Ultimaker/Ultimaker3Extended/1011/1011-E/1011-E.STEP

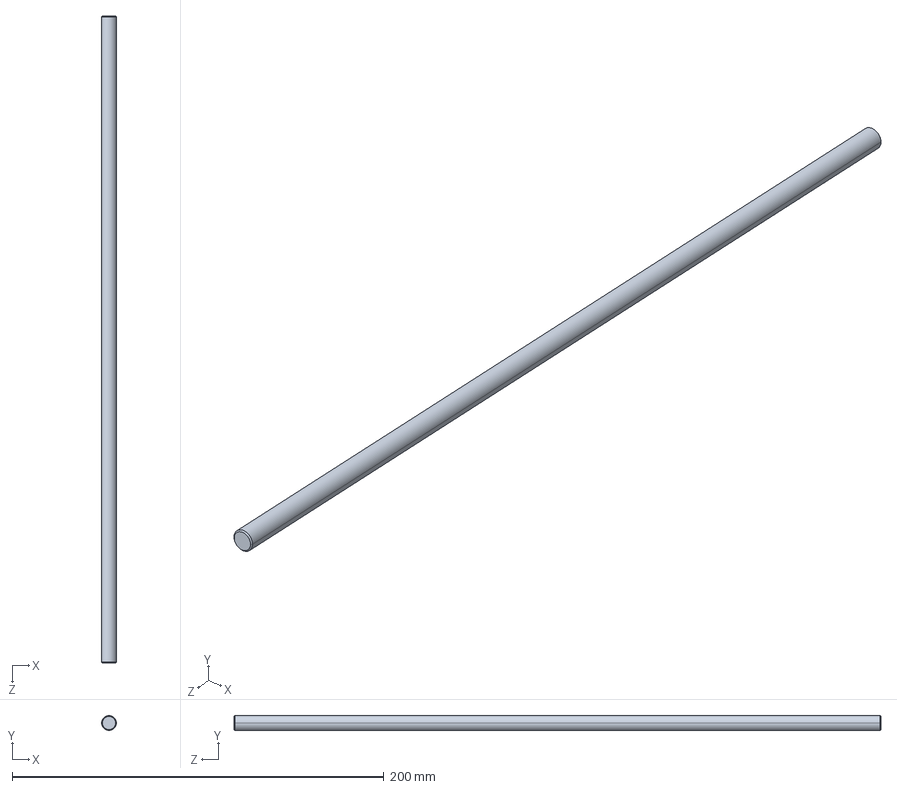
[picture p1: CAD file, 2017-10-18]
1011/1011-E/1011-E.STEP
8.00 x 8.00 x 348.0 mm
