Ultimaker/Ultimaker3Extended/1012/1012-E/1012-E.STEP

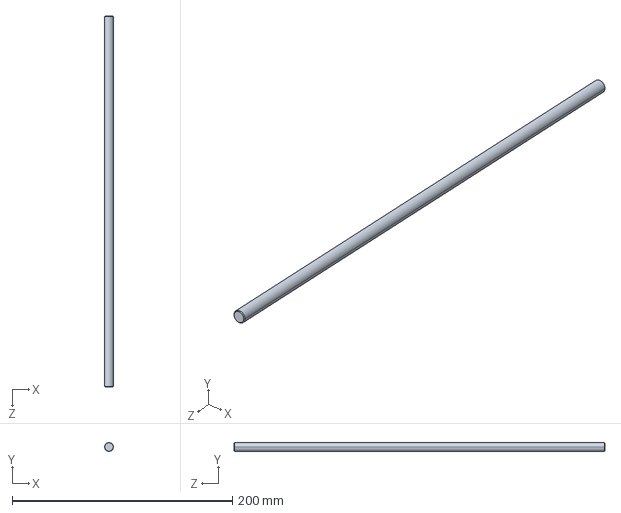
[picture p2: CAD file, 2017-10-18]
1012/1012-E/1012-E.STEP
8.00 x 8.00 x 337.0 mm
