Ultimaker/Ultimaker3Extended/1024/1024-F/1024-F.STEP

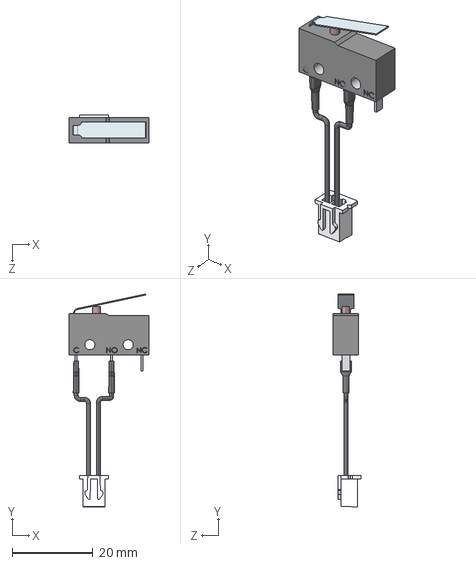
[picture p3: CAD file, 2017-10-18]
1024/1024-F/1024-F.STEP
19.8 x 52.9 x 6.90 mm
