Ultimaker/Ultimaker3Extended/1056/1056-B/1056-B.STEP

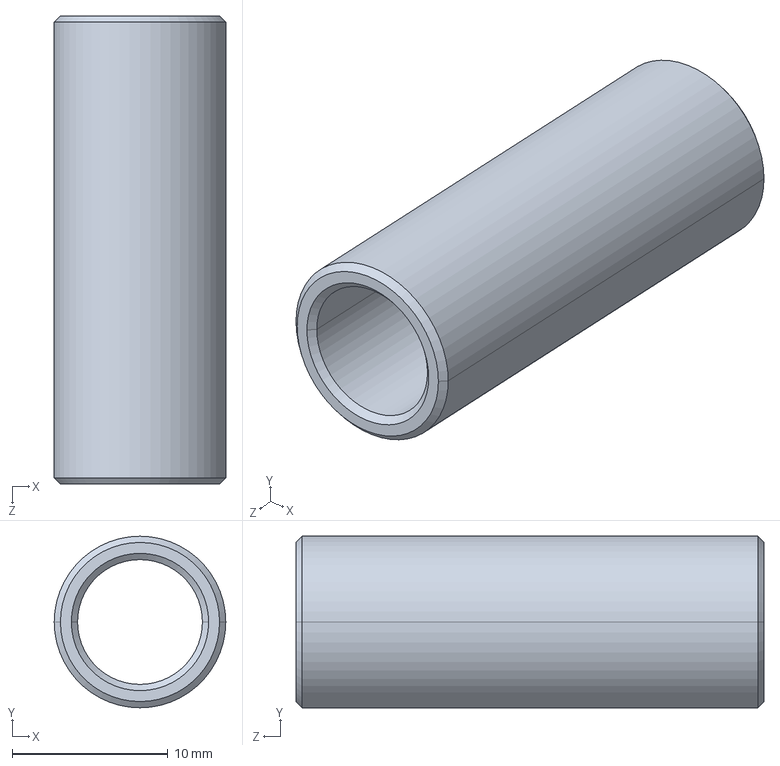
[picture p4: CAD file, 2017-10-18]
1056/1056-B/1056-B.STEP
11.0 x 11.0 x 30.0 mm
