Ultimaker/Ultimaker3Extended/1069/1069-C/1069-C.STEP

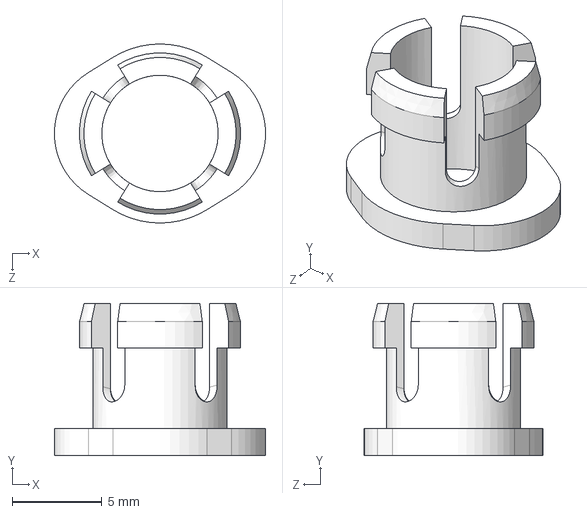
[picture p5: CAD file, 2017-10-18]
1069/1069-C/1069-C.STEP
11.8 x 8.50 x 10.00 mm
