Ultimaker/Ultimaker3Extended/1083/1083-A/1083-Z1P-A.STEP

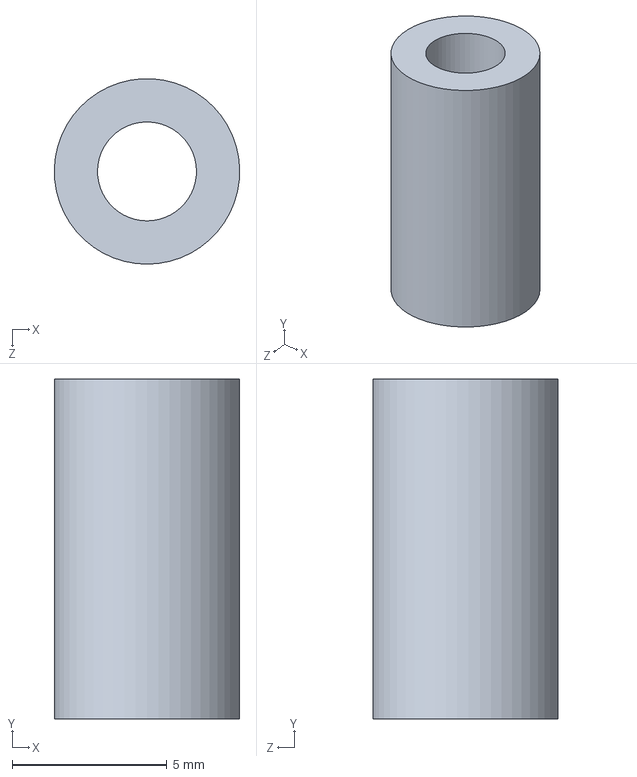
[picture p6: CAD file, 2017-10-18]
1083/1083-A/1083-Z1P-A.STEP
6.00 x 11.0 x 5.99 mm
