Ultimaker/Ultimaker3Extended/1155/1155-G/1155-G.STEP

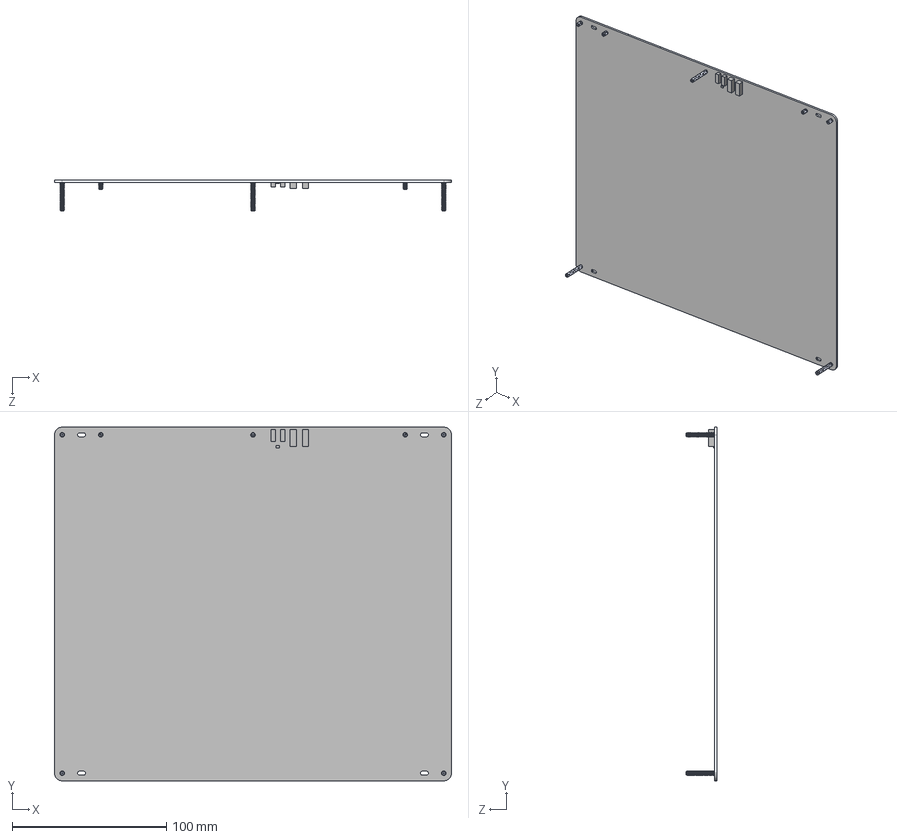
[picture p7: CAD file, 2017-10-18]
1155/1155-G/1155-G.STEP
257.0 x 229.0 x 20.0 mm
1155-D
FH-M3-xZI_FH-M3-6ZI x 4
FH-M3-xZI_FH-M3-20ZI x 3
