Ultimaker/Ultimaker3Extended/1156/1156-B/1156-B.STEP

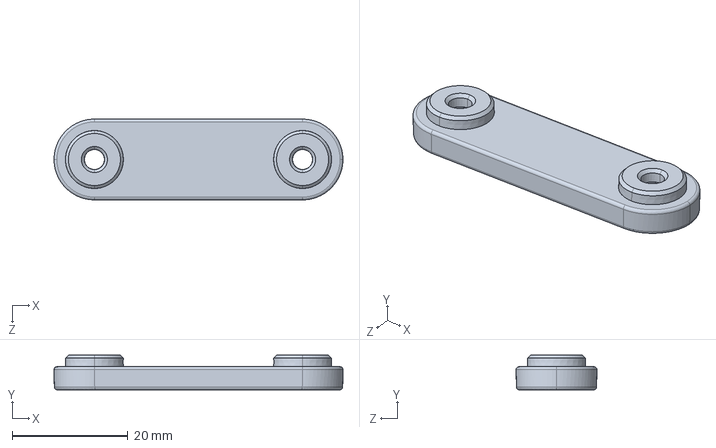
[picture p8: CAD file, 2017-10-18]
1156/1156-B/1156-B.STEP
50.0 x 6.00 x 14.0 mm
