Ultimaker/Ultimaker3Extended/1165/1165-B/1165-B.STEP

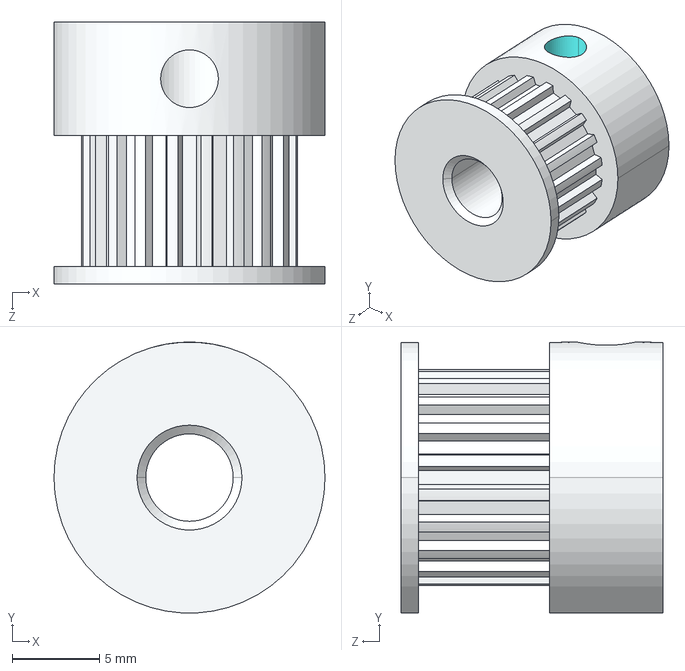
[picture p9: CAD file, 2017-10-18]
1165/1165-B/1165-B.STEP
15.5 x 15.5 x 15.0 mm
