Ultimaker/Ultimaker3Extended/1166/1166-C/1166-C.STEP

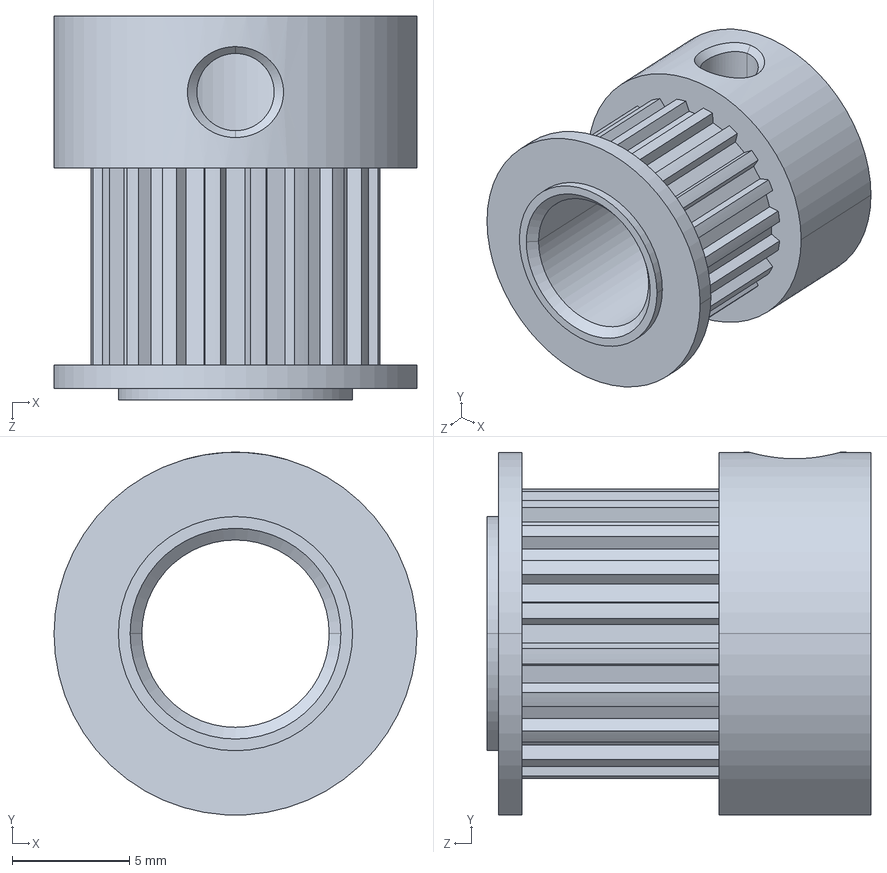
[picture p10: CAD file, 2017-10-18]
1166/1166-C/1166-C.STEP
15.5 x 15.5 x 16.4 mm
