Ultimaker/Ultimaker3Extended/1167/1167-E/1167-E.STEP

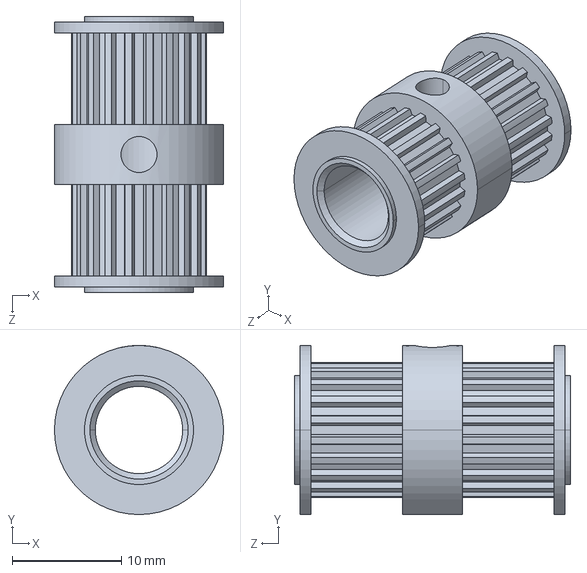
[picture p11: CAD file, 2017-10-18]
1167/1167-E/1167-E.STEP
15.5 x 15.5 x 25.3 mm
