Ultimaker/Ultimaker3Extended/1168/1168-C/1168-C.STEP

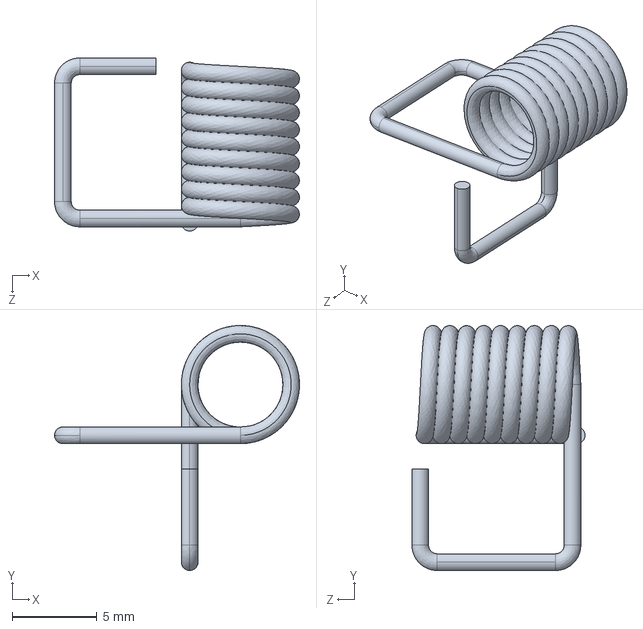
[picture p12: CAD file, 2017-10-18]
1168/1168-C/1168-C.STEP
14.5 x 14.5 x 10.2 mm
