Ultimaker/Ultimaker3Extended/1170/1170-C/1170-C.STEP

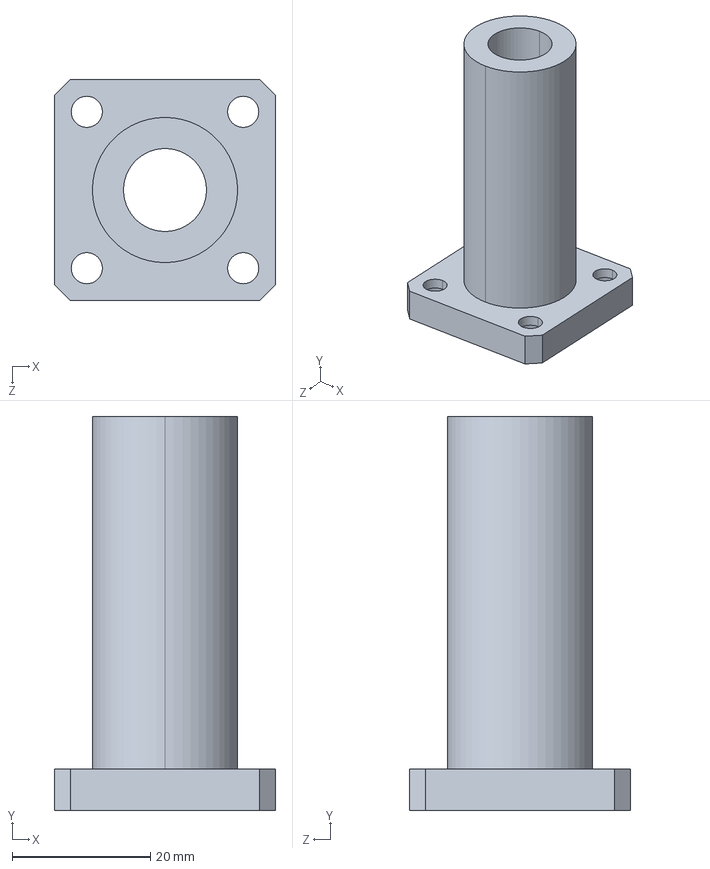
[picture p13: CAD file, 2017-10-18]
1170/1170-C/1170-C.STEP
32.0 x 57.0 x 32.0 mm
