Ultimaker/Ultimaker3Extended/1172/1172-B/1172-B.STEP

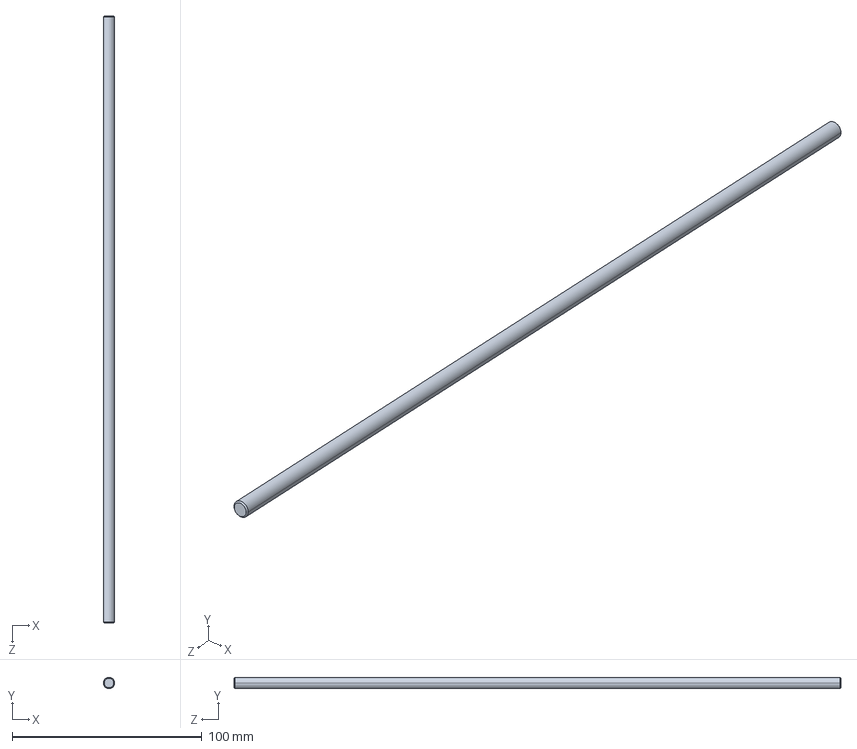
[picture p14: CAD file, 2017-10-18]
1172/1172-B/1172-B.STEP
6.00 x 6.00 x 320.0 mm
