Ultimaker/Ultimaker3Extended/1174/1174-A/1174-A.STEP

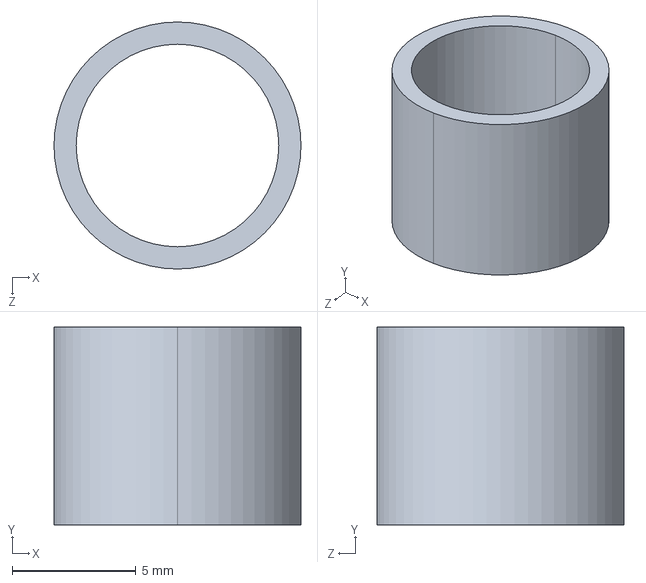
[picture p15: CAD file, 2017-10-18]
1174/1174-A/1174-A.STEP
10.00 x 8.00 x 10.00 mm
