Ultimaker/Ultimaker3Extended/1175/1175-A/1175-A.STEP

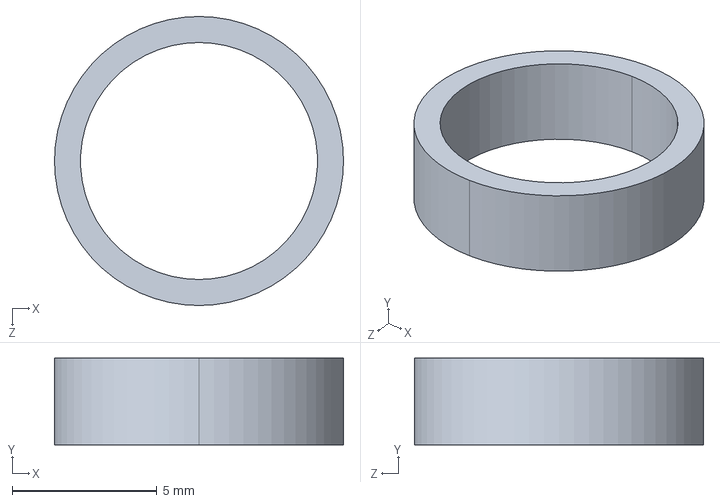
[picture p16: CAD file, 2017-10-18]
1175/1175-A/1175-A.STEP
10.00 x 3.00 x 10.00 mm
