Ultimaker/Ultimaker3Extended/1178/1178-B/1178-B.STEP

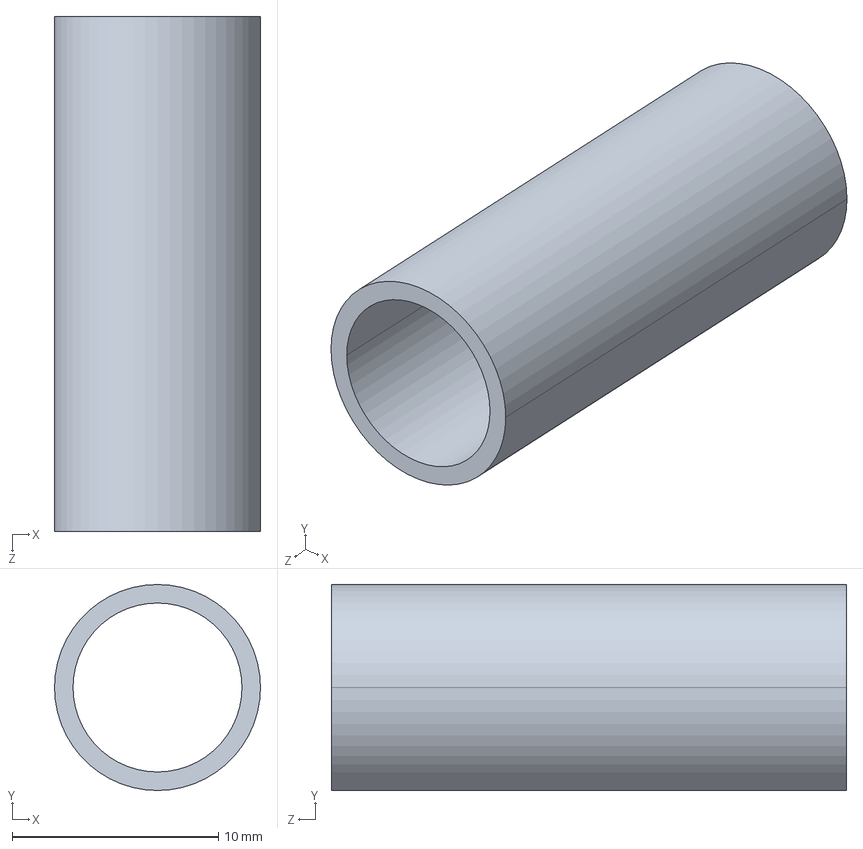
[picture p17: CAD file, 2017-10-18]
1178/1178-B/1178-B.STEP
10.0 x 10.0 x 25.0 mm
