Ultimaker/Ultimaker3Extended/1187/1187-B/1187-B.STEP

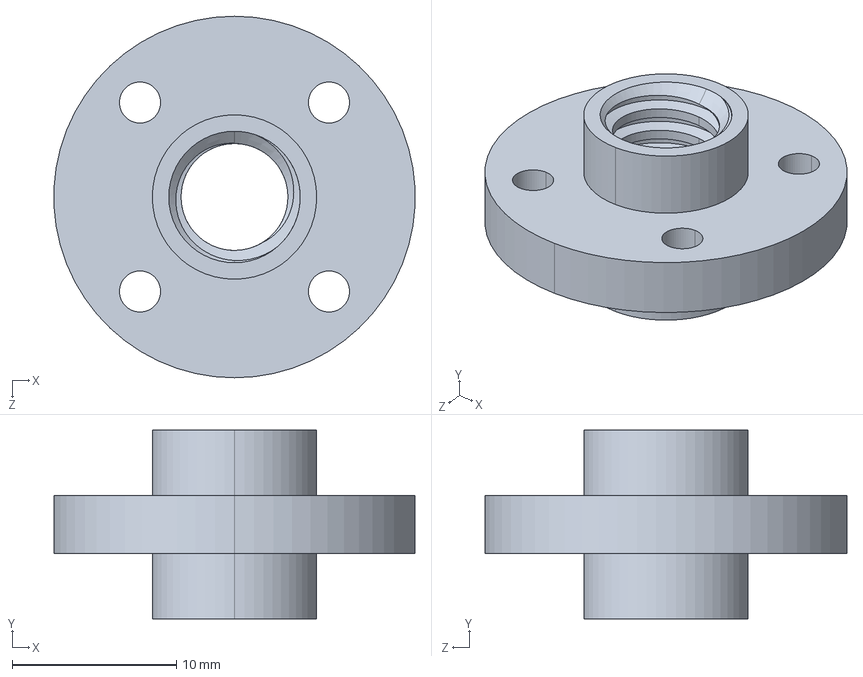
[picture p18: CAD file, 2017-10-18]
1187/1187-B/1187-B.STEP
22.0 x 11.5 x 22.0 mm
