Ultimaker/Ultimaker3Extended/1188/1188-A/1188-B2P-A.STEP

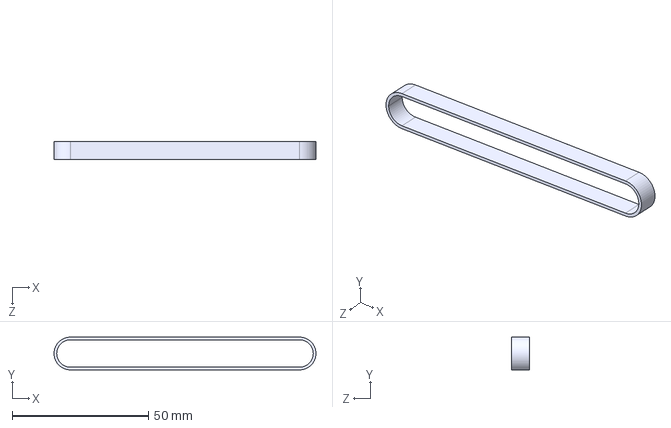
[picture p19: CAD file, 2017-10-18]
1188/1188-A/1188-B2P-A.STEP
96.0 x 12.0 x 6.50 mm
