Ultimaker/Ultimaker3Extended/1200/1200-B/1200-B.STEP

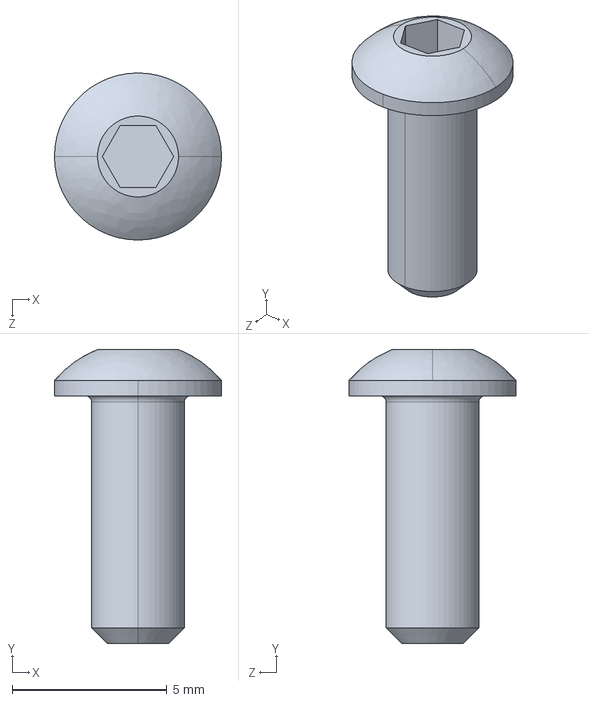
[picture p20: CAD file, 2017-10-18]
1200/1200-B/1200-B.STEP
5.40 x 9.50 x 5.40 mm
