Ultimaker/Ultimaker3Extended/1201/1201-D/1201-D.STEP

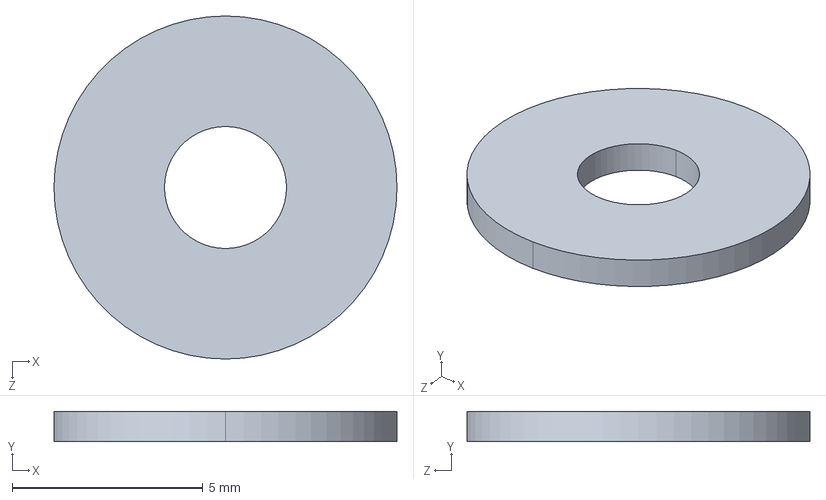
[picture p21: CAD file, 2017-10-18]
1201/1201-D/1201-D.STEP
9.00 x 0.8 x 9.00 mm
