Ultimaker/Ultimaker3Extended/1202/1202-C/1202-C.STEP

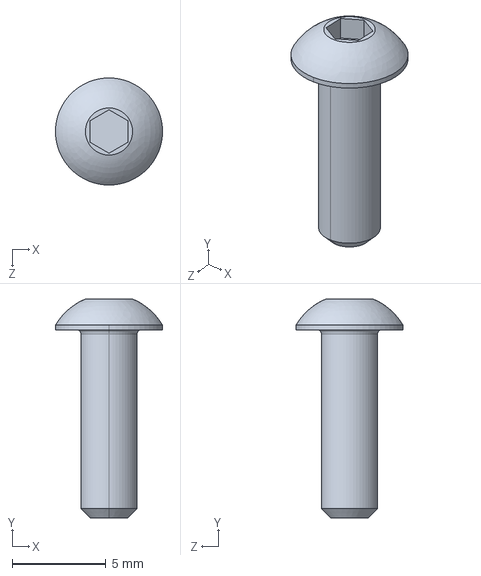
[picture p22: CAD file, 2017-10-18]
1202/1202-C/1202-C.STEP
5.70 x 11.7 x 5.70 mm
