Ultimaker/Ultimaker3Extended/1203/1203-C/1203-C.STEP

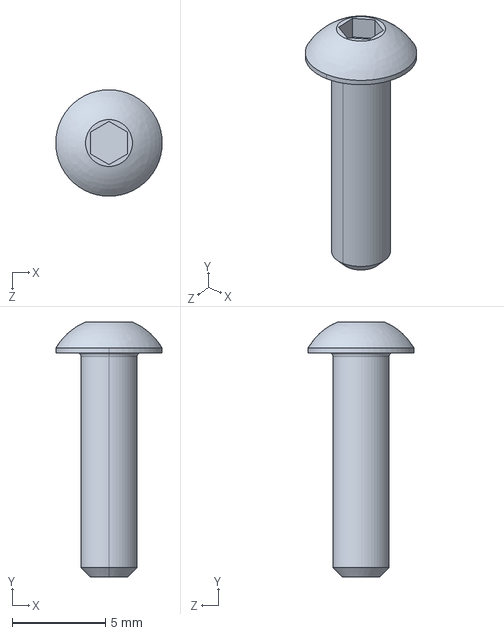
[picture p23: CAD file, 2017-10-18]
1203/1203-C/1203-C.STEP
5.70 x 13.7 x 5.70 mm
