Ultimaker/Ultimaker3Extended/1204/1204-C/1204-C.STEP

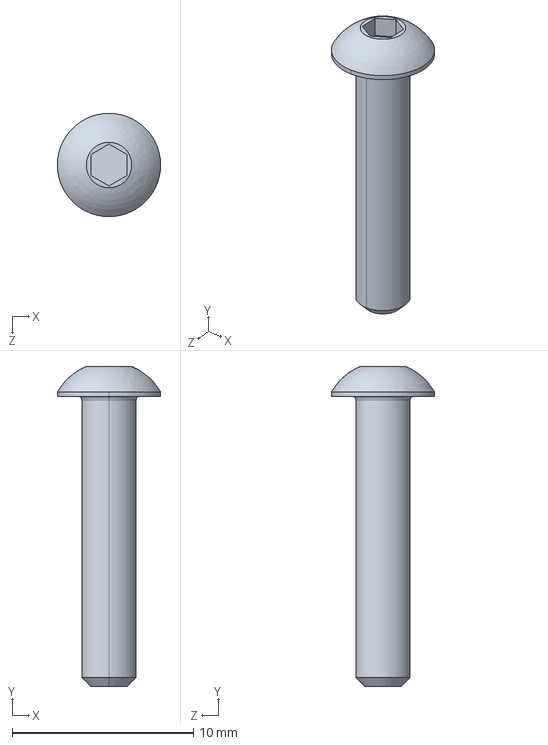
[picture p24: CAD file, 2017-10-18]
1204/1204-C/1204-C.STEP
5.70 x 17.7 x 5.70 mm
