Ultimaker/Ultimaker3Extended/1205/1205-C/1205-C.STEP

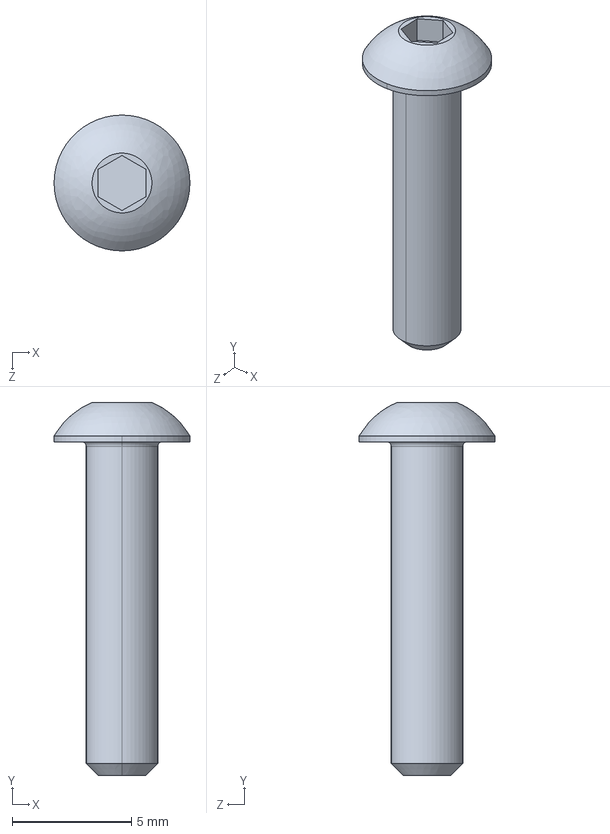
[picture p25: CAD file, 2017-10-18]
1205/1205-C/1205-C.STEP
5.70 x 15.7 x 5.70 mm
