Ultimaker/Ultimaker3Extended/1206/1206-C/1206-C.STEP

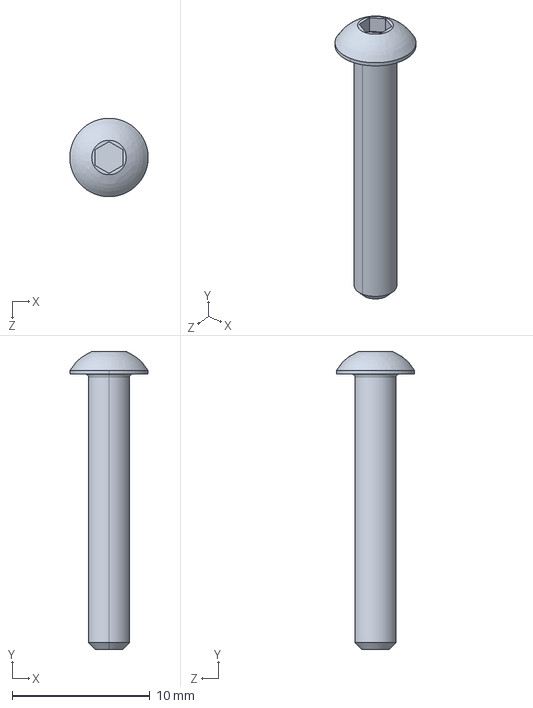
[picture p26: CAD file, 2017-10-18]
1206/1206-C/1206-C.STEP
5.70 x 21.7 x 5.70 mm
