Ultimaker/Ultimaker3Extended/1207/1207-C/1207-C.STEP

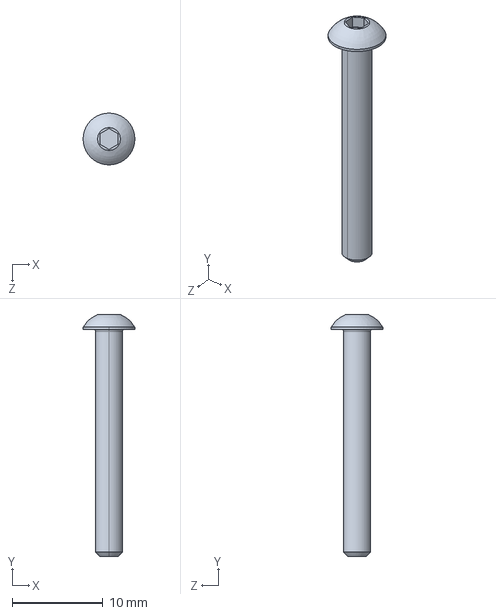
[picture p27: CAD file, 2017-10-18]
1207/1207-C/1207-C.STEP
5.70 x 26.6 x 5.70 mm
