Ultimaker/Ultimaker3Extended/1209/1209-D/1209-D.STEP

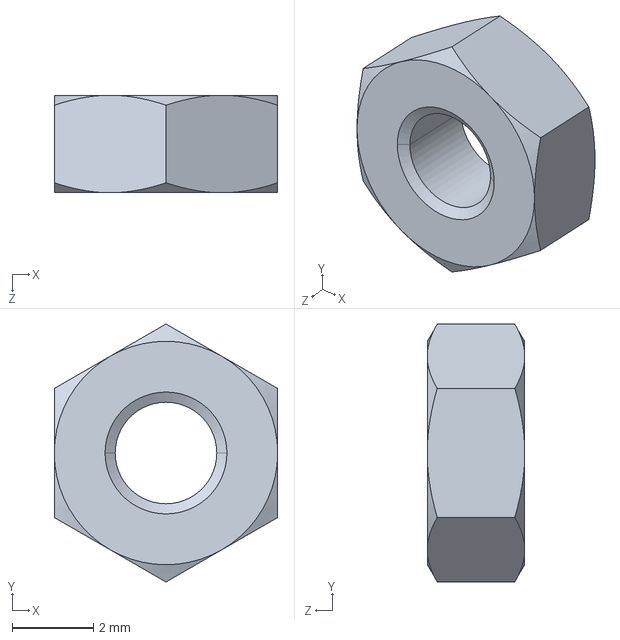
[picture p28: CAD file, 2017-10-18]
1209/1209-D/1209-D.STEP
5.50 x 6.35 x 2.40 mm
