Ultimaker/Ultimaker3Extended/1213/1213-C/1213-C.STEP

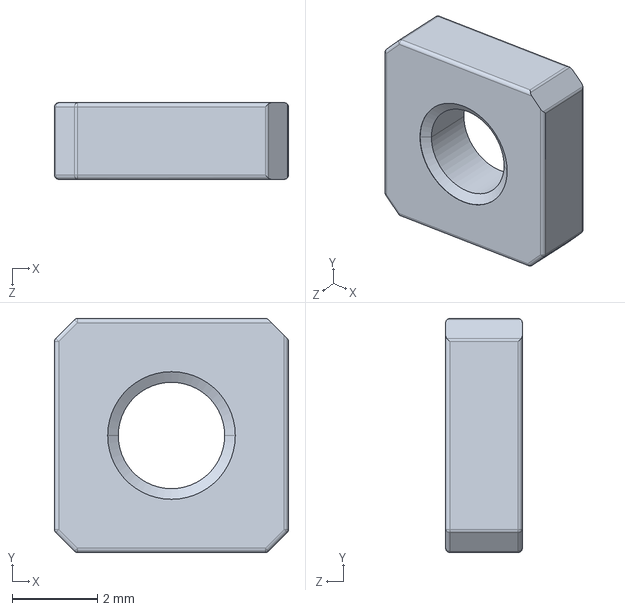
[picture p29: CAD file, 2017-10-18]
1213/1213-C/1213-C.STEP
5.50 x 5.50 x 1.80 mm
