Ultimaker/Ultimaker3Extended/1214/1214-B/1214-B.STEP

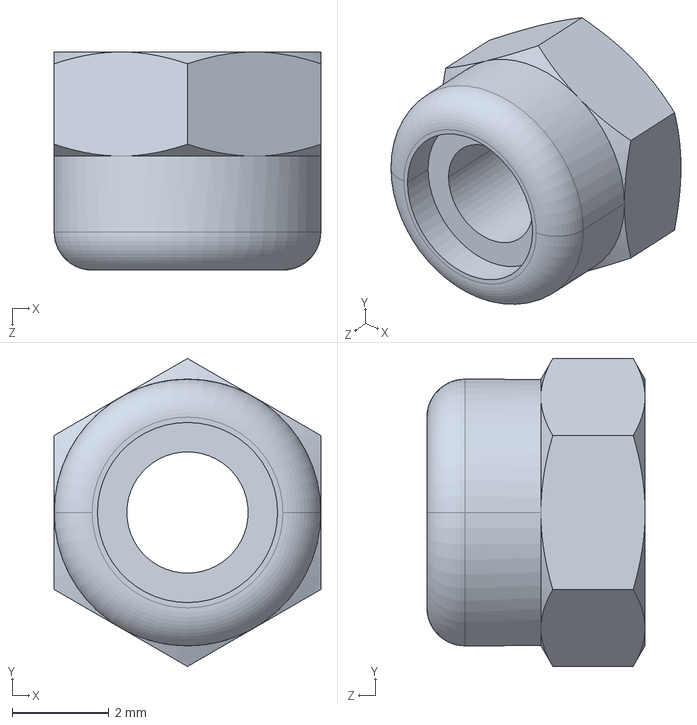
[picture p30: CAD file, 2017-10-18]
1214/1214-B/1214-B.STEP
5.50 x 6.35 x 4.50 mm
