Ultimaker/Ultimaker3Extended/1217/1217-B/1217-B.STEP

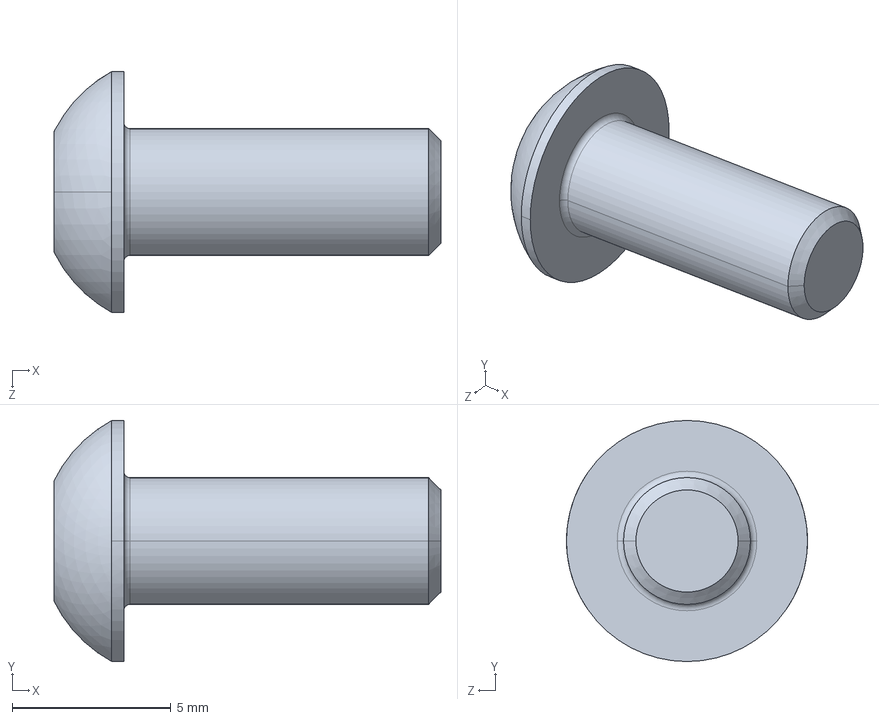
[picture p31: CAD file, 2017-10-18]
1217/1217-B/1217-B.STEP
12.2 x 7.60 x 7.60 mm
