Ultimaker/Ultimaker3Extended/1220/1220-B/1220-B.STEP

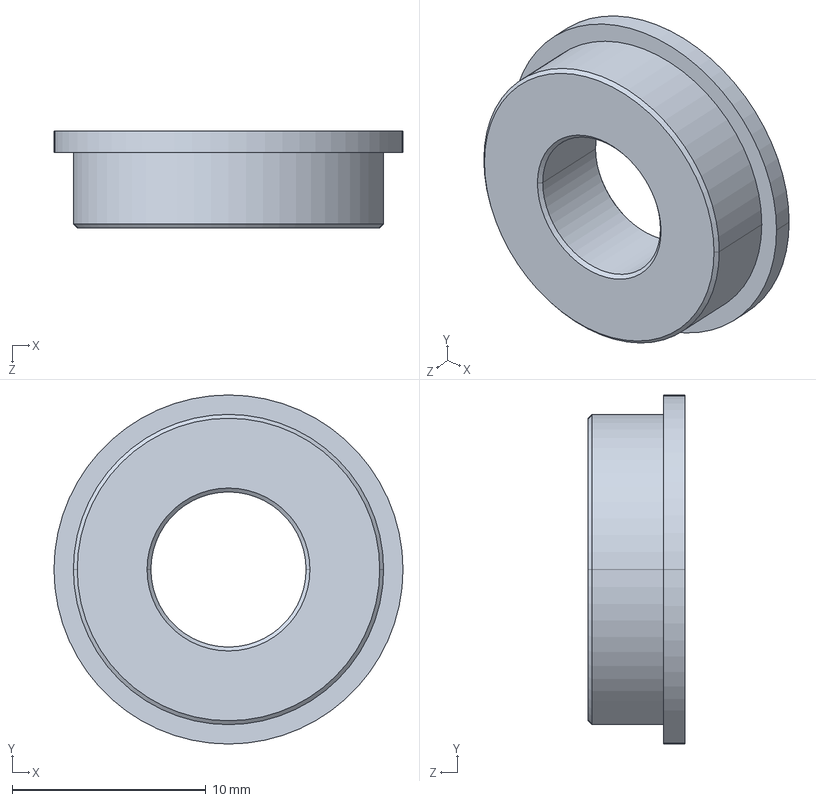
[picture p32: CAD file, 2017-10-18]
1220/1220-B/1220-B.STEP
18.0 x 18.0 x 5.00 mm
