Ultimaker/Ultimaker3Extended/1241/1241-C/1241-C.STEP

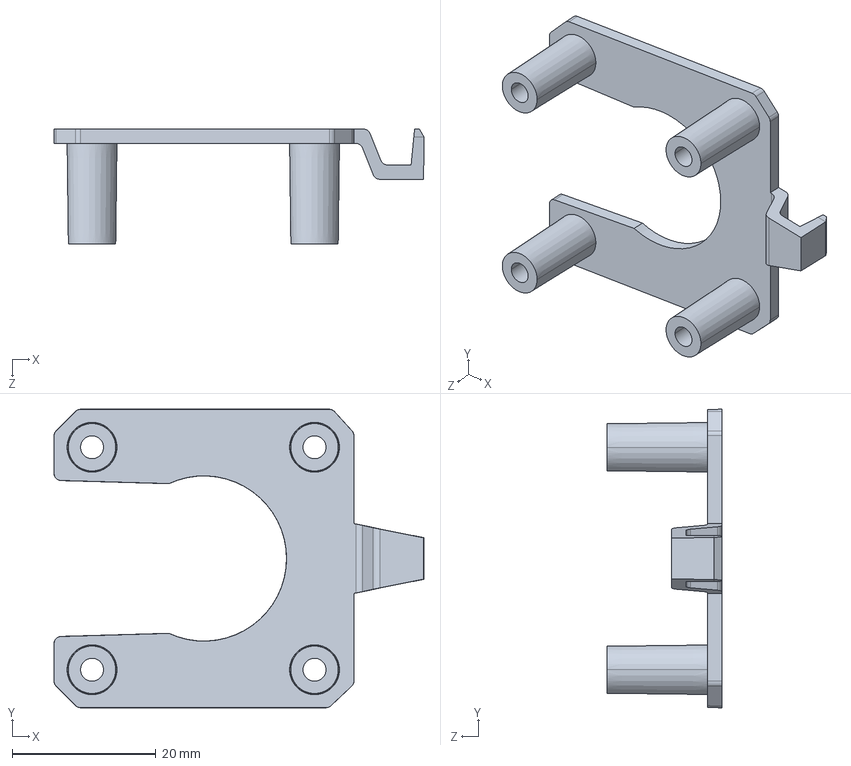
[picture p33: CAD file, 2017-10-18]
1241/1241-C/1241-C.STEP
51.6 x 41.6 x 16.0 mm
