Ultimaker/Ultimaker3Extended/1244/1244-B/1244-B.STEP

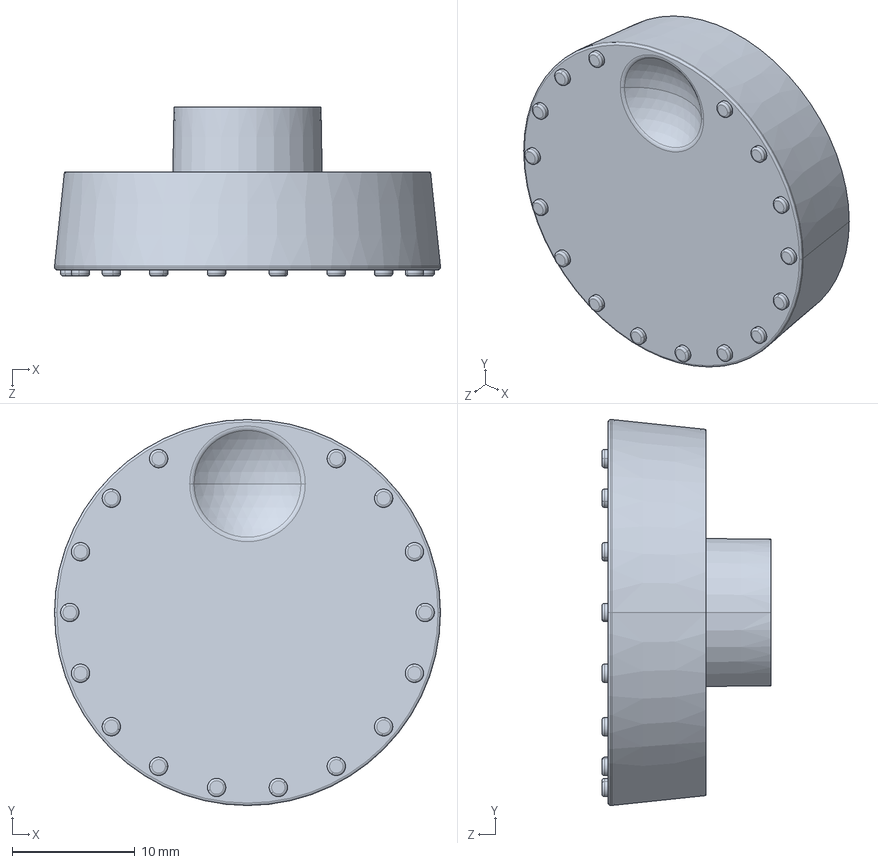
[picture p34: CAD file, 2017-10-18]
1244/1244-B/1244-B.STEP
31.5 x 31.5 x 13.8 mm
