Ultimaker/Ultimaker3Extended/1245/1245-D/1245-D.STEP

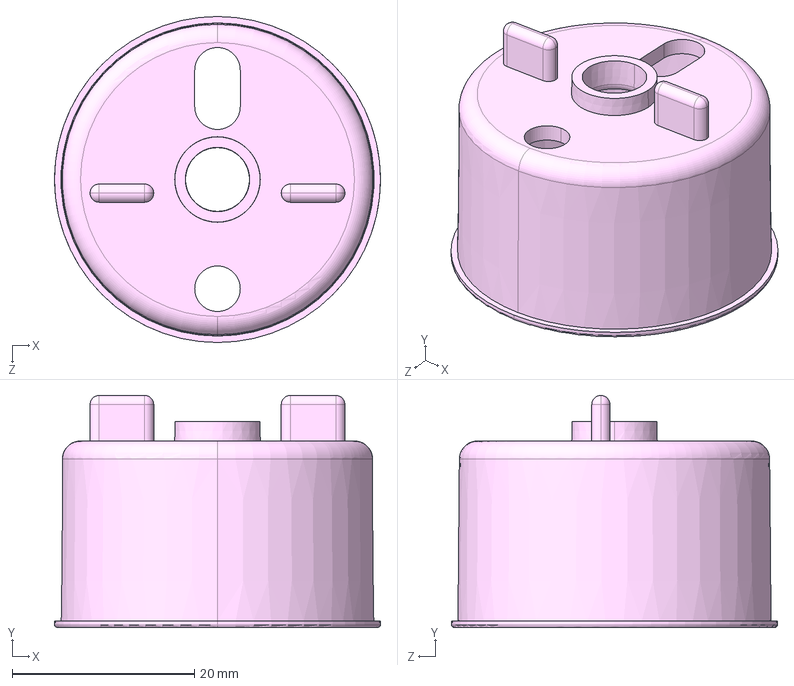
[picture p35: CAD file, 2017-10-18]
1245/1245-D/1245-D.STEP
35.8 x 25.5 x 35.8 mm
