Ultimaker/Ultimaker3Extended/1252/1252-D/1252-D.STEP

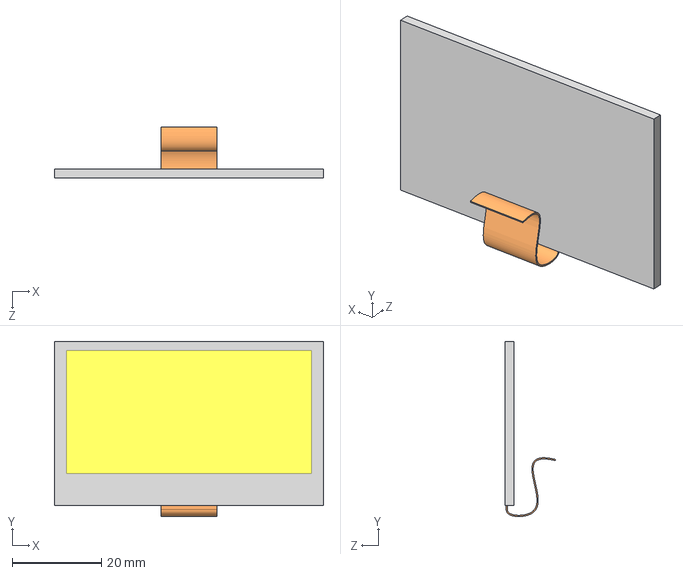
[picture p36: CAD file, 2017-10-18]
1252/1252-D/1252-D.STEP
60.3 x 39.3 x 11.3 mm
