Ultimaker/Ultimaker3Extended/1255/1255-B/1255-B.STEP

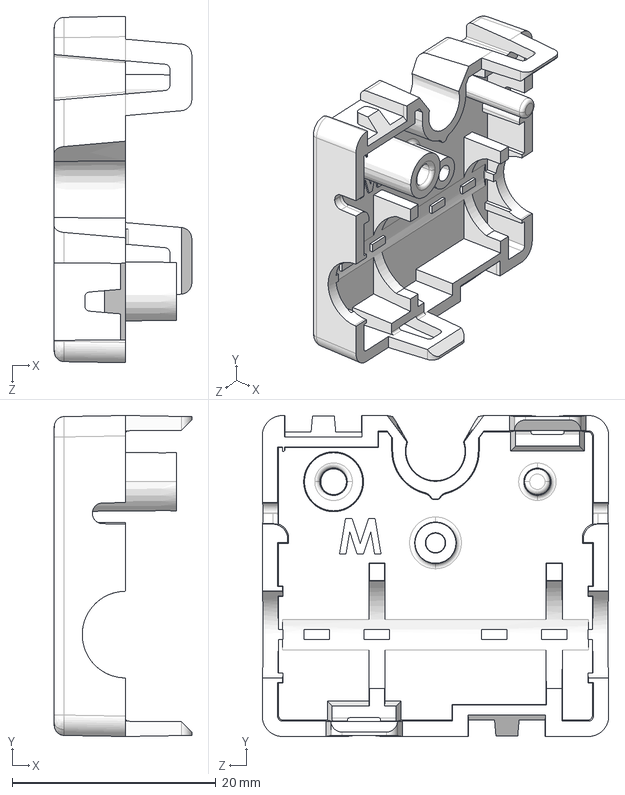
[picture p37: CAD file, 2017-10-18]
1255/1255-B/1255-B.STEP
13.5 x 31.5 x 34.0 mm
