Ultimaker/Ultimaker3Extended/1256/1256-B/1256-B.STEP

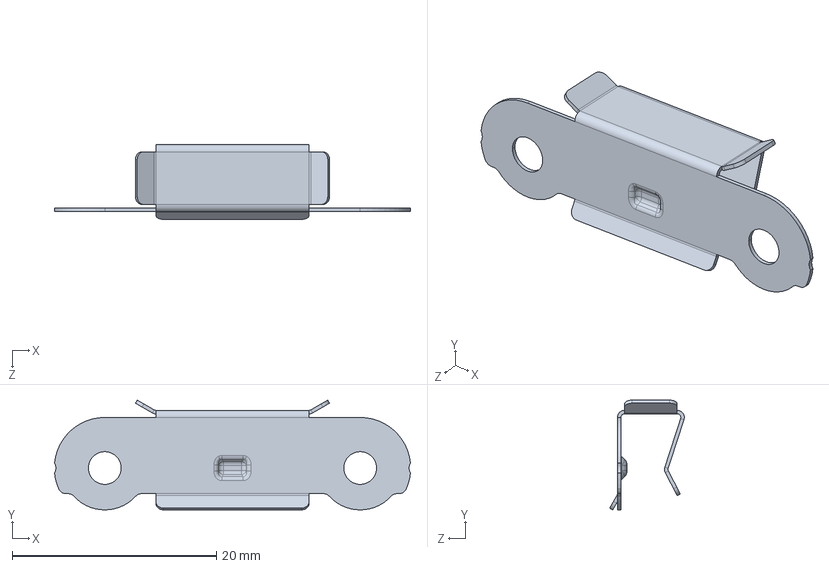
[picture p38: CAD file, 2017-10-18]
1256/1256-B/1256-B.STEP
34.8 x 10.7 x 7.32 mm
