Ultimaker/Ultimaker3Extended/1266/1266-D/1266-D.STEP

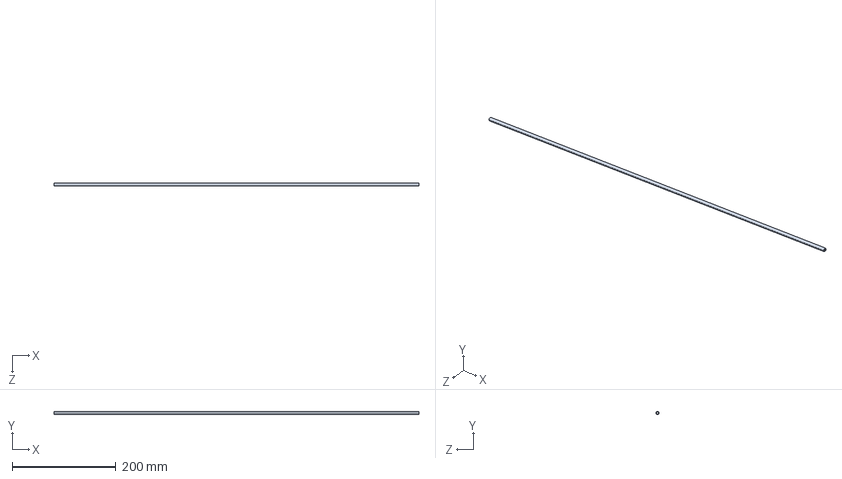
[picture p39: CAD file, 2017-10-18]
1266/1266-D/1266-D.STEP
705.0 x 6.35 x 6.35 mm
