Ultimaker/Ultimaker3Extended/1279/1279-D/1279-D.STEP

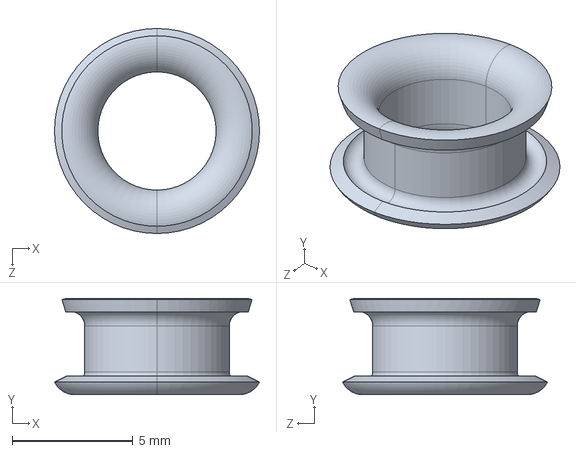
[picture p40: CAD file, 2017-10-18]
1279/1279-D/1279-D.STEP
8.50 x 4.00 x 8.50 mm
