Ultimaker/Ultimaker3Extended/1287/1287-B/1287-B.STEP

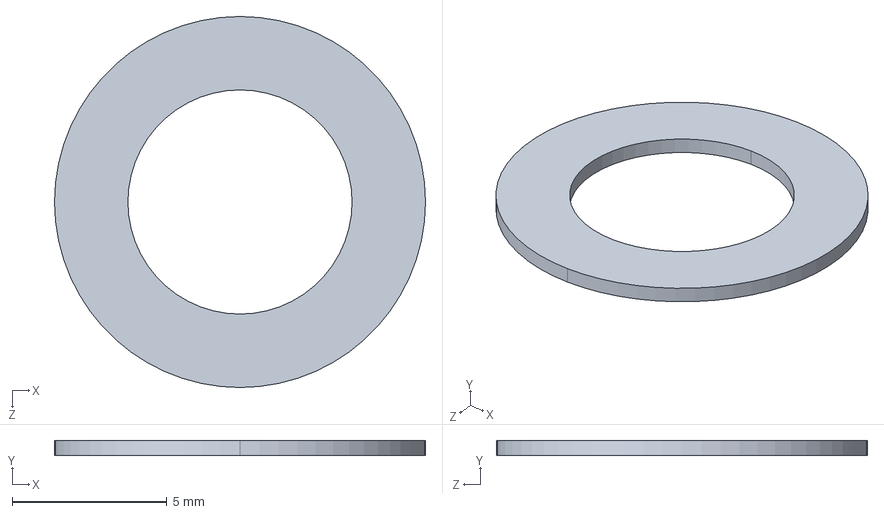
[picture p41: CAD file, 2017-10-18]
1287/1287-B/1287-B.STEP
12.0 x 0.5 x 12.0 mm
