Ultimaker/Ultimaker3Extended/1288/1288-B/1288-B.STEP

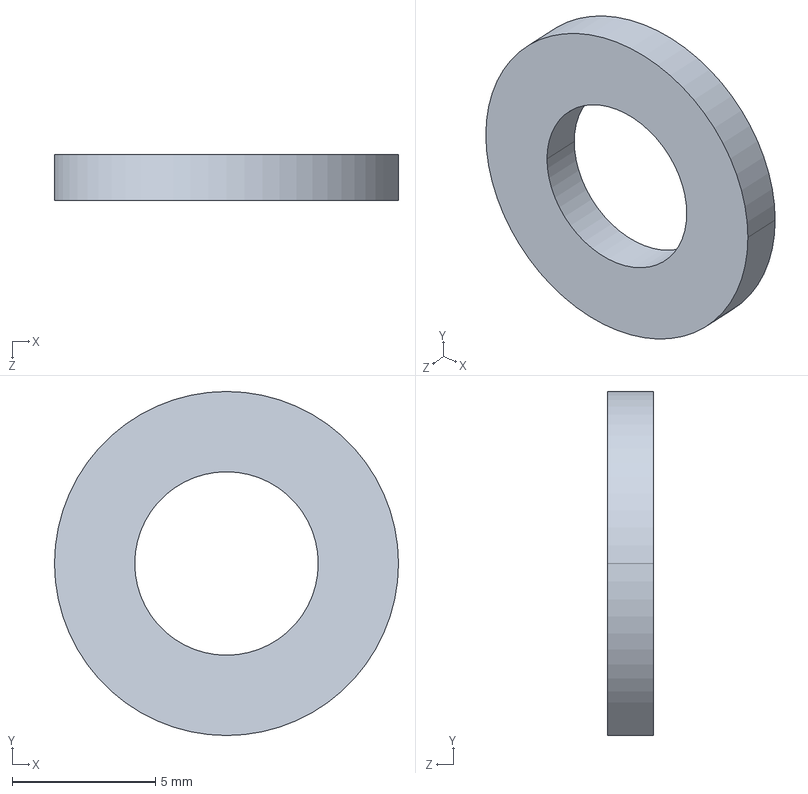
[picture p42: CAD file, 2017-10-18]
1288/1288-B/1288-B.STEP
12.0 x 12.0 x 1.60 mm
