Ultimaker/Ultimaker3Extended/1292/1292-A/1292-A.STEP

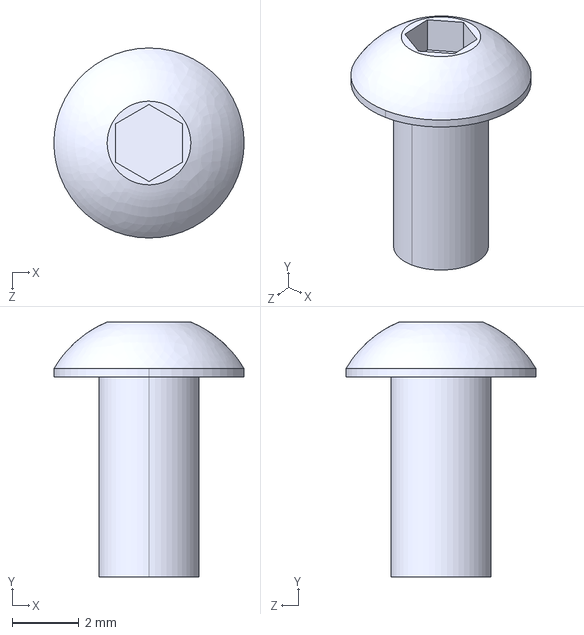
[picture p43: CAD file, 2017-10-18]
1292/1292-A/1292-A.STEP
5.70 x 7.65 x 5.70 mm
