Ultimaker/Ultimaker3Extended/1294/1294-B/1294-B.STEP

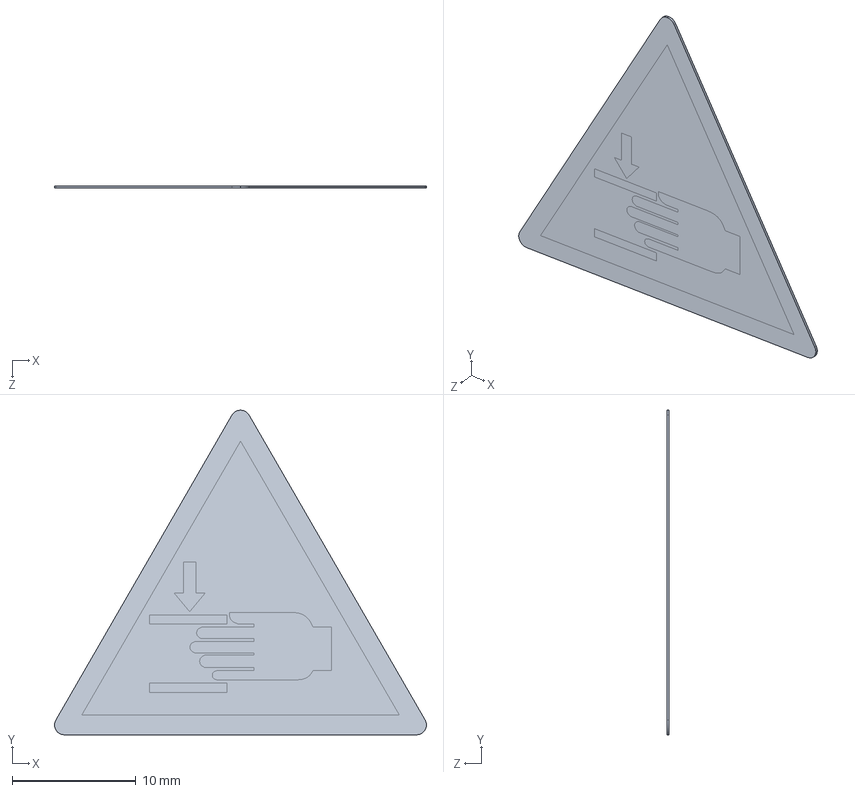
[picture p44: CAD file, 2017-10-18]
1294/1294-B/1294-B.STEP
30.0 x 26.2 x 0.2 mm
