Ultimaker/Ultimaker3Extended/1315/1315-B/1315-B.STEP

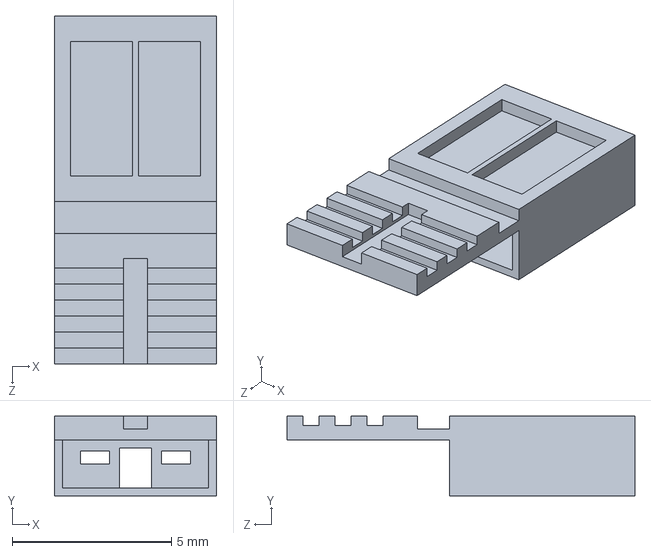
[picture p45: CAD file, 2017-10-18]
1315/1315-B/1315-B.STEP
5.08 x 2.50 x 10.9 mm
