Ultimaker/Ultimaker3Extended/1354/1354-B/1354-B.STEP

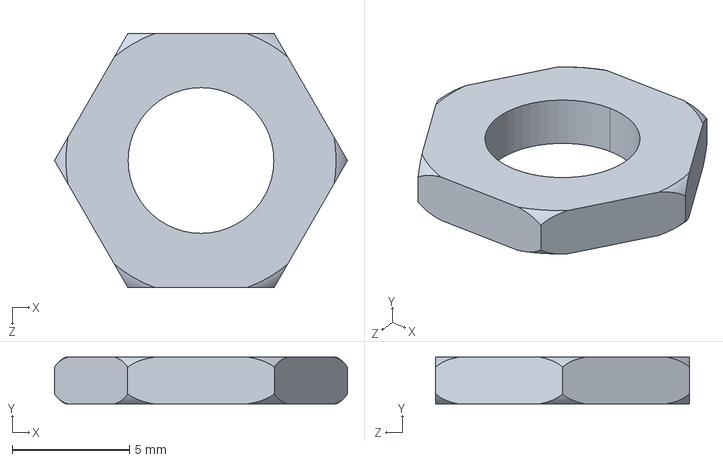
[picture p46: CAD file, 2017-10-18]
1354/1354-B/1354-B.STEP
12.5 x 2.00 x 10.8 mm
