Ultimaker/Ultimaker3Extended/1363/1363-D/1363-D.STEP

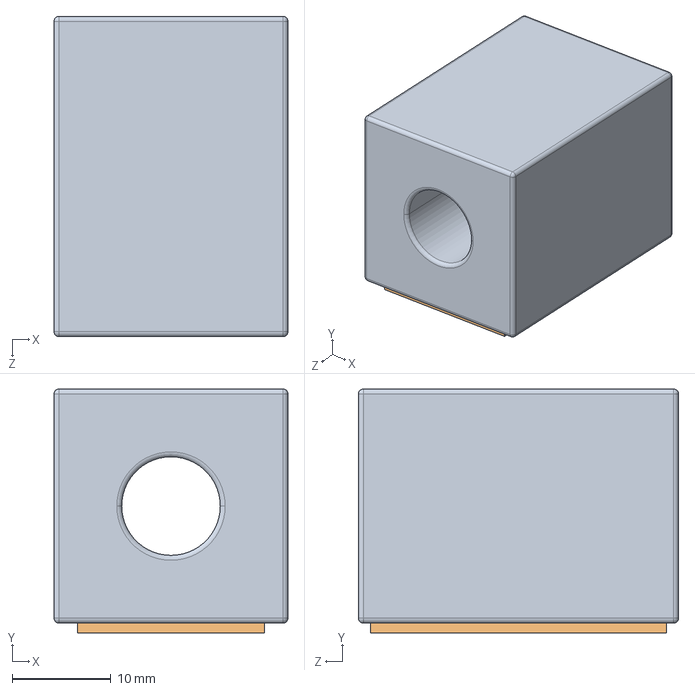
[picture p47: CAD file, 2017-10-18]
1363/1363-D/1363-D.STEP
23.8 x 24.8 x 32.5 mm
