Ultimaker/Ultimaker3Extended/1479/1479-B/1479-B.STEP

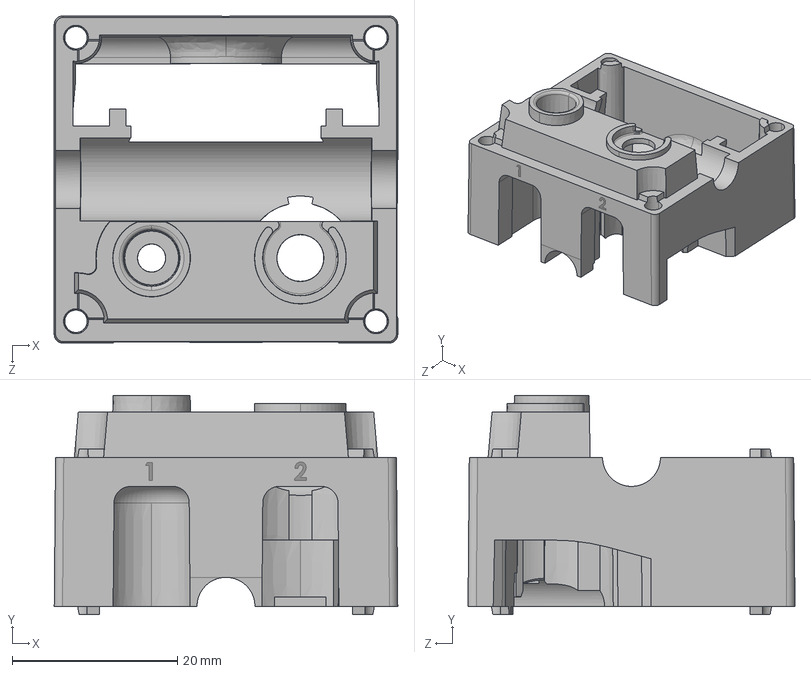
[picture p48: CAD file, 2017-10-18]
1479/1479-B/1479-B.STEP
41.6 x 26.5 x 39.6 mm
