Ultimaker/Ultimaker3Extended/1480/1480-B/1480-B.STEP

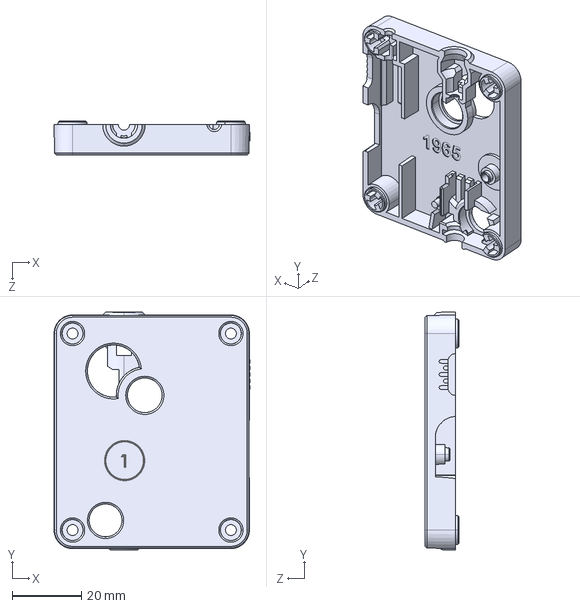
[picture p49: CAD file, 2017-10-18]
1480/1480-B/1480-B.STEP
56.4 x 68.5 x 9.75 mm
