Ultimaker/Ultimaker3Extended/1482/1482-B/1482-B.STEP

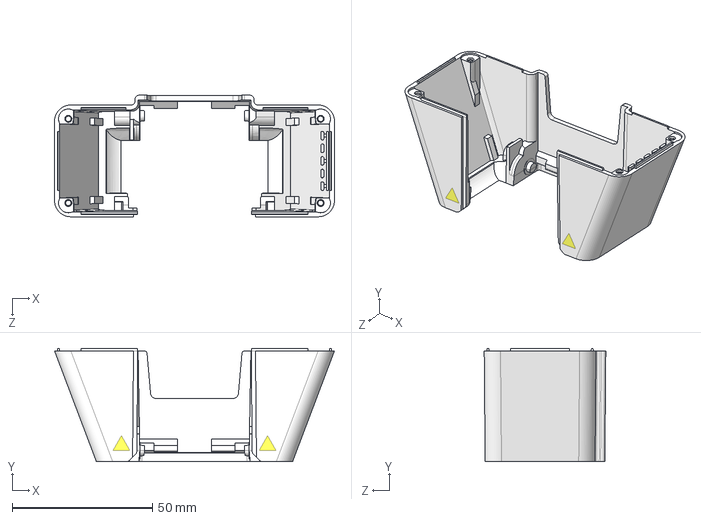
[picture p50: CAD file, 2017-10-18]
1482/1482-B/1482-B.STEP
99.9 x 40.4 x 43.4 mm
