Ultimaker/Ultimaker3Extended/1545/1545-A/1545-A.STEP

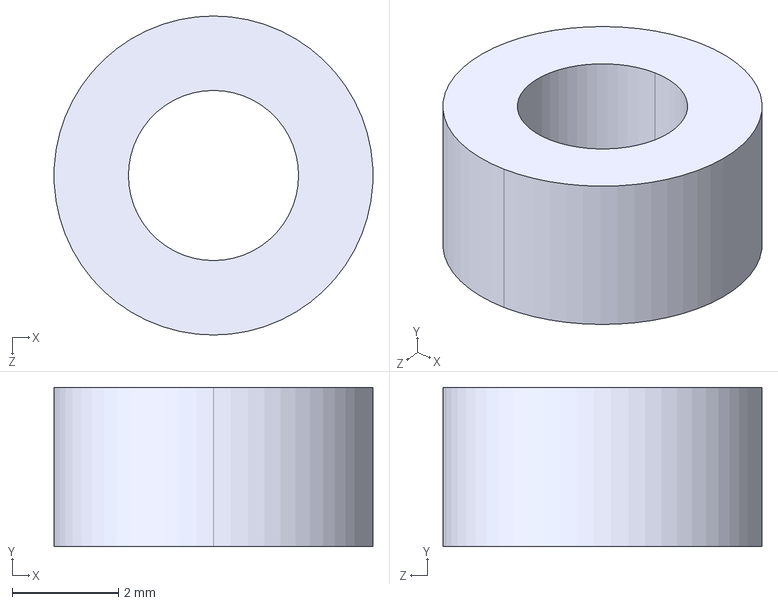
[picture p51: CAD file, 2017-10-18]
1545/1545-A/1545-A.STEP
5.99 x 3.00 x 6.00 mm
