Ultimaker/Ultimaker3Extended/1723/1723-A/1723-A.STEP

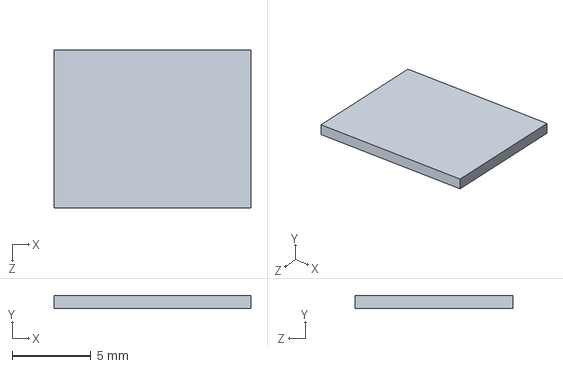
[picture p52: CAD file, 2017-10-18]
1723/1723-A/1723-A.STEP
12.5 x 0.8 x 10.0 mm
