Ultimaker/Ultimaker3Extended/1725/1725-G/1725-G.STEP

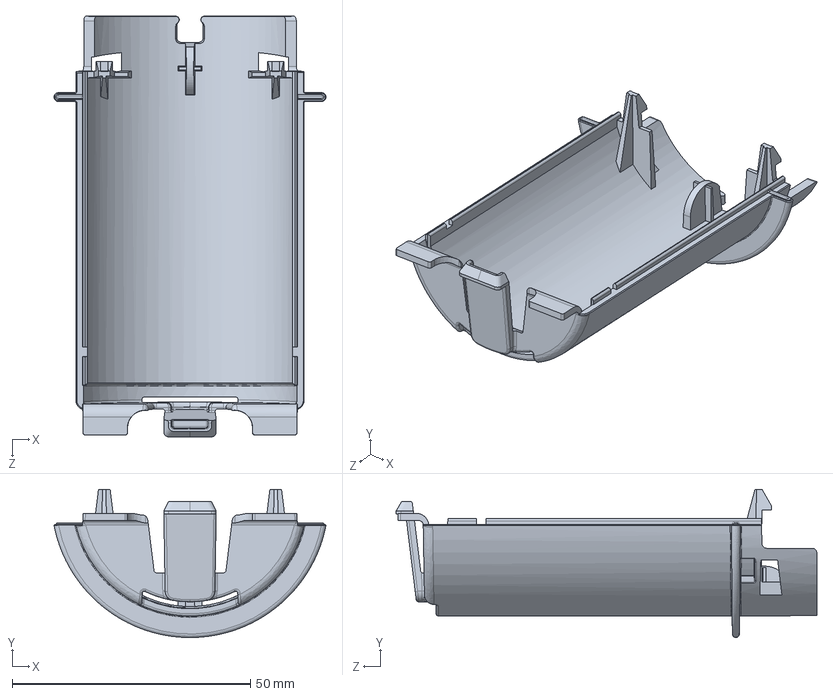
[picture p53: CAD file, 2017-10-23]
1725/1725-G/1725-G.STEP
57.1 x 31.1 x 88.4 mm
