Ultimaker/Ultimaker3Extended/1726/1726-B/1726-B.STEP

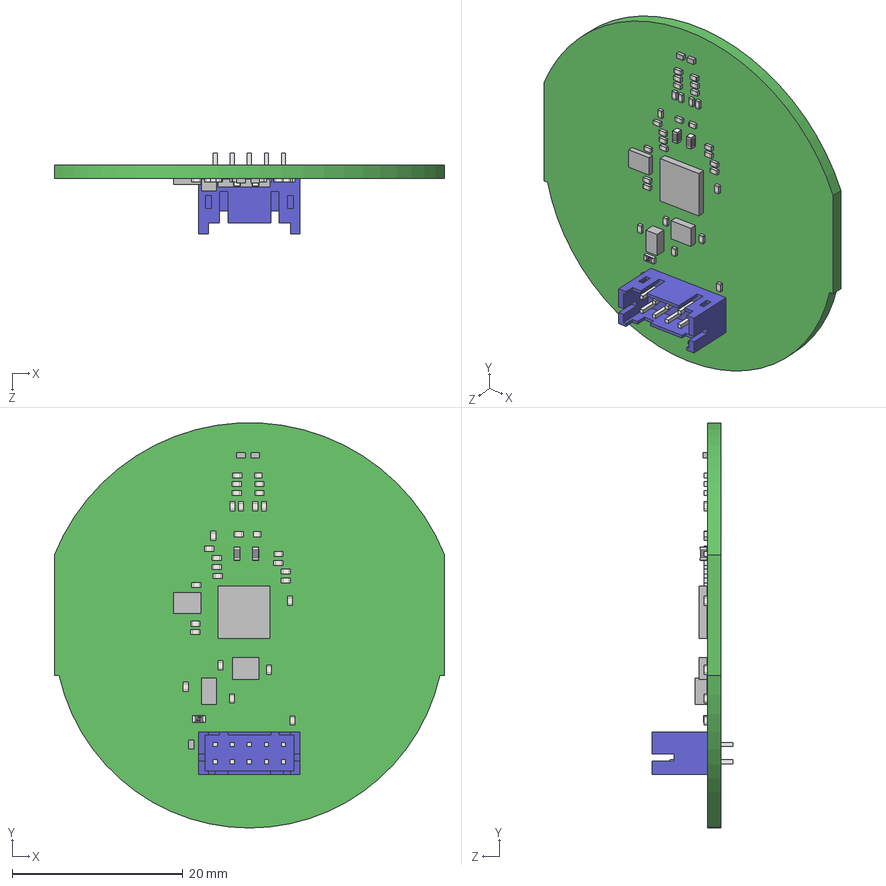
[picture p54: CAD file, 2017-10-23]
1726/1726-B/1726-B.STEP
45.7 x 47.4 x 9.50 mm
