Ultimaker/Ultimaker3Extended/1727/1727-C/1727-C.STEP

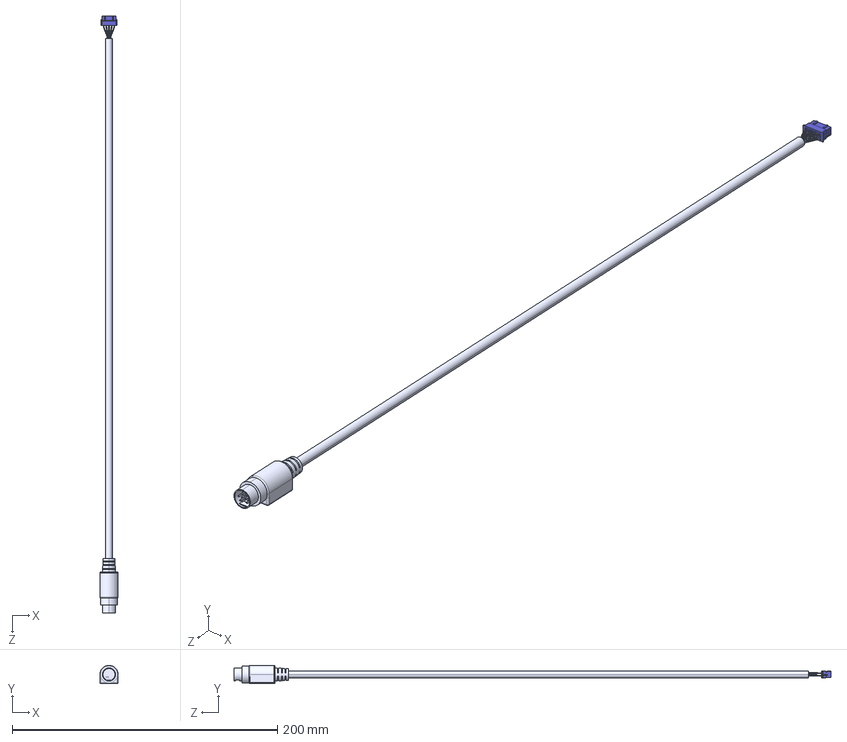
[picture p55: CAD file, 2017-10-23]
1727/1727-C/1727-C.STEP
13.8 x 13.8 x 450.0 mm
1727-C-cable
9Pin-Mini-Din
PHDR-10VS
