Ultimaker/Ultimaker3Extended/1728/1728-C/1728-C.STEP

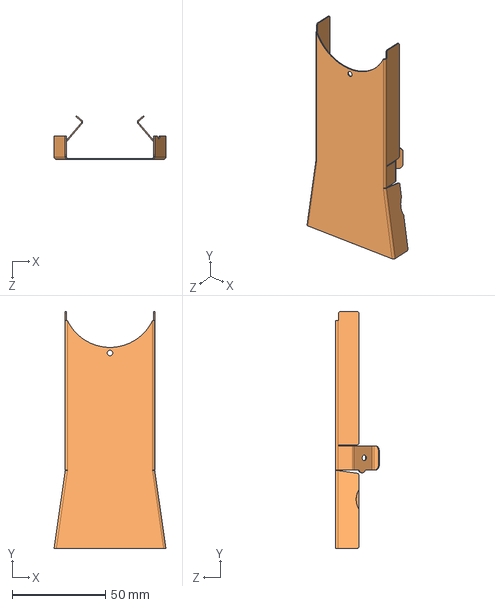
[picture p56: CAD file, 2017-10-23]
1728/1728-C/1728-C.STEP
60.0 x 127.1 x 23.5 mm
