Ultimaker/Ultimaker3Extended/1729/1729-H/1729-H.STEP

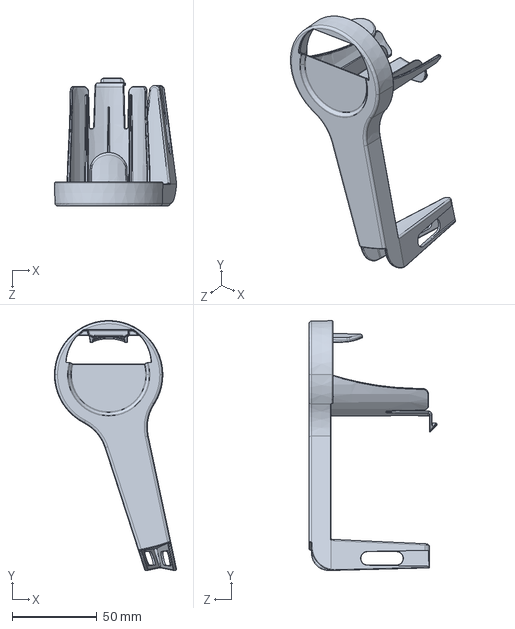
[picture p57: CAD file, 2017-10-23]
1729/1729-H/1729-H.STEP
72.0 x 147.4 x 75.4 mm
