Ultimaker/Ultimaker3Extended/1733/1733-A/1733-A.STEP

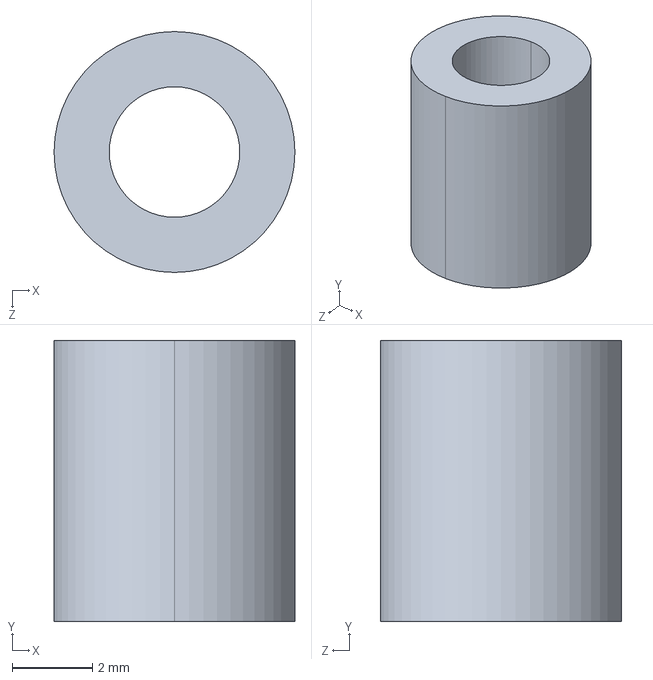
[picture p58: CAD file, 2017-10-18]
1733/1733-A/1733-A.STEP
6.00 x 7.00 x 6.00 mm
