Ultimaker/Ultimaker3Extended/1734/1734-F/1734-F.STEP

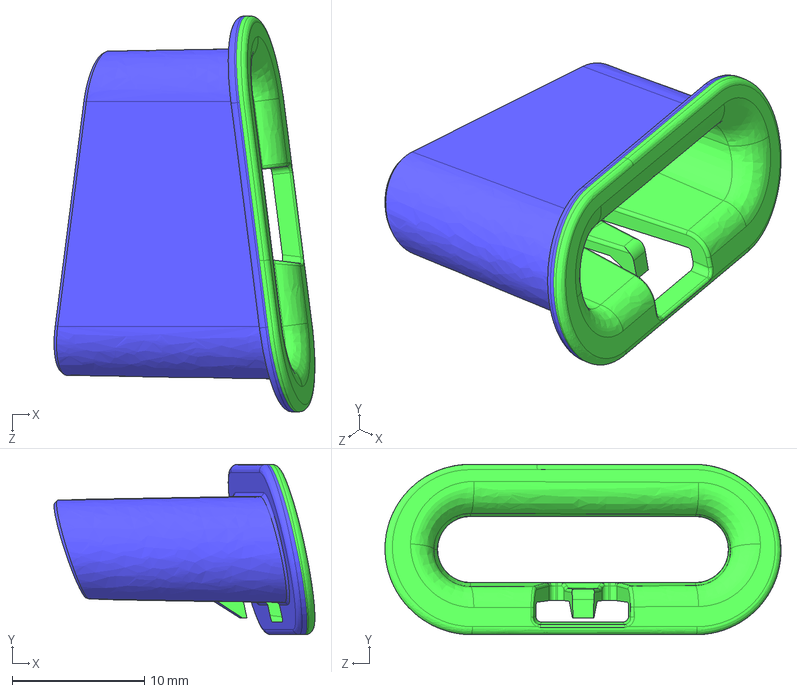
[picture p59: CAD file, 2017-10-23]
1734/1734-F/1734-F.STEP
19.7 x 12.9 x 30.0 mm
