Ultimaker/Ultimaker3Extended/1768/1768-A/1768-A.step

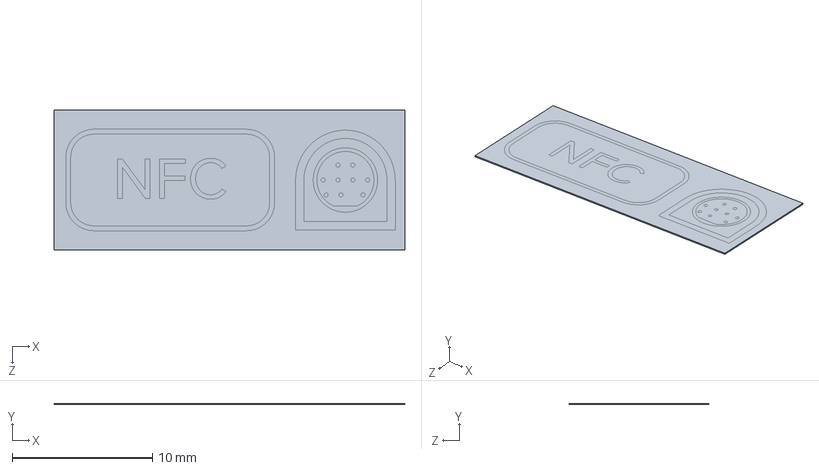
[picture p60: CAD file, 2017-10-18]
1768/1768-A/1768-A.step
25.0 x 0.1 x 10.0 mm
