Ultimaker/Ultimaker3Extended/1773/1773-A/1773-A.step

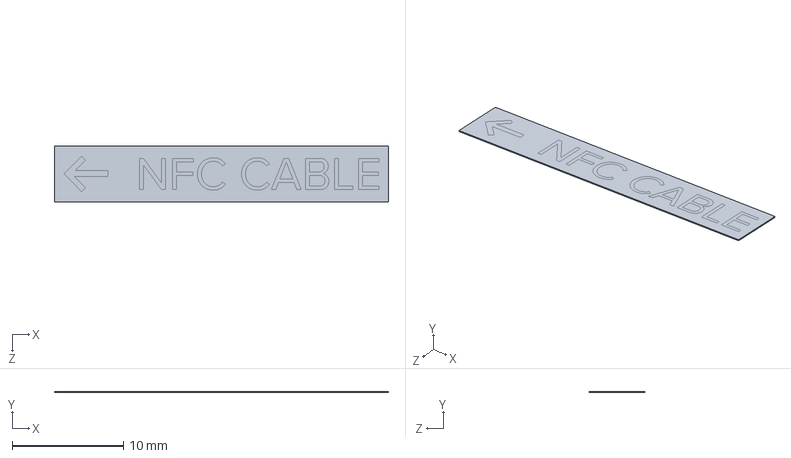
[picture p61: CAD file, 2017-10-18]
1773/1773-A/1773-A.step
30.0 x 0.1 x 5.00 mm
