Ultimaker/Ultimaker3Extended/1776/1776-B/1776-B.STEP

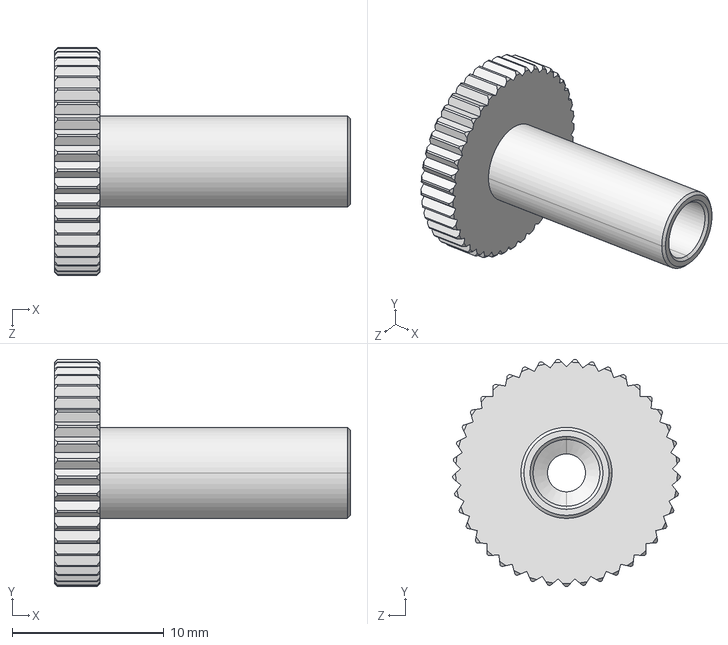
[picture p62: CAD file, 2017-10-18]
1776/1776-B/1776-B.STEP
19.5 x 15.0 x 15.0 mm
