Ultimaker/Ultimaker3Extended/1779/1779-A/1779-A.STEP

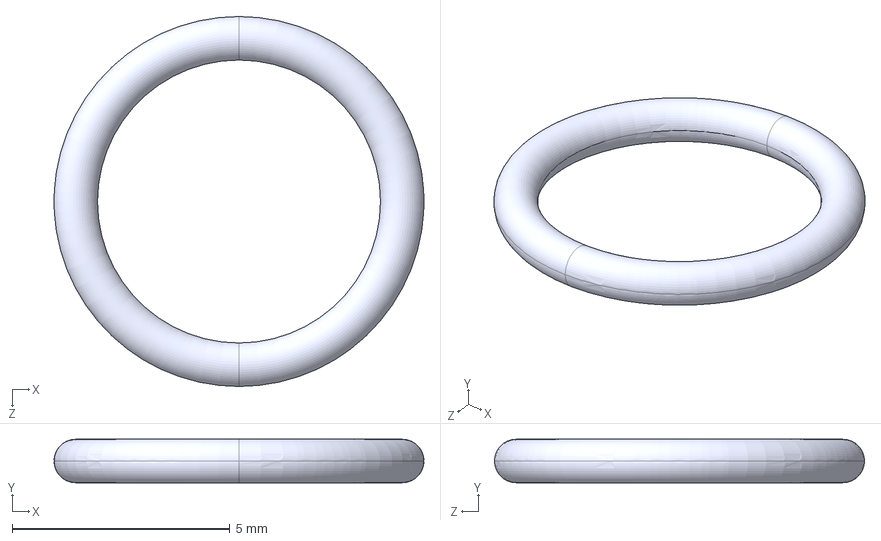
[picture p63: CAD file, 2017-10-18]
1779/1779-A/1779-A.STEP
8.49 x 1.00 x 8.50 mm
