Ultimaker/Ultimaker3Extended/1788/1788-A/1788-A.STEP

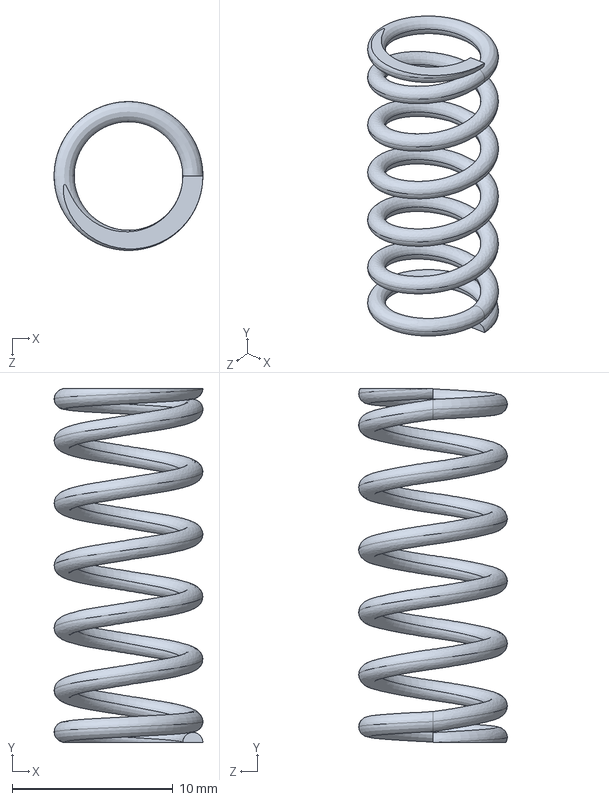
[picture p64: CAD file, 2017-10-18]
1788/1788-A/1788-A.STEP
9.25 x 22.0 x 9.25 mm
