Ultimaker/Ultimaker3Extended/1789/1789-A/1789-A.STEP

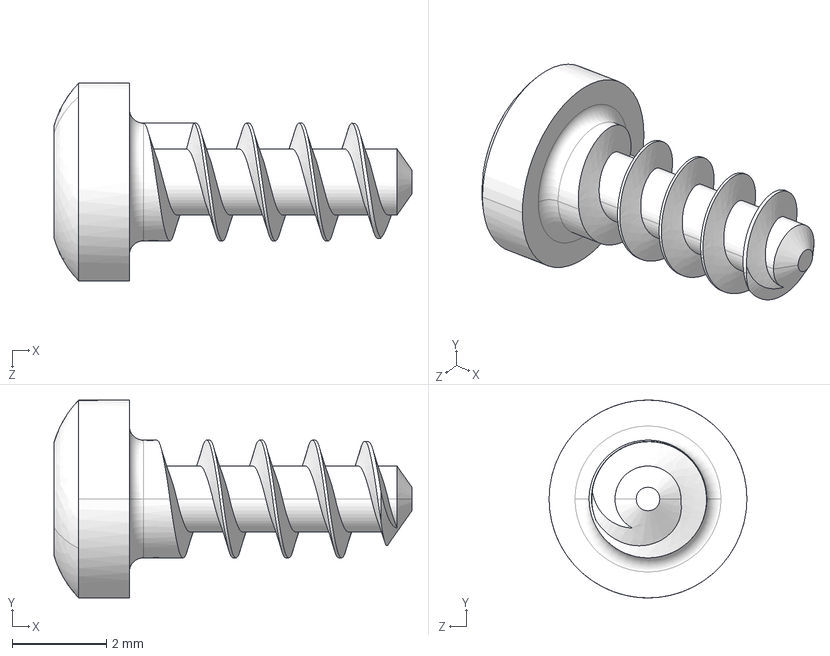
[picture p65: CAD file, 2017-10-18]
1789/1789-A/1789-A.STEP
7.60 x 4.20 x 4.20 mm
