Ultimaker/Ultimaker3Extended/1822/1822-B/1822-B.step

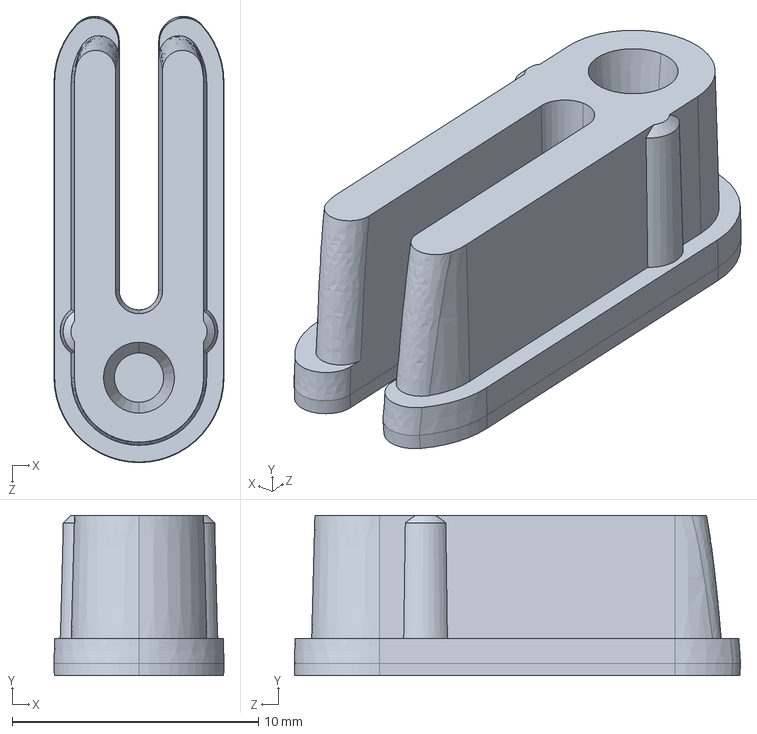
[picture p66: CAD file, 2017-10-18]
1822/1822-B/1822-B.step
6.90 x 6.50 x 18.1 mm
