Ultimaker/Ultimaker3Extended/1894/1894-A/1894-A.step

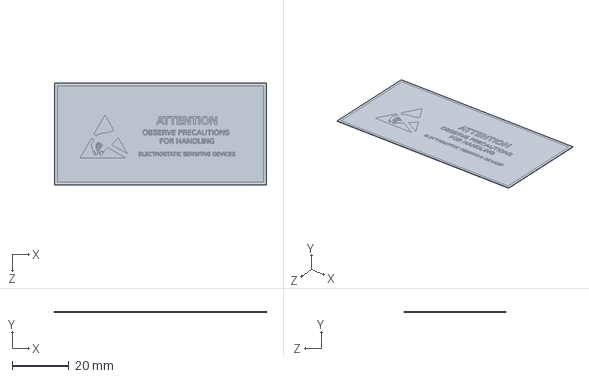
[picture p67: CAD file, 2017-10-18]
1894/1894-A/1894-A.step
75.0 x 0.1 x 36.0 mm
