Ultimaker/Ultimaker3Extended/1901/1901-C/1901-C.STEP

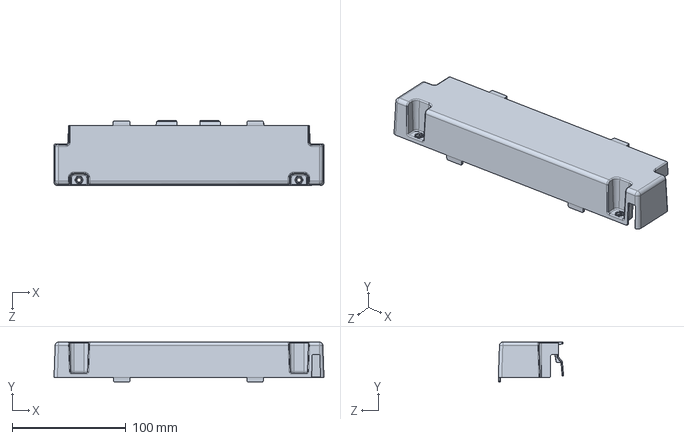
[picture p68: CAD file, 2017-10-18]
1901/1901-C/1901-C.STEP
237.0 x 35.0 x 57.4 mm
