Ultimaker/Ultimaker3Extended/1902/1902-C/1902-C.STEP

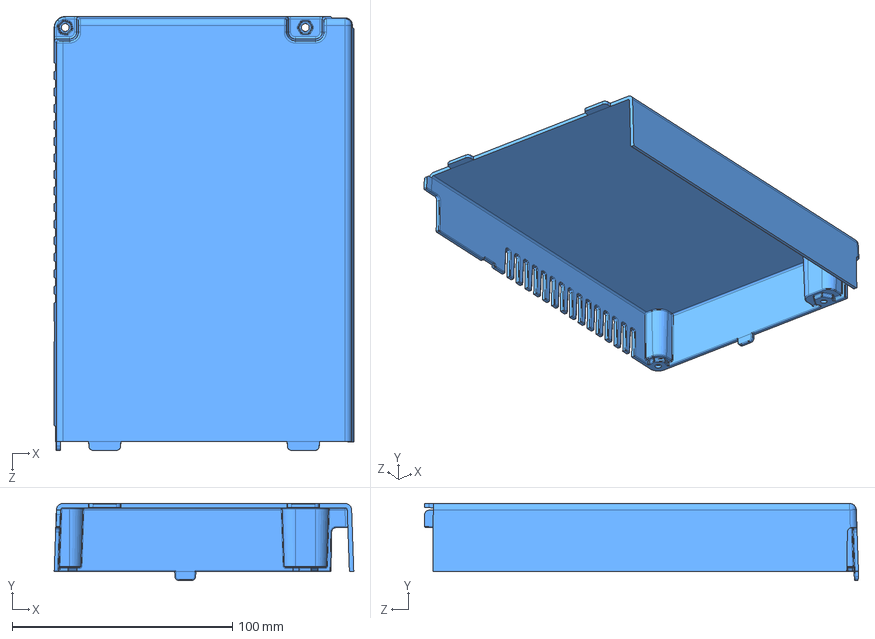
[picture p69: CAD file, 2017-10-18]
1902/1902-C/1902-C.STEP
136.0 x 35.0 x 197.0 mm
