Ultimaker/Ultimaker3Extended/1904/1904-E/1904-E.STEP

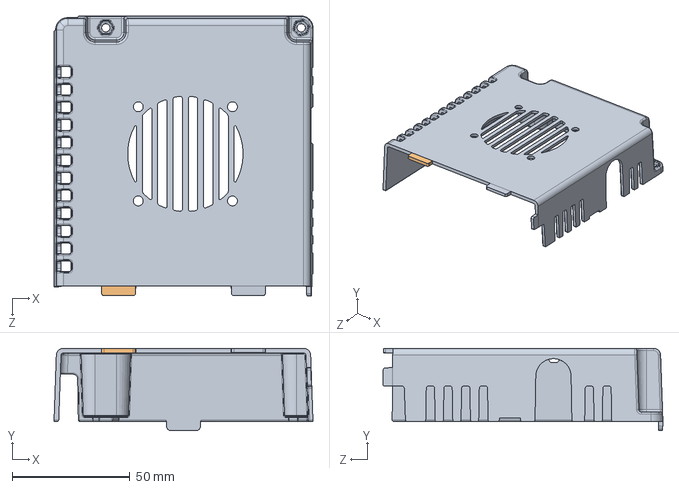
[picture p70: CAD file, 2017-10-18]
1904/1904-E/1904-E.STEP
110.0 x 35.0 x 118.9 mm
