Ultimaker/Ultimaker3Extended/1907/1907-G/1907-G.STEP

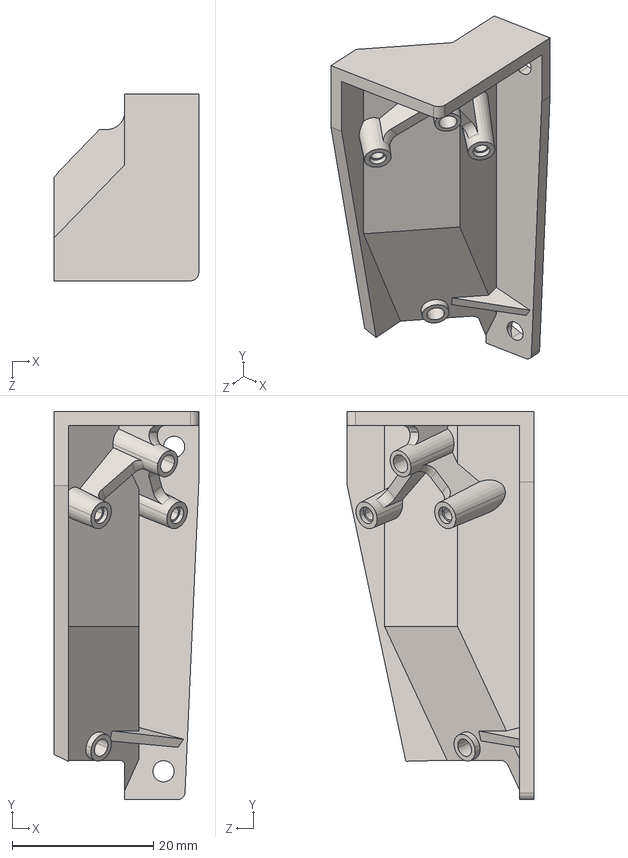
[picture p71: CAD file, 2017-10-18]
1907/1907-G/1907-G.STEP
20.5 x 55.0 x 26.4 mm
