Ultimaker/Ultimaker3Extended/1928/1928-K/1928-K.STEP

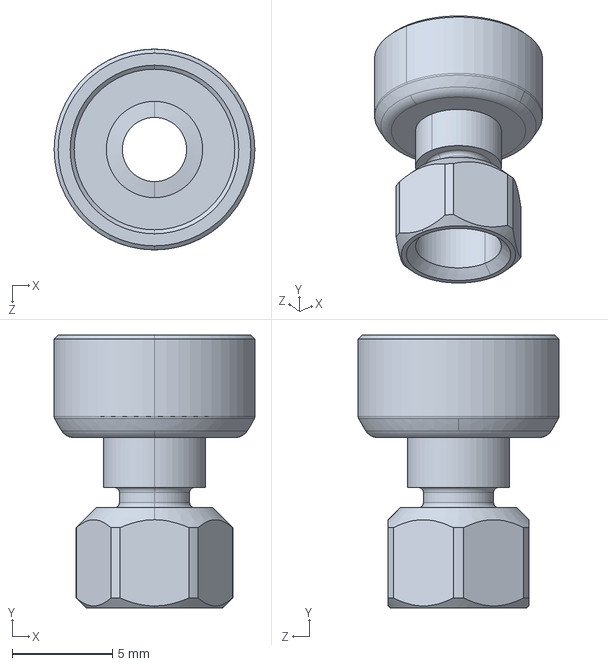
[picture p72: CAD file, 2017-10-18]
1928/1928-K/1928-K.STEP
10.0 x 13.6 x 10.0 mm
