Ultimaker/Ultimaker3Extended/1935/1935-J/1935-J.STEP

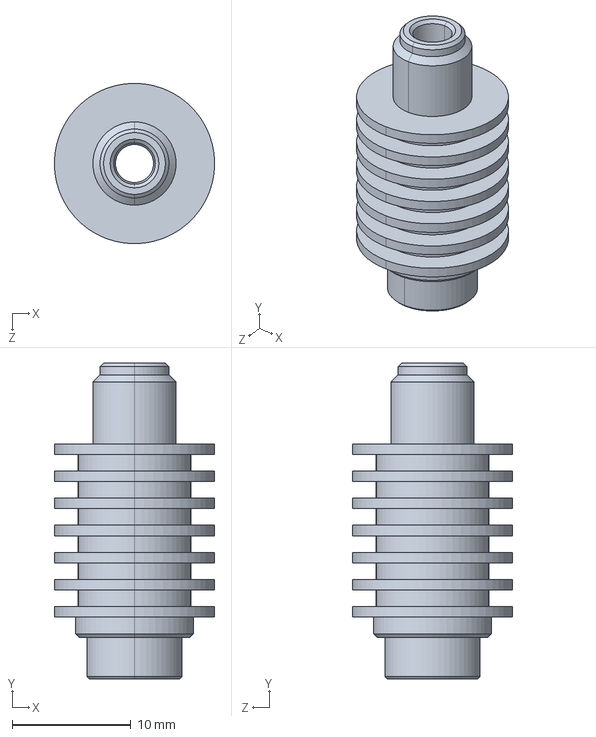
[picture p73: CAD file, 2017-10-18]
1935/1935-J/1935-J.STEP
13.5 x 26.6 x 13.5 mm
