Ultimaker/Ultimaker3Extended/1944/1944-F/1944-F.STEP

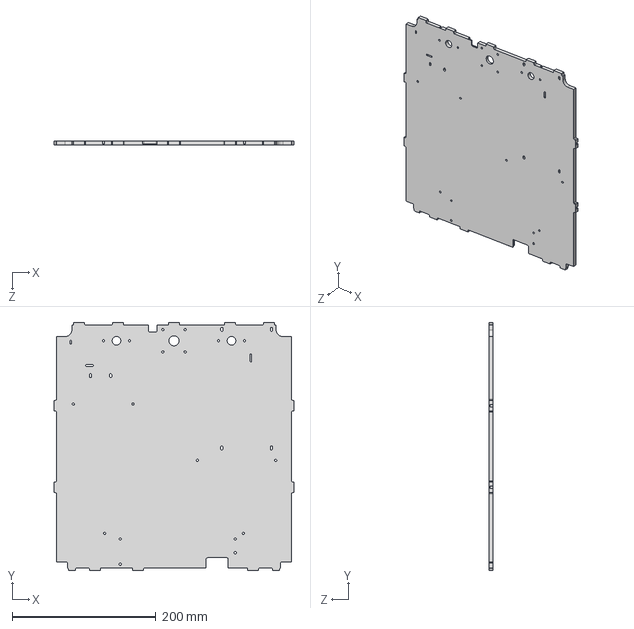
[picture p74: CAD file, 2017-10-18]
1944/1944-F/1944-F.STEP
333.8 x 345.2 x 6.00 mm
