Ultimaker/Ultimaker3Extended/1945/1945-F/1945-F.STEP

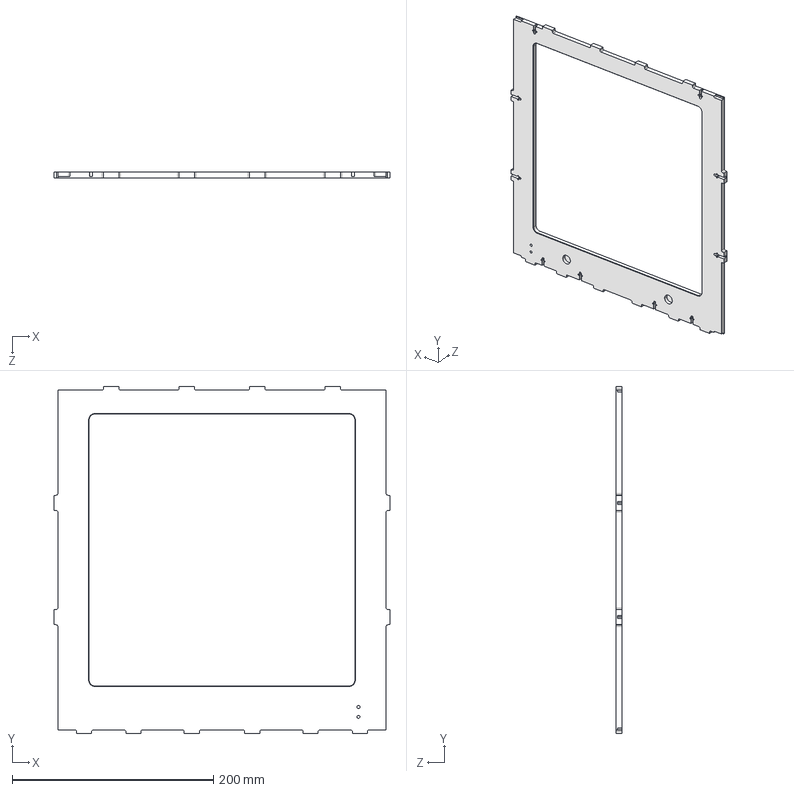
[picture p75: CAD file, 2017-10-18]
1945/1945-F/1945-F.STEP
333.8 x 345.2 x 6.00 mm
