Ultimaker/Ultimaker3Extended/1948/1948-A/1948-A.STEP

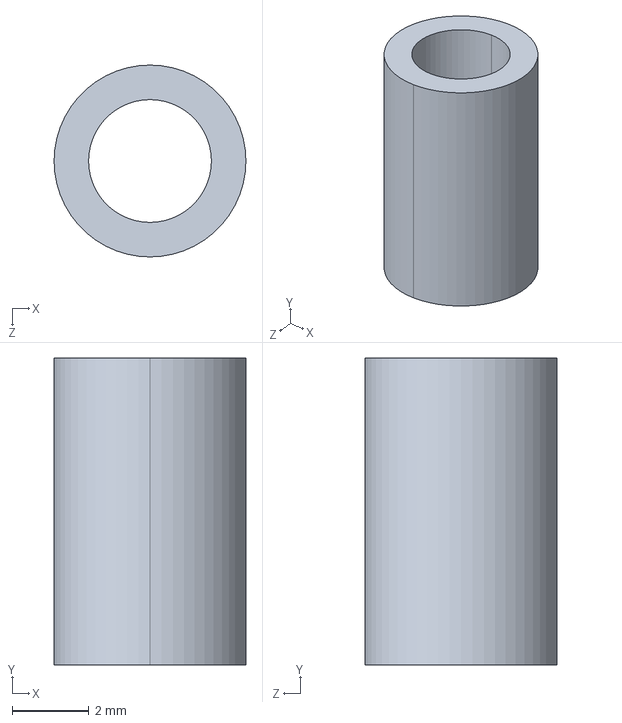
[picture p76: CAD file, 2017-10-18]
1948/1948-A/1948-A.STEP
5.00 x 8.00 x 5.00 mm
