Ultimaker/Ultimaker3Extended/1952/1952-N/1952-N.STEP

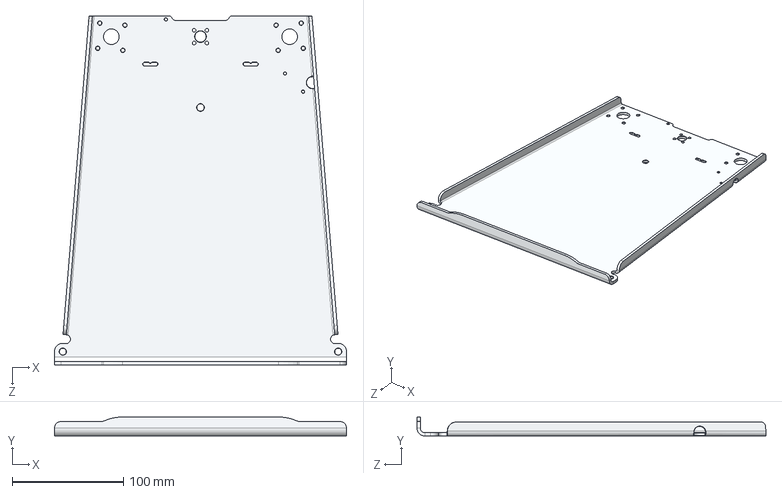
[picture p77: CAD file, 2017-10-18]
1952/1952-N/1952-N.STEP
262.0 x 17.0 x 313.1 mm
