Ultimaker/Ultimaker3Extended/1953/1953-D/1953-D.STEP

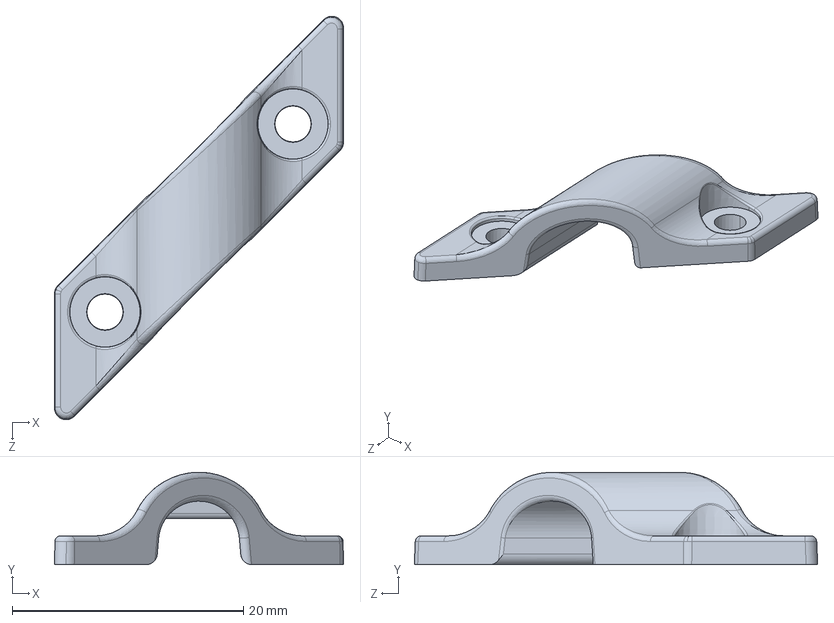
[picture p78: CAD file, 2017-10-18]
1953/1953-D/1953-D.STEP
25.0 x 8.00 x 34.9 mm
