Ultimaker/Ultimaker3Extended/1960/1960-I/1960-I.STEP

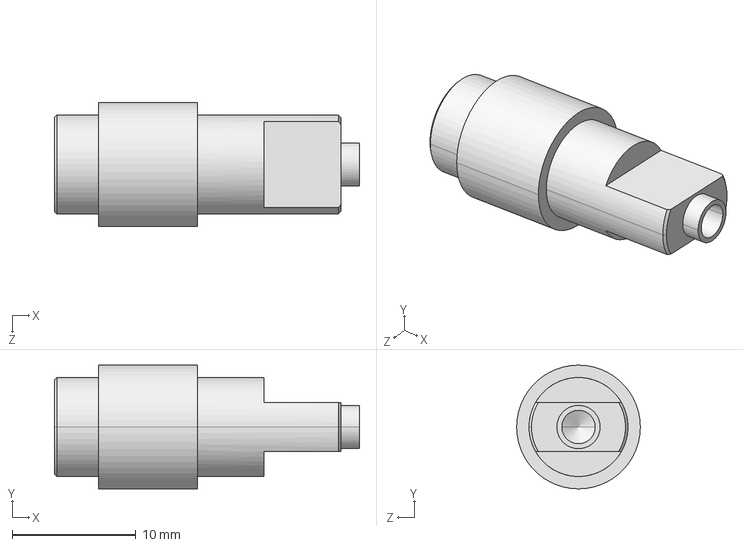
[picture p79: CAD file, 2017-10-18]
1960/1960-I/1960-I.STEP
24.7 x 10.0 x 10.0 mm
