Ultimaker/Ultimaker3Extended/1961/1961-B/1961-B.STEP

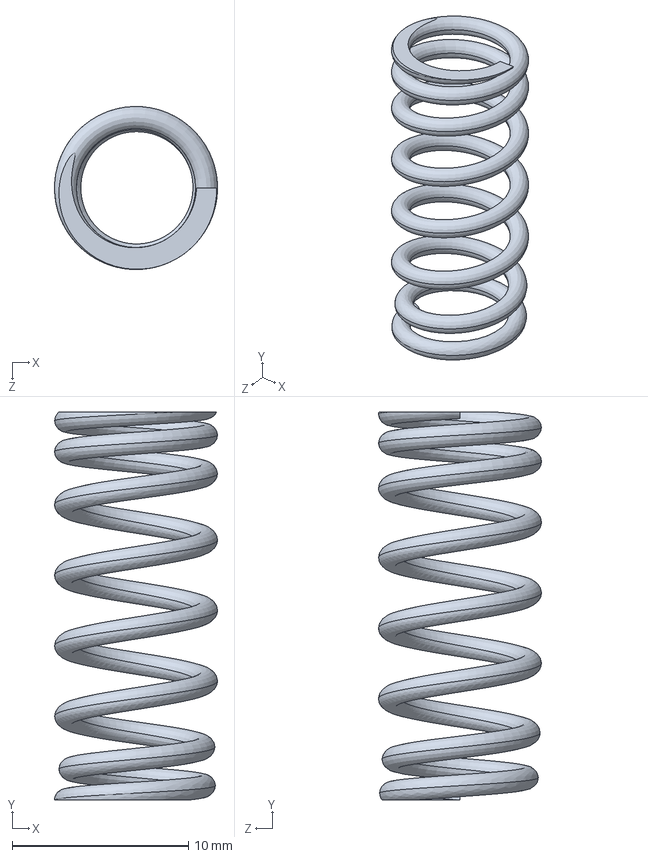
[picture p80: CAD file, 2017-10-18]
1961/1961-B/1961-B.STEP
9.25 x 22.0 x 9.25 mm
