Ultimaker/Ultimaker3Extended/1962/1962-F/1962-F.STEP

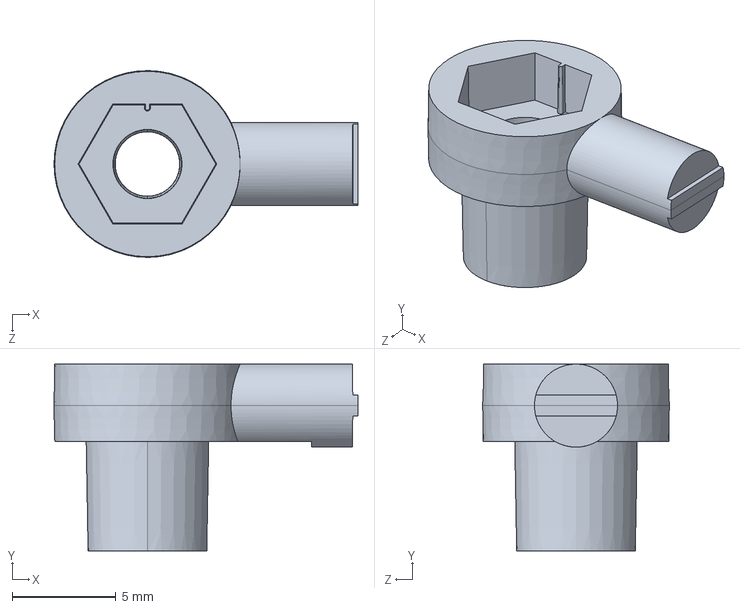
[picture p81: CAD file, 2017-10-18]
1962/1962-F/1962-F.STEP
14.6 x 9.00 x 9.00 mm
