Ultimaker/Ultimaker3Extended/1963/1963-O/1963-O.STEP

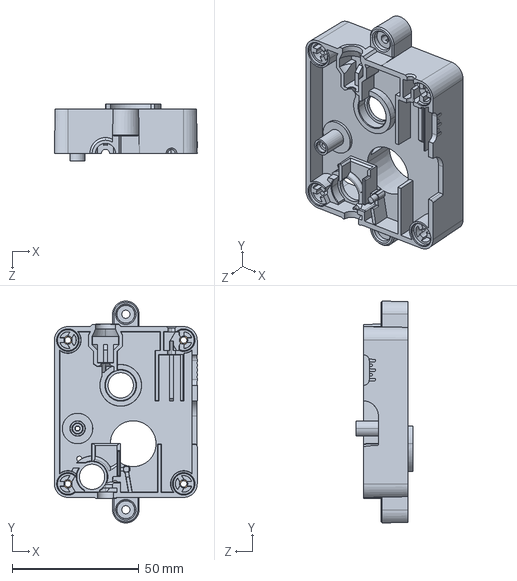
[picture p82: CAD file, 2017-10-18]
1963/1963-O/1963-O.STEP
56.4 x 87.4 x 22.5 mm
