Ultimaker/Ultimaker3Extended/1967/1967-N/1967-N.STEP

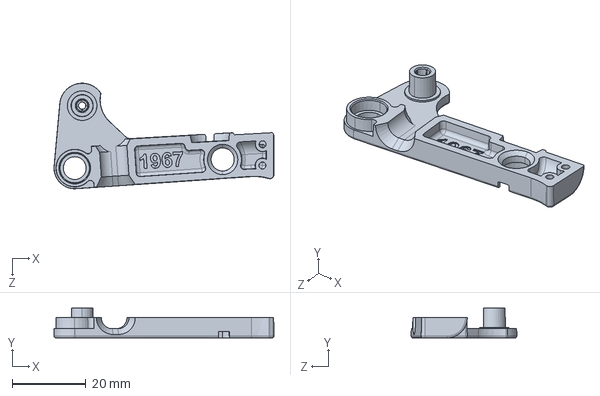
[picture p83: CAD file, 2017-10-18]
1967/1967-N/1967-N.STEP
59.5 x 8.10 x 28.6 mm
