Ultimaker/Ultimaker3Extended/1968/1968-K/1968-K.STEP

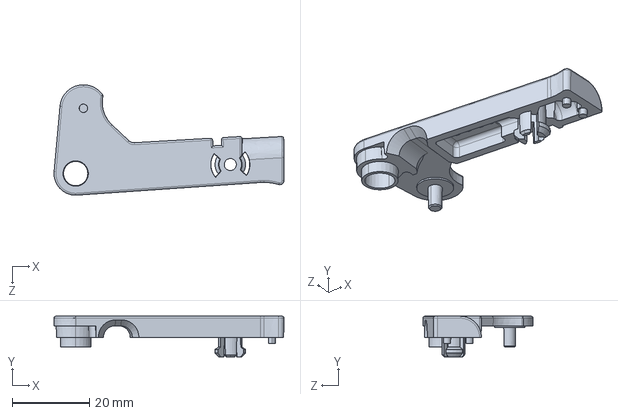
[picture p84: CAD file, 2017-10-18]
1968/1968-K/1968-K.STEP
59.5 x 10.5 x 28.6 mm
