Ultimaker/Ultimaker3Extended/1969/1969-G/1969-G.STEP

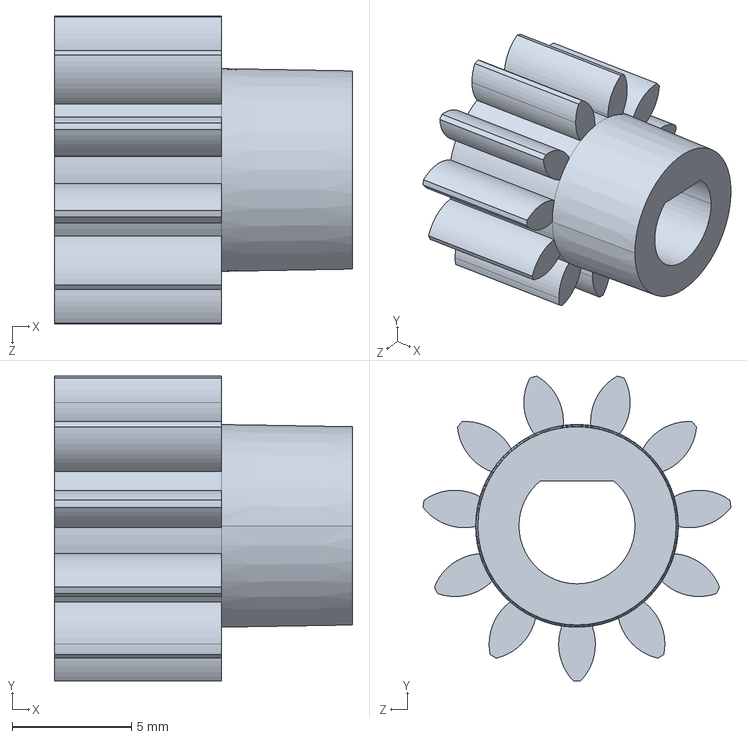
[picture p85: CAD file, 2017-10-18]
1969/1969-G/1969-G.STEP
12.5 x 12.8 x 12.9 mm
