Ultimaker/Ultimaker3Extended/1970/1970-F/1970-F.STEP

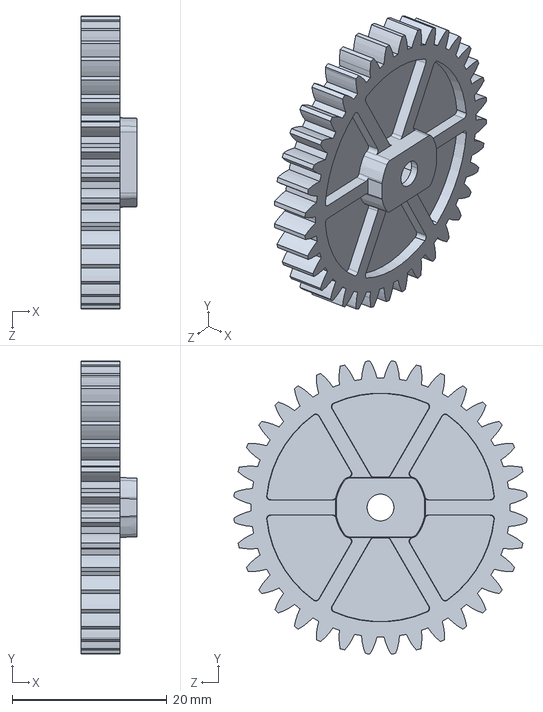
[picture p86: CAD file, 2017-10-18]
1970/1970-F/1970-F.STEP
7.20 x 37.9 x 37.9 mm
