Ultimaker/Ultimaker3Extended/1972/1972-E/1972-E.STEP

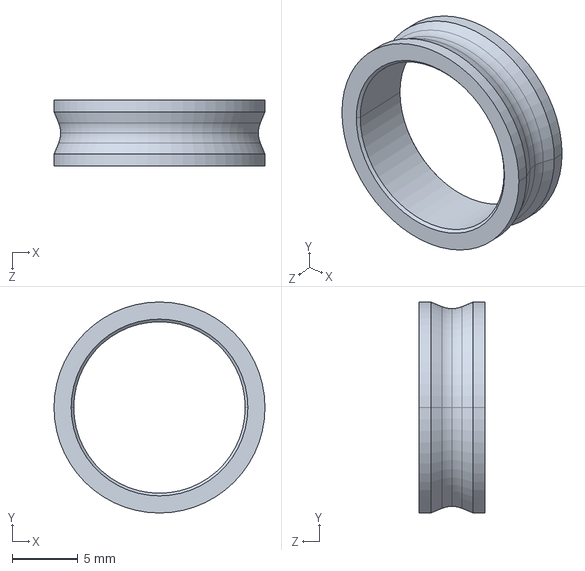
[picture p87: CAD file, 2017-10-18]
1972/1972-E/1972-E.STEP
16.0 x 16.0 x 5.00 mm
