Ultimaker/Ultimaker3Extended/1973/1973-B/1973-B.STEP

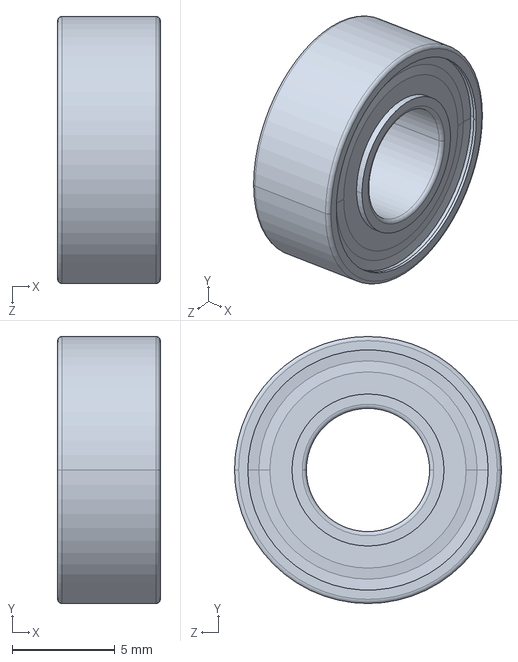
[picture p88: CAD file, 2017-10-18]
1973/1973-B/1973-B.STEP
5.00 x 13.0 x 13.0 mm
