Ultimaker/Ultimaker3Extended/1974/1974-B/1974-B.STEP

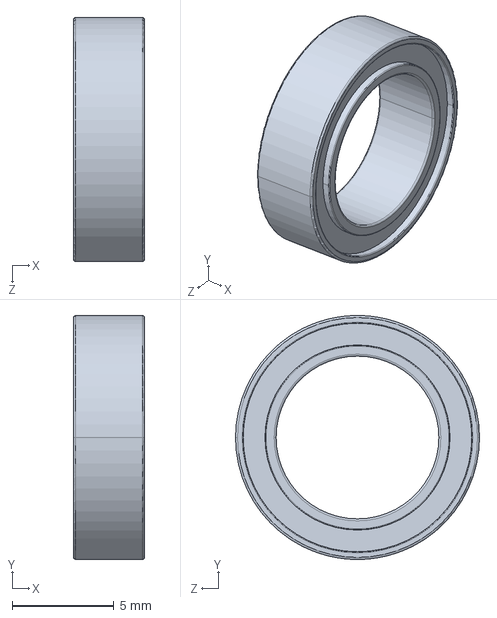
[picture p89: CAD file, 2017-10-18]
1974/1974-B/1974-B.STEP
3.50 x 12.0 x 12.0 mm
