Ultimaker/Ultimaker3Extended/1976/1976-E/1976-E.STEP

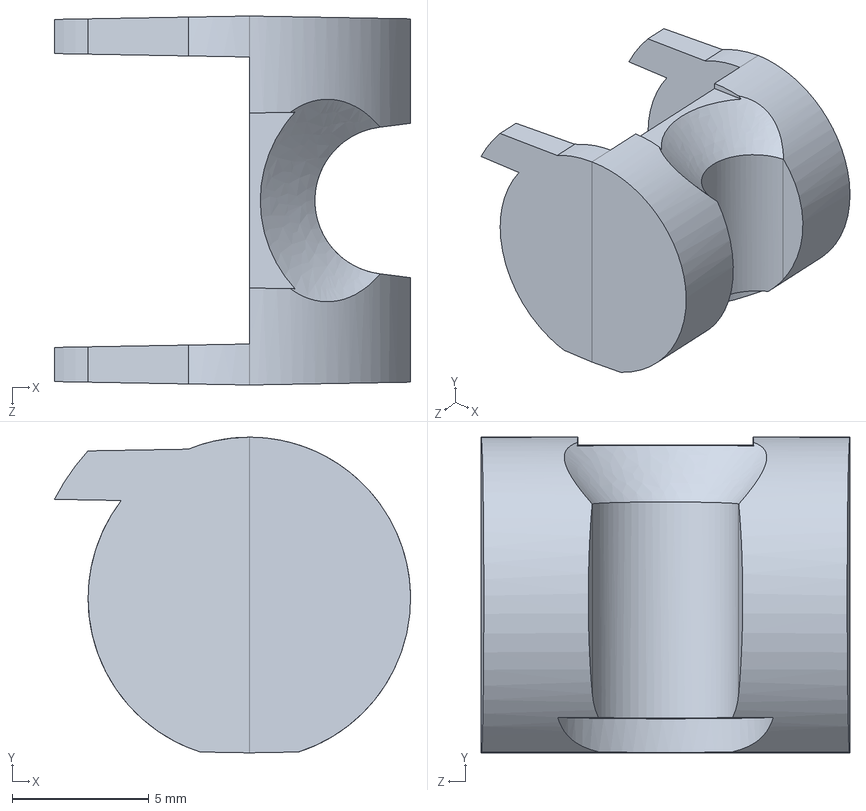
[picture p90: CAD file, 2017-10-18]
1976/1976-E/1976-E.STEP
13.0 x 11.6 x 13.5 mm
