Ultimaker/Ultimaker3Extended/1985/1985-C/1985-C.STEP

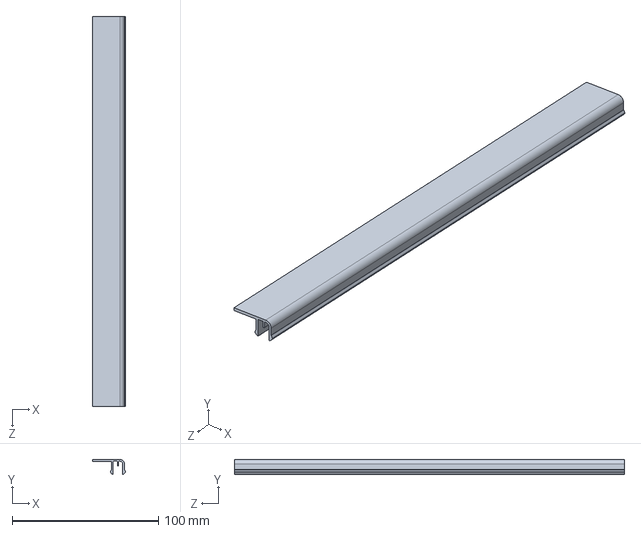
[picture p91: CAD file, 2017-10-18]
1985/1985-C/1985-C.STEP
22.8 x 10.3 x 267.0 mm
