Ultimaker/Ultimaker3Extended/1987/1987-D/1987-D.STEP

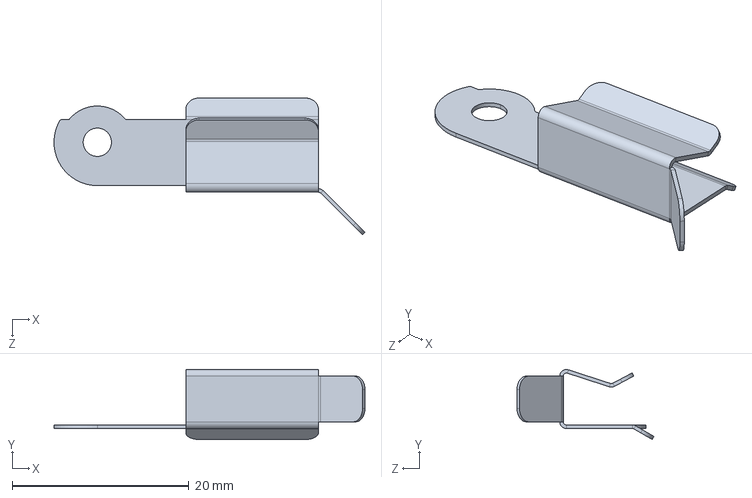
[picture p92: CAD file, 2017-10-18]
1987/1987-D/1987-D.STEP
35.2 x 7.91 x 15.5 mm
