Ultimaker/Ultimaker3Extended/1991/1991-U/1991-U.STEP

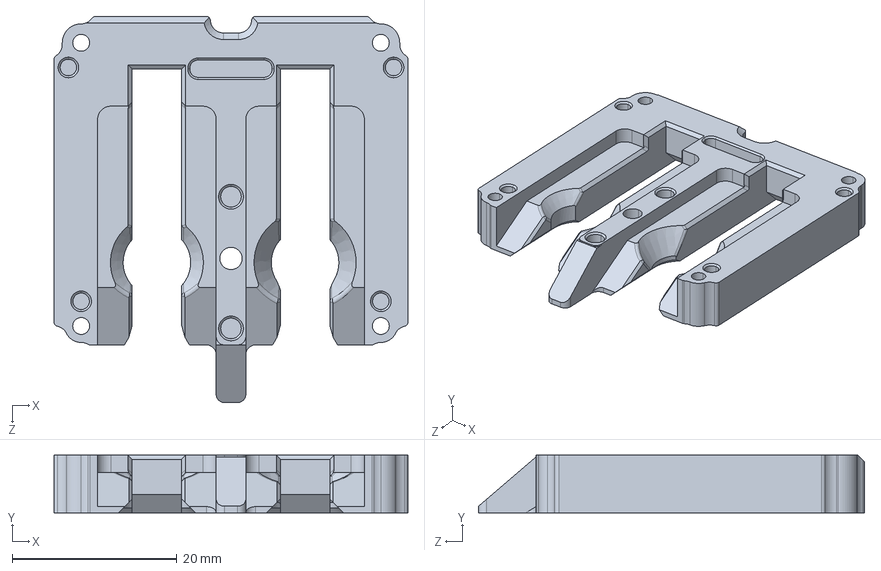
[picture p93: CAD file, 2017-10-18]
1991/1991-U/1991-U.STEP
43.0 x 7.00 x 46.9 mm
