Ultimaker/Ultimaker3Extended/1996/1996-E/1996-E.STEP

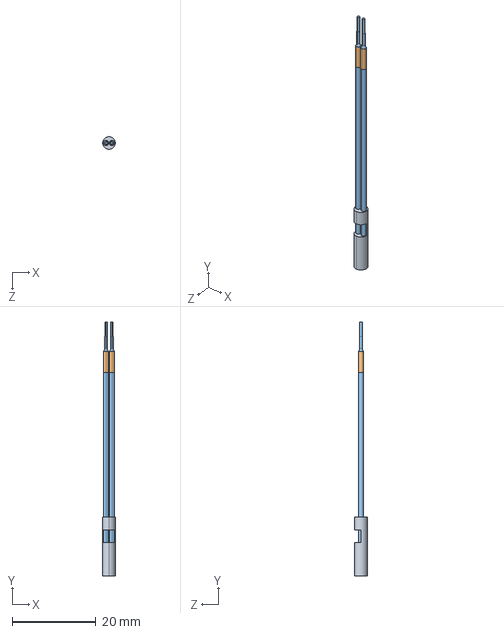
[picture p94: CAD file, 2017-10-18]
1996/1996-E/1996-E.STEP
3.00 x 60.5 x 3.00 mm
