Ultimaker/Ultimaker3Extended/1997/1997-F/1997-F.STEP

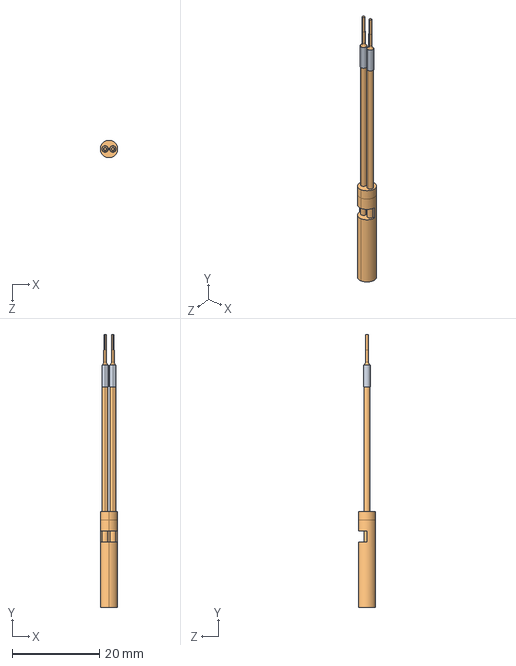
[picture p95: CAD file, 2017-10-18]
1997/1997-F/1997-F.STEP
4.00 x 62.5 x 4.00 mm
