Ultimaker/Ultimaker3Extended/1998/1998-E/1998-E.STEP

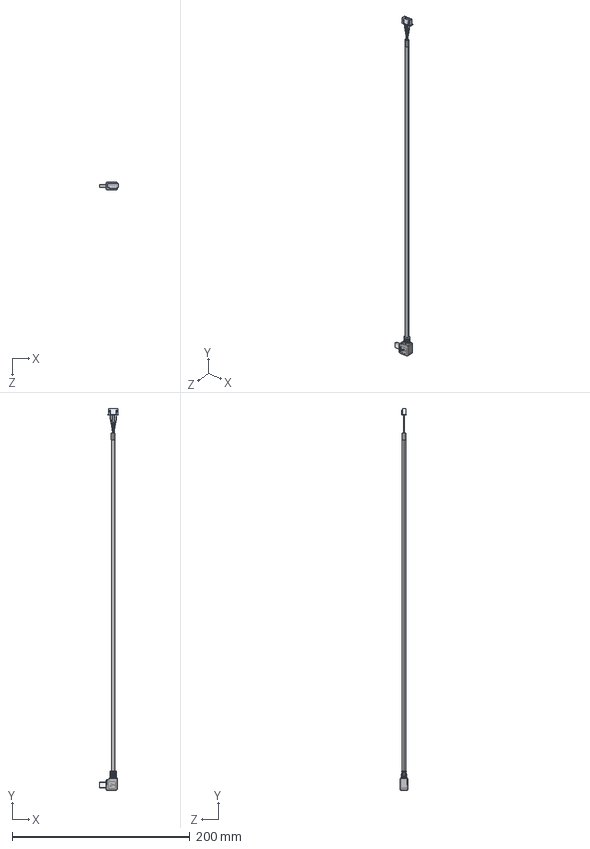
[picture p96: CAD file, 2017-10-18]
1998/1998-E/1998-E.STEP
21.7 x 430.2 x 8.69 mm
MTN-627
1AA05-016-MA1
1AA05-016-MA3
MTN-626
USB panel Cable
USB panel Cable_cable
XHP-4
