Ultimaker/Ultimaker3Extended/2004/2004-D/2004-D.STEP

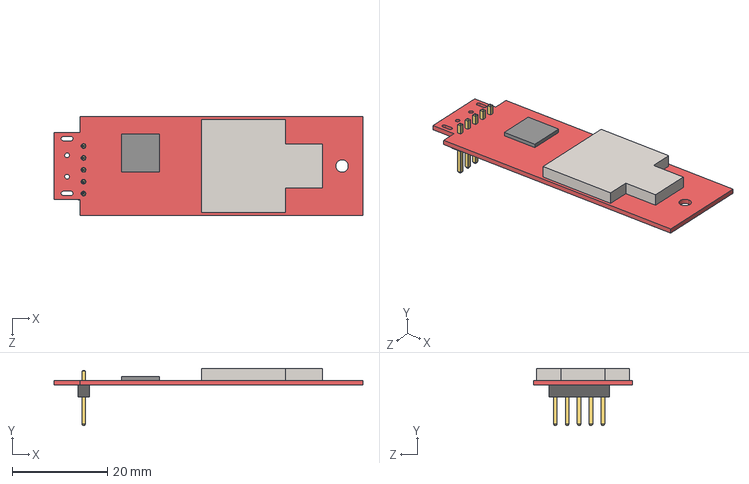
[picture p97: CAD file, 2017-10-18]
2004/2004-D/2004-D.STEP
65.0 x 12.0 x 20.9 mm
2004-B
5 pin connector
