Ultimaker/Ultimaker3Extended/2007/2007-E/2007-E.STEP

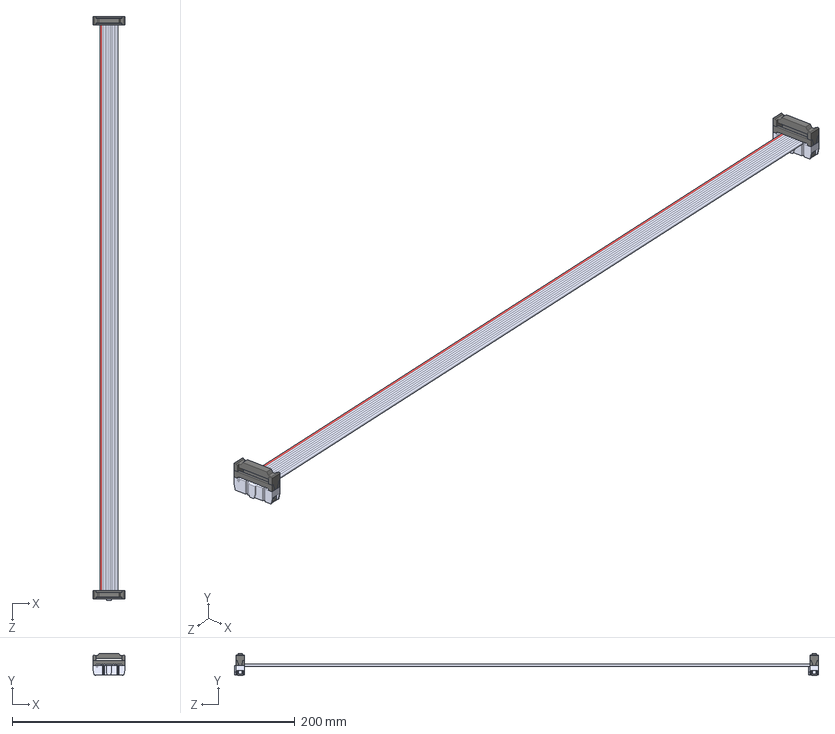
[picture p98: CAD file, 2017-10-18]
2007/2007-E/2007-E.STEP
22.4 x 15.7 x 413.0 mm
2007cables
Amphenol IDC Socket Strain Relief x 2
Amphenol IDC Socket Crimp x 2
Amphenol IDC Socket Housing x 2
