Ultimaker/Ultimaker3Extended/2008/2008-B/2008-B.STEP

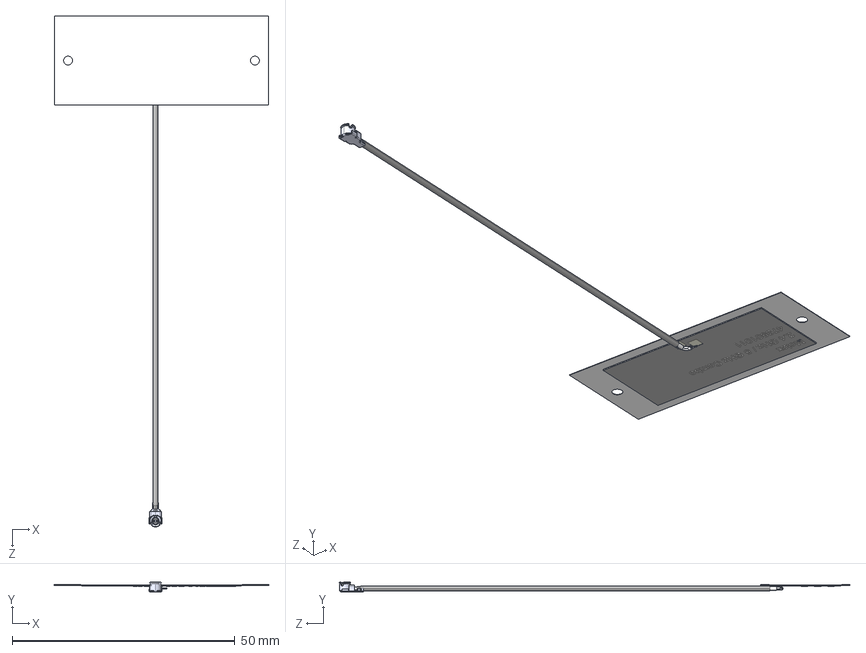
[picture p99: CAD file, 2017-10-18]
2008/2008-B/2008-B.STEP
48.0 x 2.15 x 114.6 mm
