Ultimaker/Ultimaker3Extended/2010/2010-D/2010-D.STEP

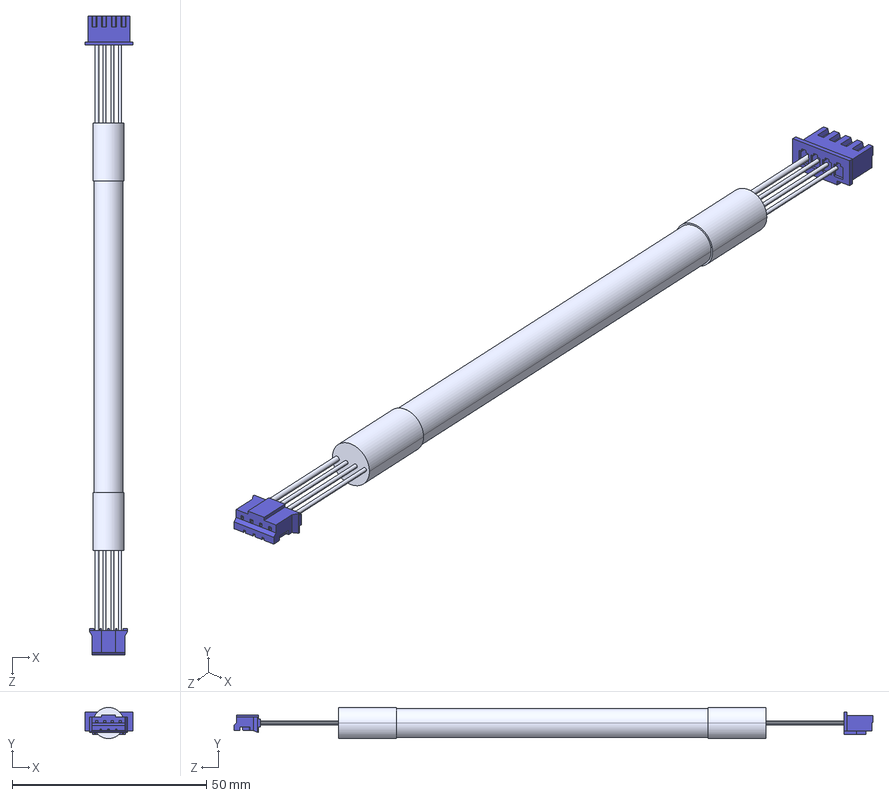
[picture p100: CAD file, 2017-10-18]
2010/2010-D/2010-D.STEP
12.3 x 8.00 x 164.4 mm
wifi PHR-4
wifi cable
XHP-4
