Ultimaker/Ultimaker3Extended/2012/2012-K/2012-K.step

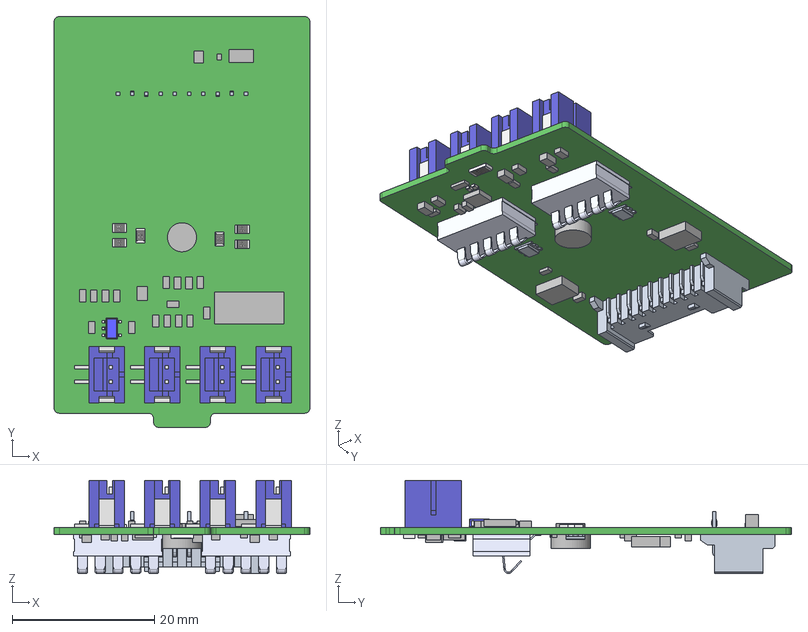
[picture p101: CAD file, 2017-10-18]
2012/2012-K/2012-K.step
36.0 x 57.8 x 13.1 mm
Board
Extruded x 48
B2B-PH-SM4-TB x 4
1210_bi_and_tri x 2
AVX_Interconnect-$PARTNUMBER_AVX_Interconnect-00-9155-005-003-016_ 00-9155-005-003-01X x 2
RESC2012X05N(0805) x 6
