Ultimaker/Ultimaker3Extended/2014/2014-D/2014-D.STEP

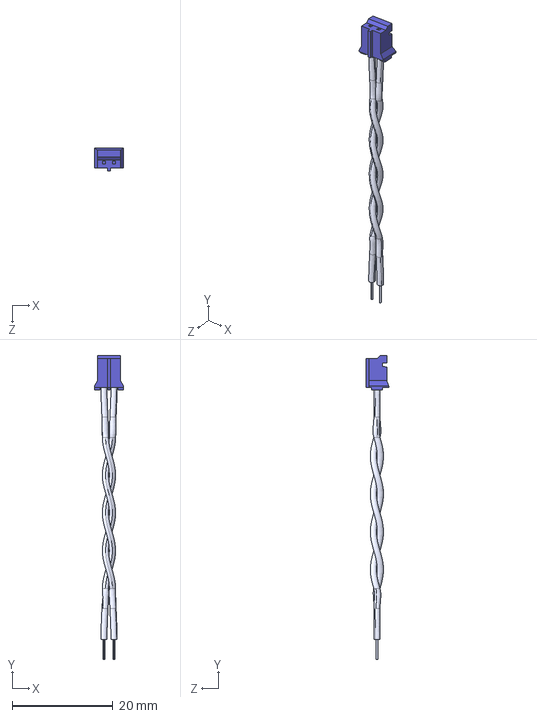
[picture p102: CAD file, 2017-10-18]
2014/2014-D/2014-D.STEP
5.80 x 60.4 x 4.50 mm
nummer-Cable
PHR-2
