Ultimaker/Ultimaker3Extended/2015/2015-H/2015-H.step

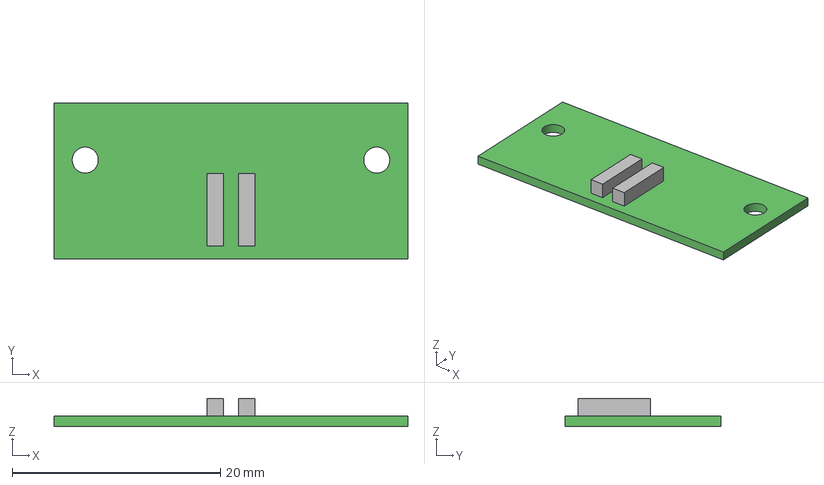
[picture p103: CAD file, 2017-10-18]
2015/2015-H/2015-H.step
34.0 x 15.0 x 2.70 mm
Board
Extruded x 2
