Ultimaker/Ultimaker3Extended/2017/2017-A/2017-A.STEP

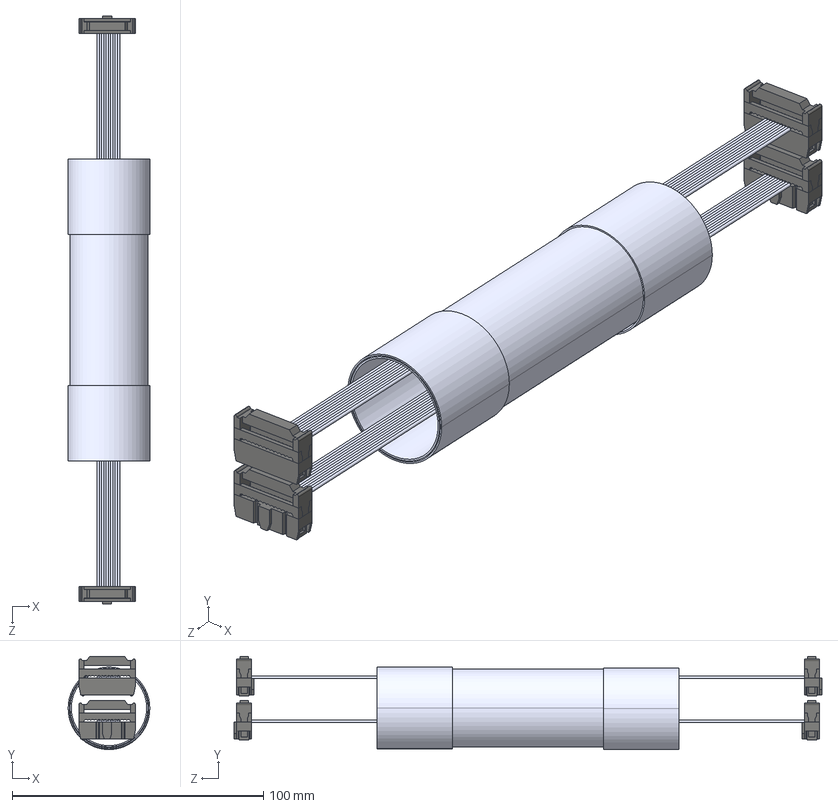
[picture p104: CAD file, 2017-10-18]
2017/2017-A/2017-A.STEP
32.5 x 37.1 x 234.0 mm
cables x 2
Amphenol IDC Socket Strain Relief x 4
Amphenol IDC Socket Crimp x 4
Amphenol IDC Socket Housing x 4
braided sleeve
Shrink tube x 2
