Ultimaker/Ultimaker3Extended/2022/2022-N/2022-N.STEP

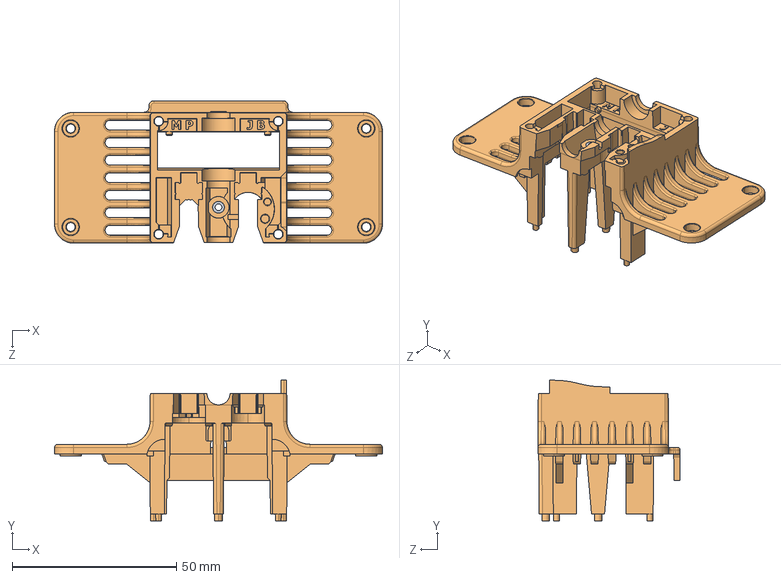
[picture p105: CAD file, 2017-10-18]
2022/2022-N/2022-N.STEP
99.9 x 42.8 x 43.4 mm
