Ultimaker/Ultimaker3Extended/2025/2025-I/2025-I.STEP

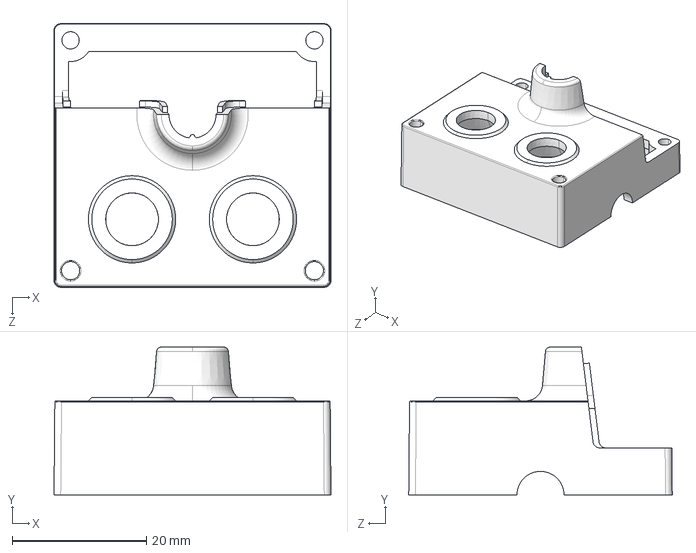
[picture p106: CAD file, 2017-10-18]
2025/2025-I/2025-I.STEP
41.2 x 22.0 x 39.2 mm
