Ultimaker/Ultimaker3Extended/2035/2035-H/2035-H.STEP

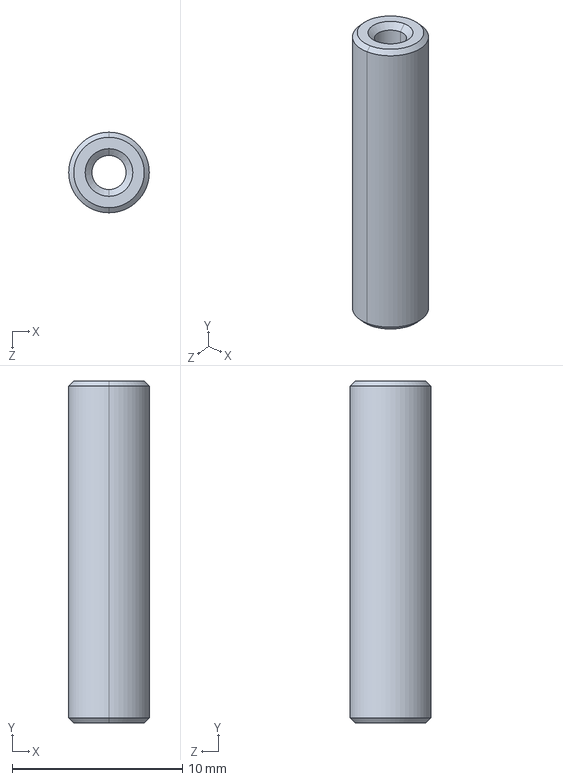
[picture p107: CAD file, 2017-10-18]
2035/2035-H/2035-H.STEP
4.74 x 20.1 x 4.74 mm
