Ultimaker/Ultimaker3Extended/2037/2037-A/2037-A.STEP

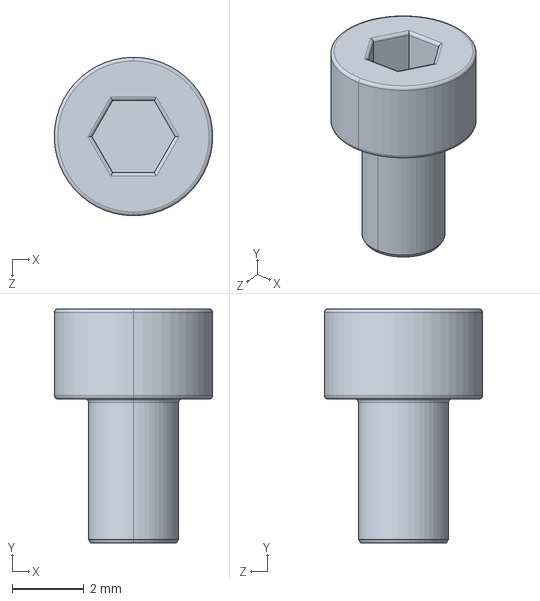
[picture p108: CAD file, 2017-10-18]
2037/2037-A/2037-A.STEP
4.40 x 6.50 x 4.40 mm
