Ultimaker/Ultimaker3Extended/2039/2039-A/2039-A.STEP

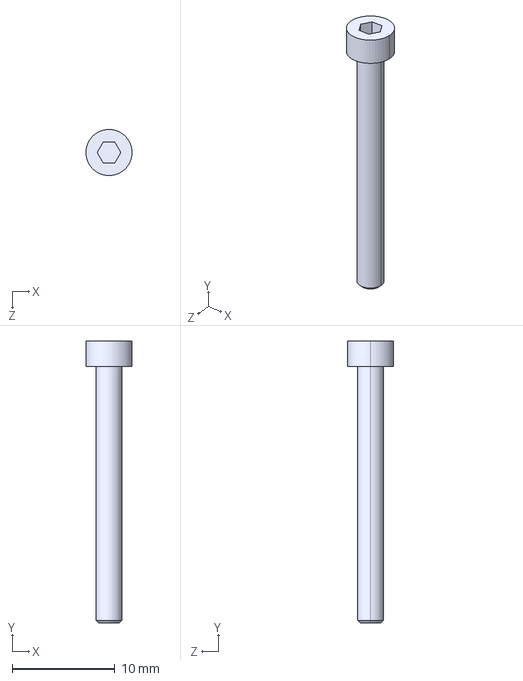
[picture p109: CAD file, 2017-10-18]
2039/2039-A/2039-A.STEP
4.50 x 27.5 x 4.50 mm
