Ultimaker/Ultimaker3Extended/2043/2043-A/2043-A.STEP

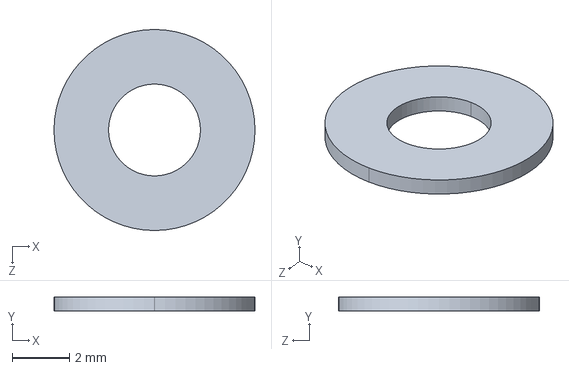
[picture p110: CAD file, 2017-10-18]
2043/2043-A/2043-A.STEP
7.00 x 0.5 x 7.00 mm
