Ultimaker/Ultimaker3Extended/2048/2048-B/2048-B.STEP

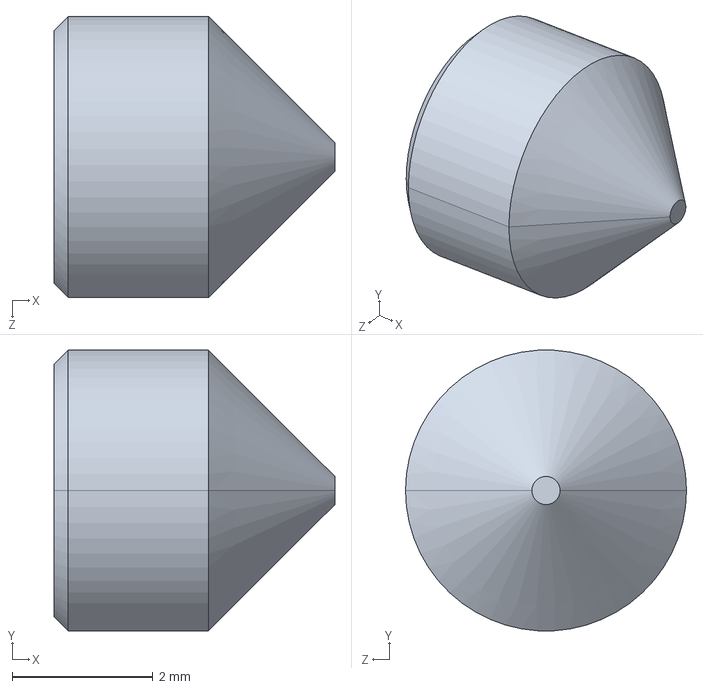
[picture p111: CAD file, 2017-10-18]
2048/2048-B/2048-B.STEP
4.00 x 3.99 x 4.00 mm
