Ultimaker/Ultimaker3Extended/2050/2050-G/2050-G.STEP

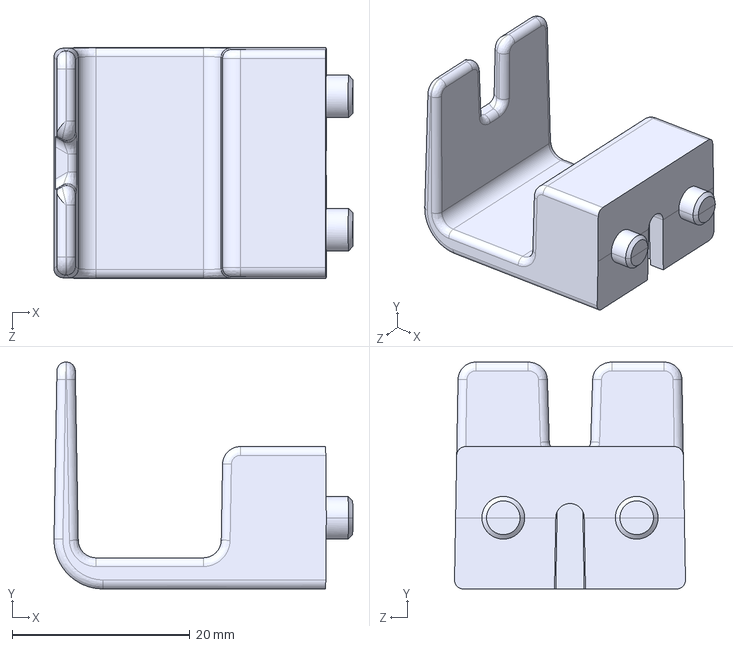
[picture p112: CAD file, 2017-10-18]
2050/2050-G/2050-G.STEP
33.6 x 25.5 x 26.0 mm
