Ultimaker/Ultimaker3Extended/2069/2069-E/2069-E.STEP

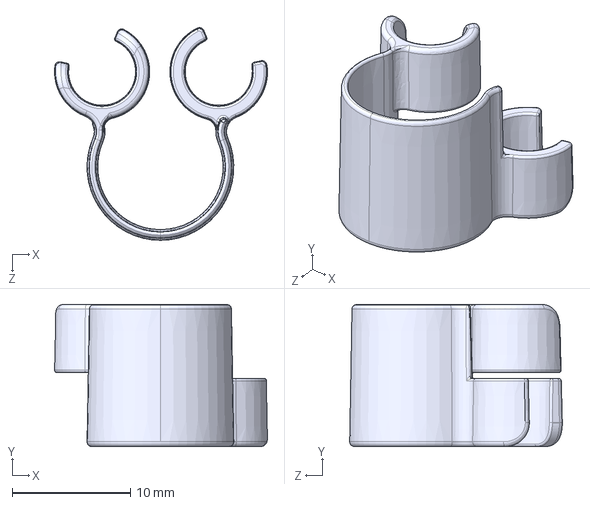
[picture p113: CAD file, 2017-10-18]
2069/2069-E/2069-E.STEP
18.0 x 12.0 x 18.0 mm
