Ultimaker/Ultimaker3Extended/2076/2076-A/2076-A.STEP

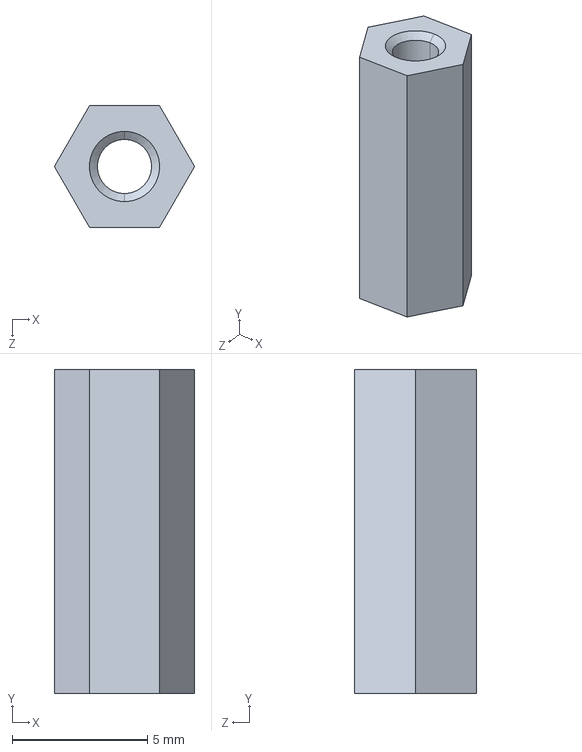
[picture p114: CAD file, 2017-10-18]
2076/2076-A/2076-A.STEP
5.20 x 12.0 x 4.50 mm
