Ultimaker/Ultimaker3Extended/2078/2078-A/2078-A.STEP

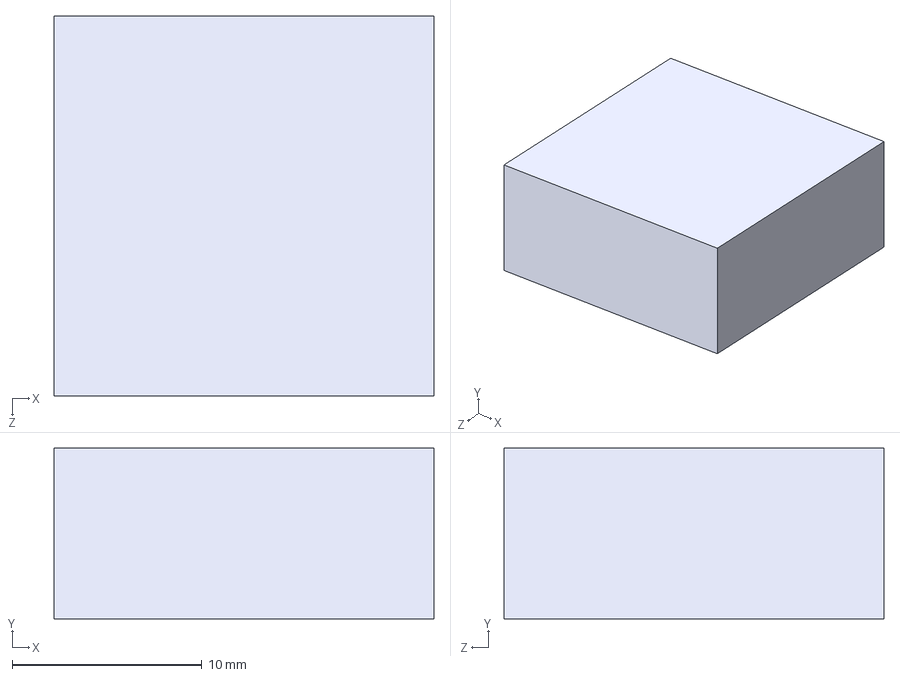
[picture p115: CAD file, 2017-10-18]
2078/2078-A/2078-A.STEP
20.0 x 9.00 x 20.0 mm
