Ultimaker/Ultimaker3Extended/2082/2082-B/2082-B.STEP

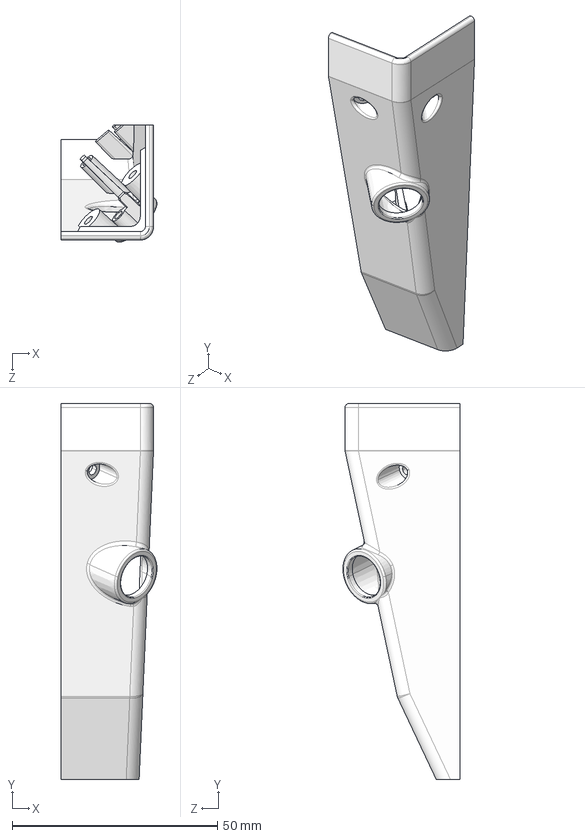
[picture p116: CAD file, 2017-10-18]
2082/2082-B/2082-B.STEP
23.3 x 91.5 x 28.5 mm
