Ultimaker/Ultimaker3Extended/2085/2085-A/2085-A.STEP

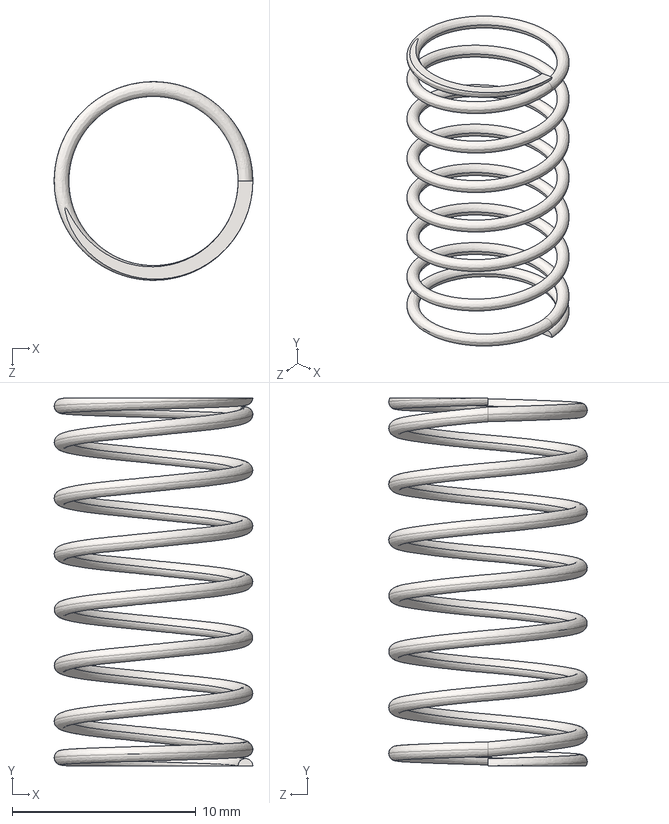
[picture p117: CAD file, 2017-10-18]
2085/2085-A/2085-A.STEP
10.8 x 20.0 x 10.8 mm
