Ultimaker/Ultimaker3Extended/2101/2101-C/2101-C.STEP

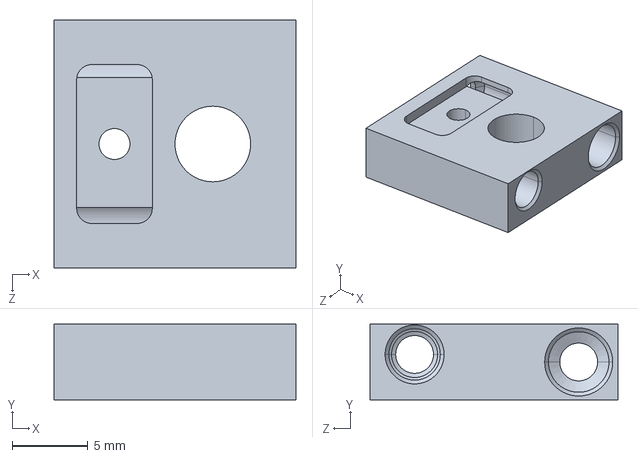
[picture p118: CAD file, 2017-10-18]
2101/2101-C/2101-C.STEP
16.0 x 5.00 x 16.4 mm
