Ultimaker/Ultimaker3Extended/2102/2102-G/2102-G.STEP

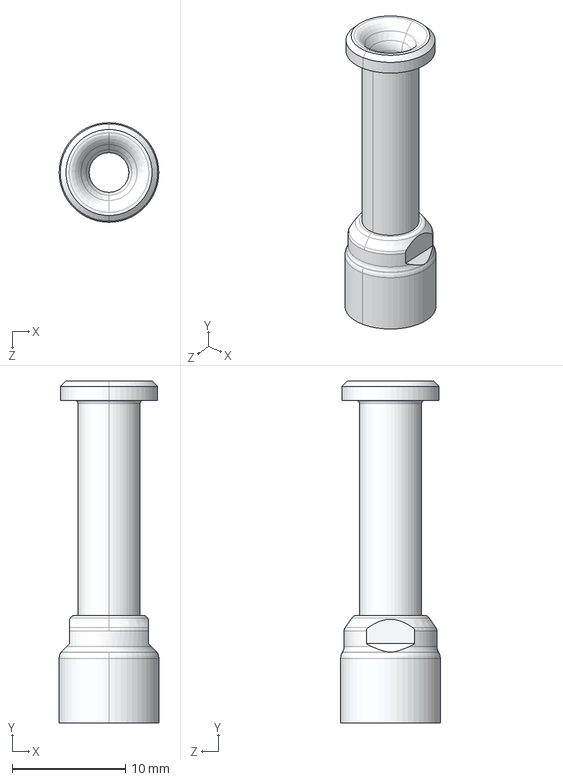
[picture p119: CAD file, 2017-10-18]
2102/2102-G/2102-G.STEP
8.80 x 30.2 x 8.80 mm
