Ultimaker/Ultimaker3Extended/2103/2103-E/2103-E.STEP

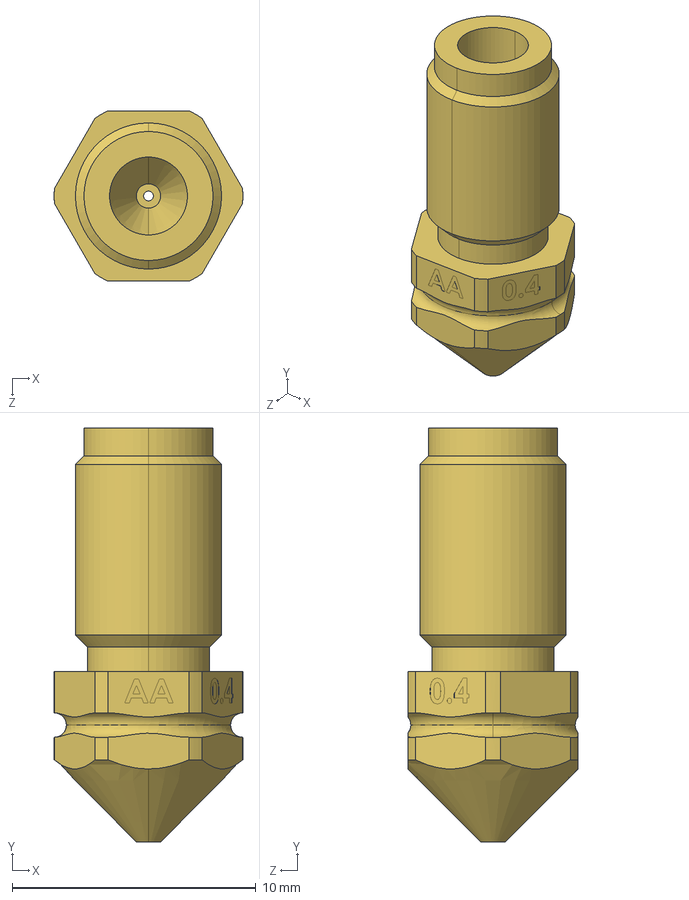
[picture p120: CAD file, 2017-10-18]
2103/2103-E/2103-E.STEP
7.75 x 17.0 x 7.00 mm
