Ultimaker/Ultimaker3Extended/2107/2107-F/2107-F.STEP

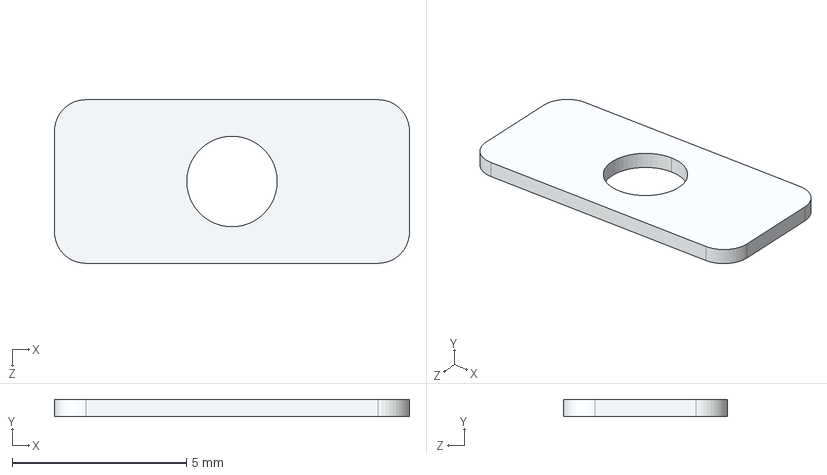
[picture p121: CAD file, 2017-10-18]
2107/2107-F/2107-F.STEP
10.2 x 0.5 x 4.70 mm
