Ultimaker/Ultimaker3Extended/2108/2108-K/2108-K.STEP

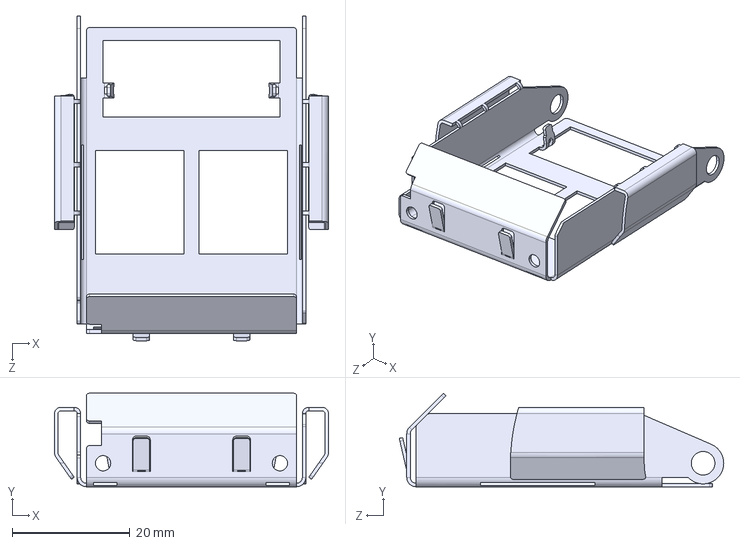
[picture p122: CAD file, 2017-10-18]
2108/2108-K/2108-K.STEP
46.5 x 15.9 x 55.1 mm
