Ultimaker/Ultimaker3Extended/2113/2113-F/2113-F.STEP

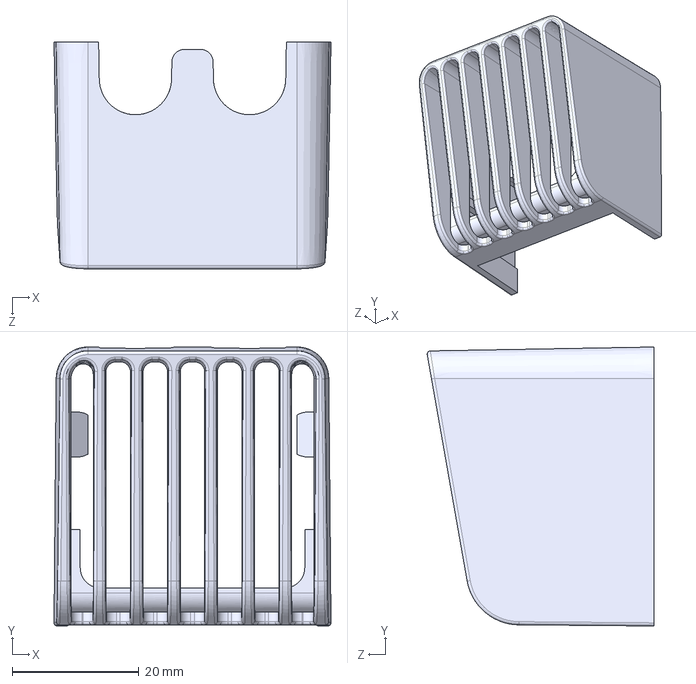
[picture p123: CAD file, 2017-10-18]
2113/2113-F/2113-F.STEP
43.7 x 44.0 x 35.7 mm
