Ultimaker/Ultimaker3Extended/2114/2114-G/2114-G.STEP

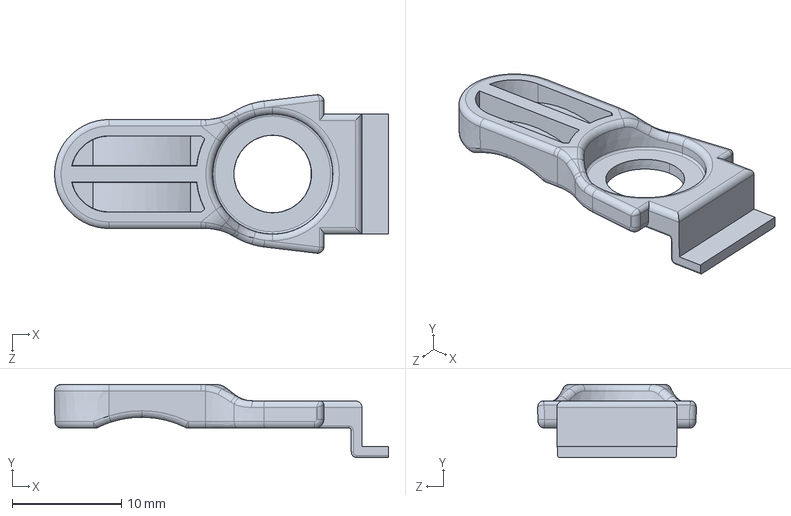
[picture p124: CAD file, 2017-10-18]
2114/2114-G/2114-G.STEP
30.6 x 6.70 x 14.5 mm
