Ultimaker/Ultimaker3Extended/2116/2116-H/2116-H.STEP

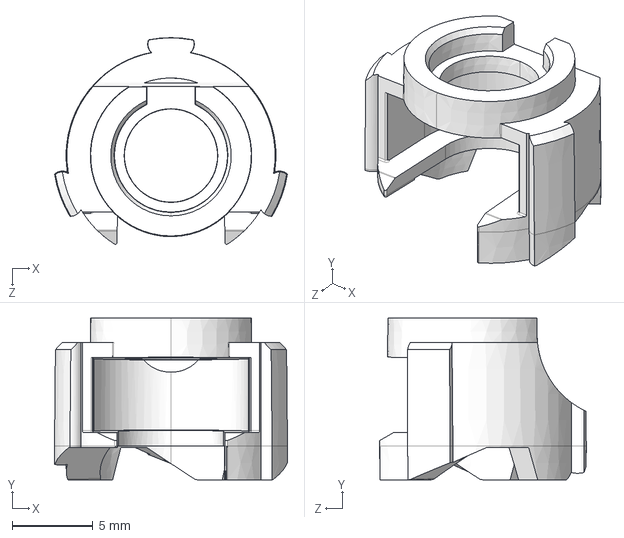
[picture p125: CAD file, 2017-10-18]
2116/2116-H/2116-H.STEP
14.4 x 10.0 x 12.8 mm
