Ultimaker/Ultimaker3Extended/2117/2117-G/2117-G.STEP

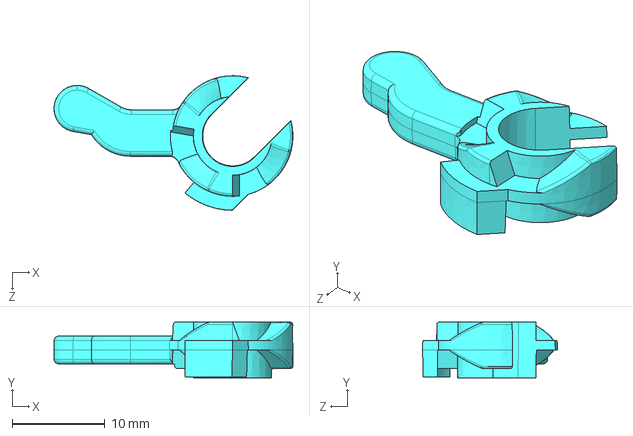
[picture p126: CAD file, 2017-10-18]
2117/2117-G/2117-G.STEP
25.7 x 6.00 x 14.5 mm
