Ultimaker/Ultimaker3Extended/2118/2118-G/2118-G.step

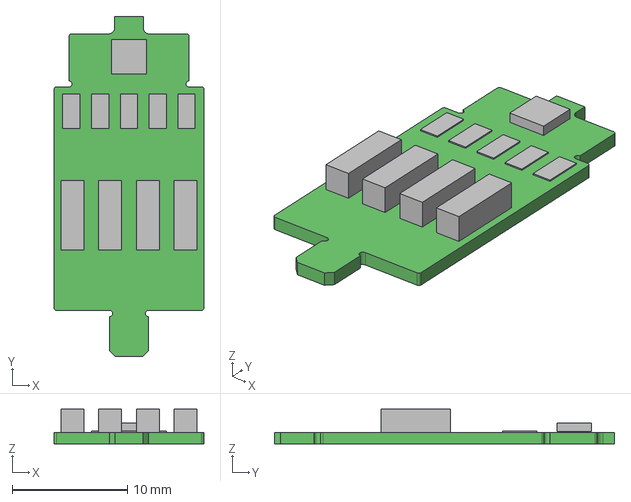
[picture p127: CAD file, 2017-10-18]
2118/2118-G/2118-G.step
13.0 x 29.5 x 3.00 mm
Board
Extruded x 10
