Ultimaker/Ultimaker3Extended/2123/2123-A/2123-A.STEP

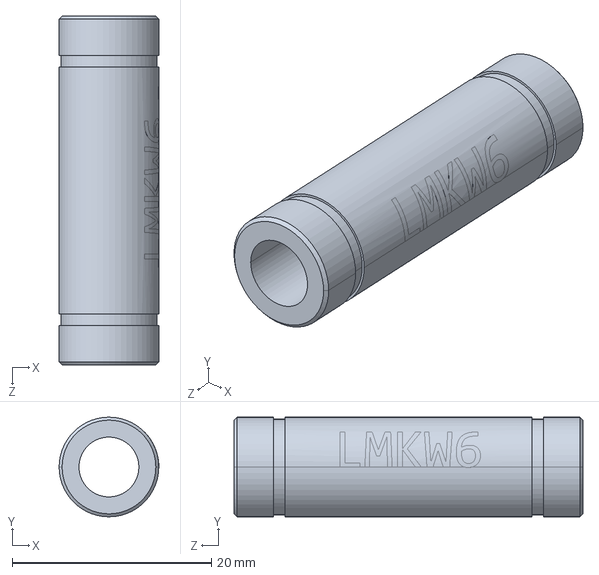
[picture p128: CAD file, 2017-10-18]
2123/2123-A/2123-A.STEP
10.0 x 10.0 x 35.0 mm
