Ultimaker/Ultimaker3Extended/2128/2128-A/2128-A.step

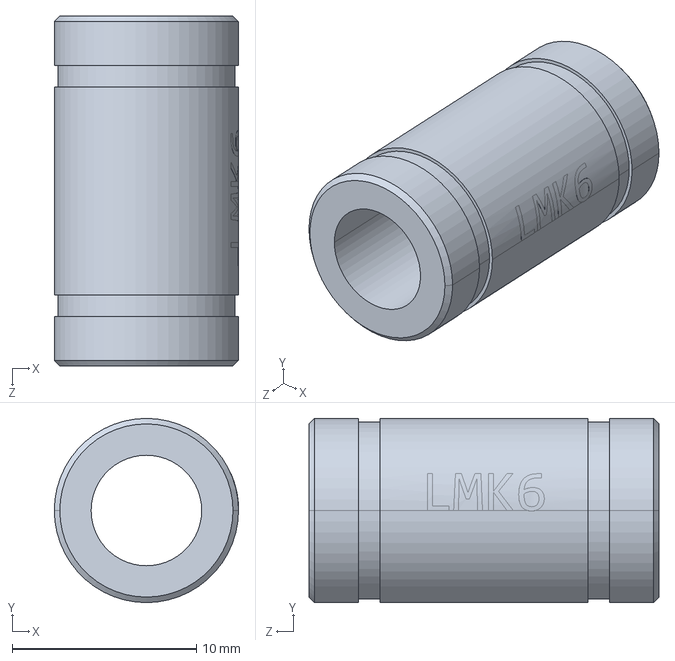
[picture p129: CAD file, 2017-10-18]
2128/2128-A/2128-A.step
10.0 x 10.0 x 19.0 mm
