Ultimaker/Ultimaker3Extended/2129/2129-F/2129-F.STEP

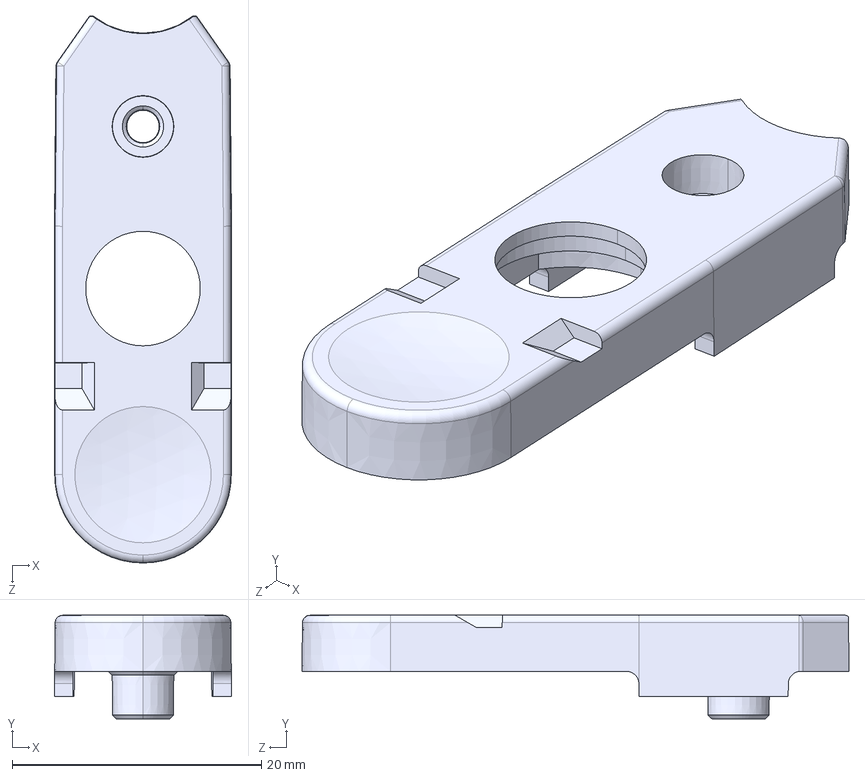
[picture p130: CAD file, 2017-10-18]
2129/2129-F/2129-F.STEP
14.2 x 8.30 x 43.9 mm
