Ultimaker/Ultimaker3Extended/2130/2130-B/2130-B.step

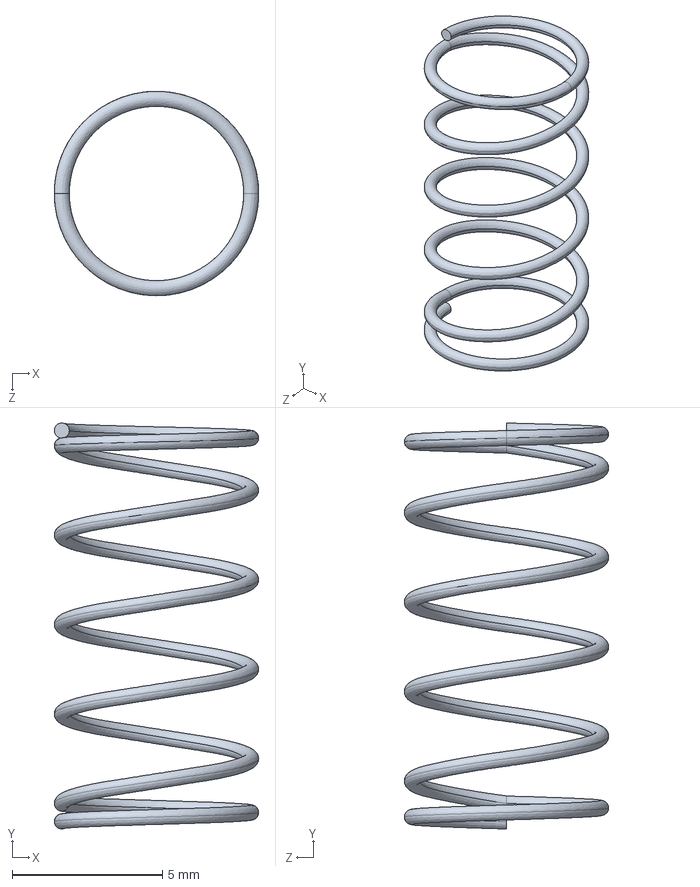
[picture p131: CAD file, 2017-10-18]
2130/2130-B/2130-B.step
6.80 x 13.5 x 6.80 mm
