Ultimaker/Ultimaker3Extended/2131/2131-B/2131-B.STEP

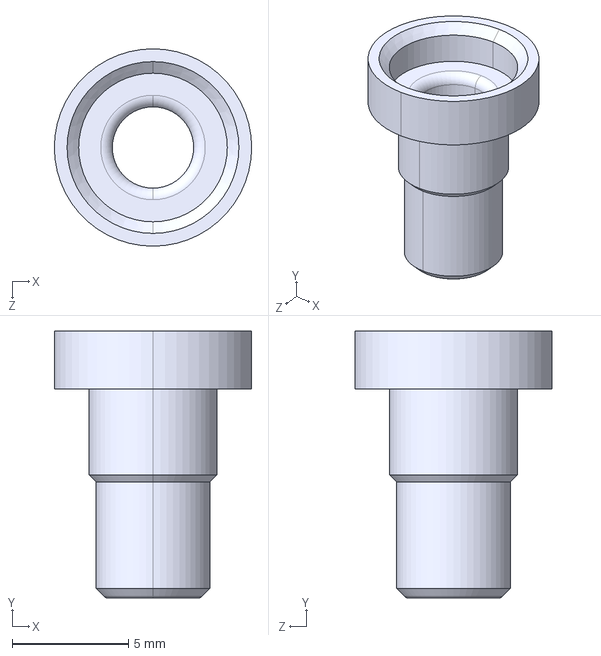
[picture p132: CAD file, 2017-10-18]
2131/2131-B/2131-B.STEP
8.50 x 11.5 x 8.50 mm
