Ultimaker/Ultimaker3Extended/2133/2133-C/2133-C.STEP

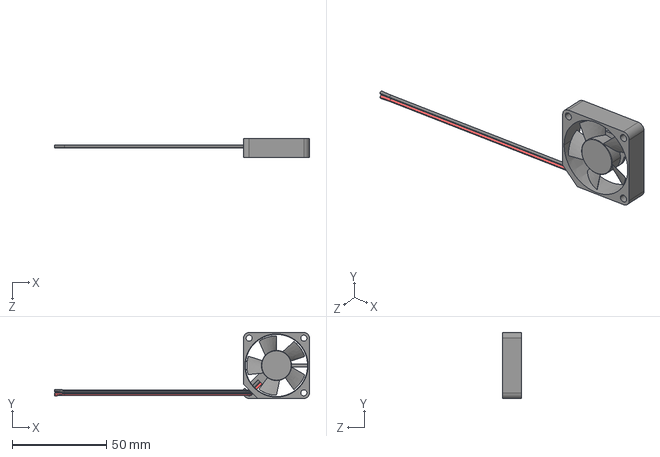
[picture p133: CAD file, 2017-10-18]
2133/2133-C/2133-C.STEP
135.2 x 35.0 x 10.0 mm
