Ultimaker/Ultimaker3Extended/2135/2135-B/2135-B.STEP

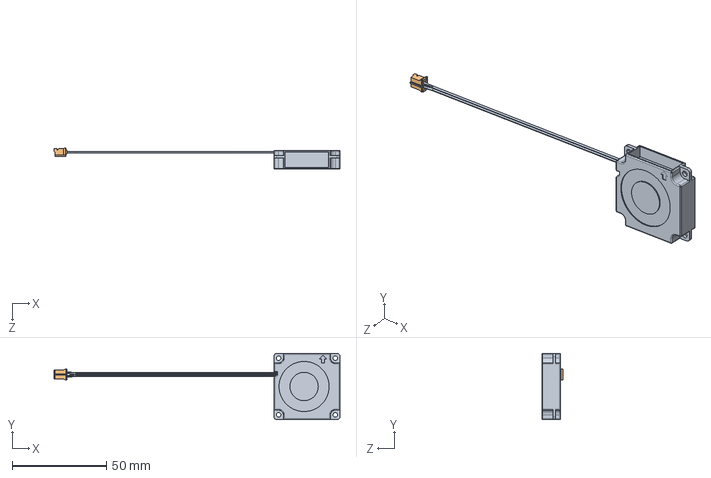
[picture p134: CAD file, 2017-10-18]
2135/2135-B/2135-B.STEP
151.3 x 35.0 x 11.4 mm
2135-B_Right Fan
PHR-2
