Ultimaker/Ultimaker3Extended/2136/2136-F/2136-F.STEP

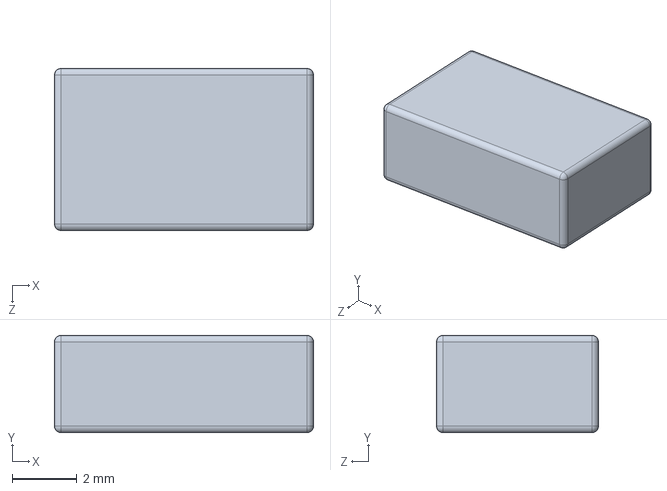
[picture p135: CAD file, 2017-10-18]
2136/2136-F/2136-F.STEP
8.00 x 3.00 x 5.00 mm
