Ultimaker/Ultimaker3Extended/2137/2137-A/2137-A.STEP

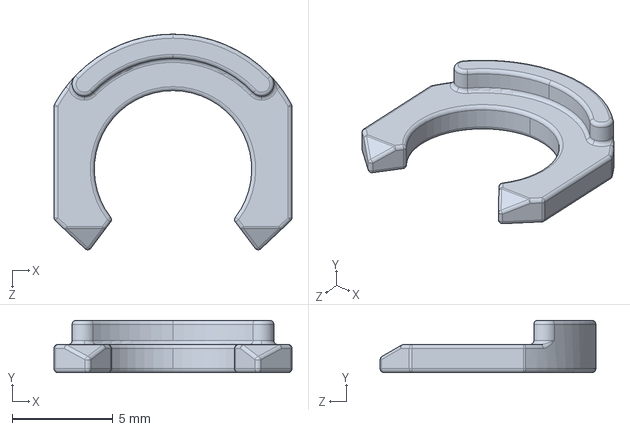
[picture p136: CAD file, 2017-10-18]
2137/2137-A/2137-A.STEP
11.8 x 2.60 x 10.7 mm
