Ultimaker/Ultimaker3Extended/2138/2138-G/2138-G.STEP

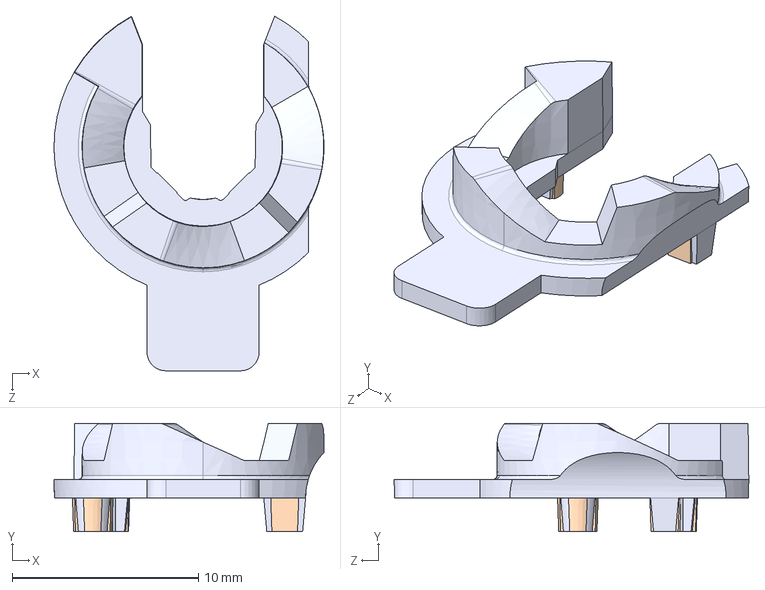
[picture p137: CAD file, 2017-10-18]
2138/2138-G/2138-G.STEP
14.5 x 5.80 x 19.0 mm
