Ultimaker/Ultimaker3Extended/2139/2139-A/2139-A.step

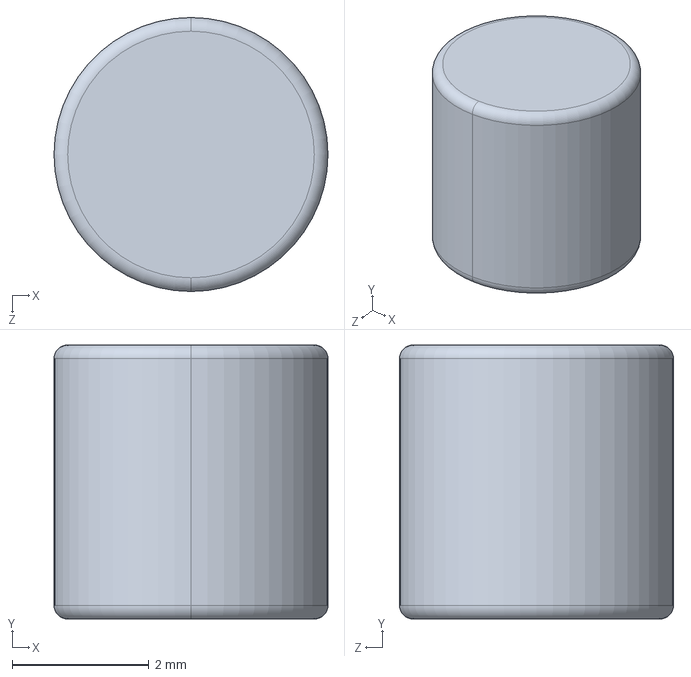
[picture p138: CAD file, 2017-10-18]
2139/2139-A/2139-A.step
4.00 x 4.00 x 4.00 mm
