Ultimaker/Ultimaker3Extended/2142/2142-A/2142-A.step

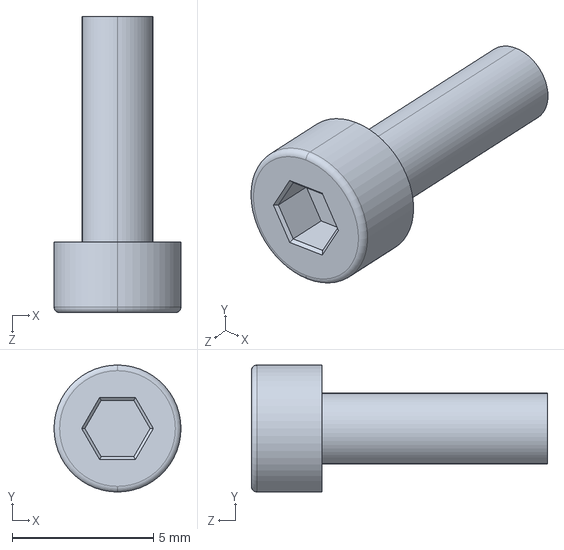
[picture p139: CAD file, 2017-10-18]
2142/2142-A/2142-A.step
4.50 x 4.50 x 10.5 mm
