Ultimaker/Ultimaker3Extended/2144/2144-C/2144-C.STEP

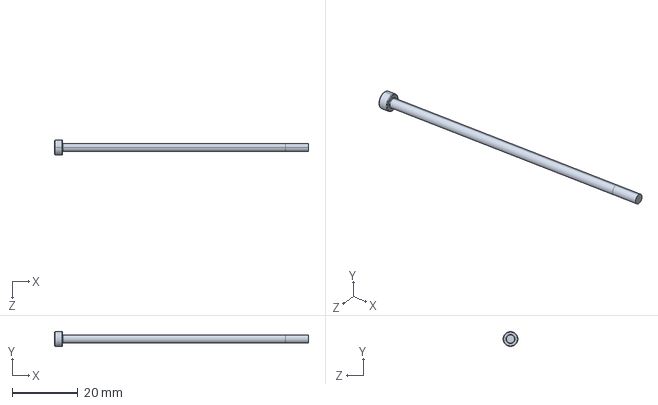
[picture p140: CAD file, 2017-10-18]
2144/2144-C/2144-C.STEP
77.5 x 4.50 x 4.50 mm
