Ultimaker/Ultimaker3Extended/2147/2147-D/2147-D.STEP

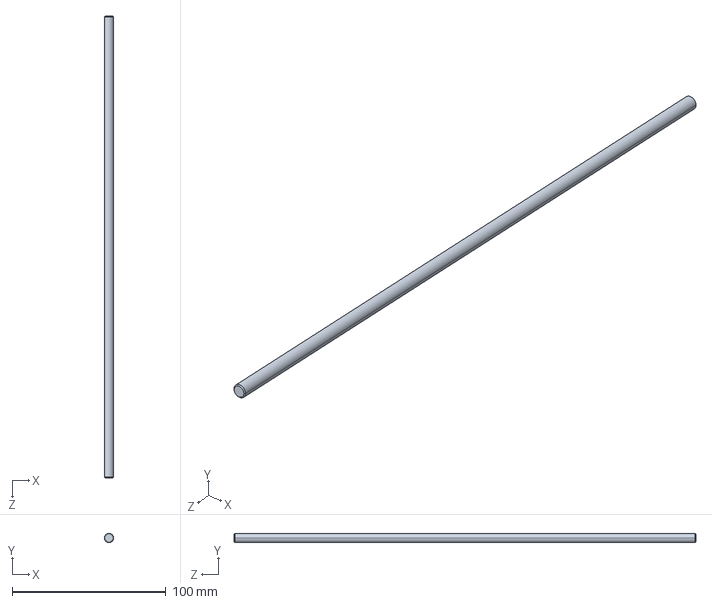
[picture p141: CAD file, 2017-10-18]
2147/2147-D/2147-D.STEP
6.00 x 6.00 x 300.5 mm
