Ultimaker/Ultimaker3Extended/2148/2148-C/2148-C.STEP

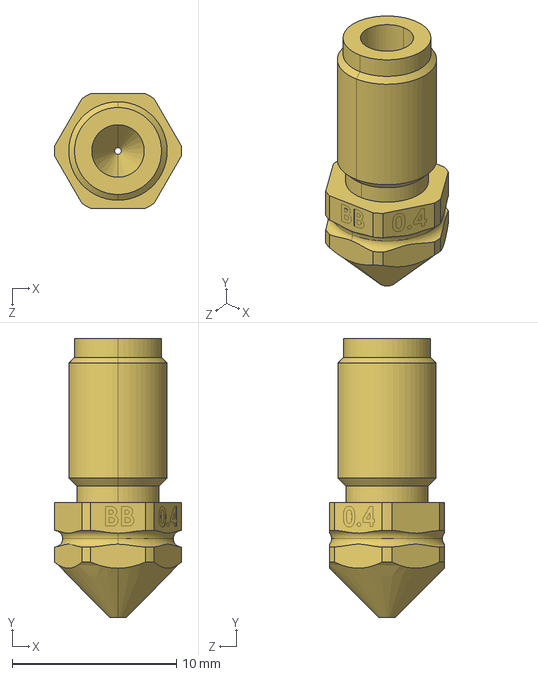
[picture p142: CAD file, 2017-10-18]
2148/2148-C/2148-C.STEP
7.75 x 17.0 x 7.00 mm
