Ultimaker/Ultimaker3Extended/2151/2151-E/2151-E.STEP

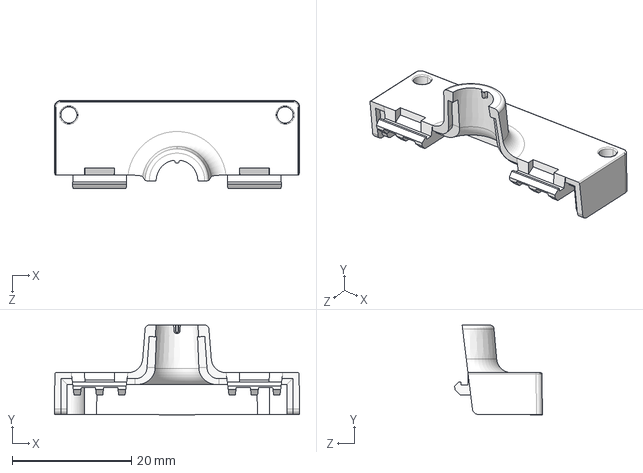
[picture p143: CAD file, 2017-10-18]
2151/2151-E/2151-E.STEP
41.1 x 15.1 x 14.7 mm
