Ultimaker/Ultimaker3Extended/2152/2152-A/2152-A.STEP

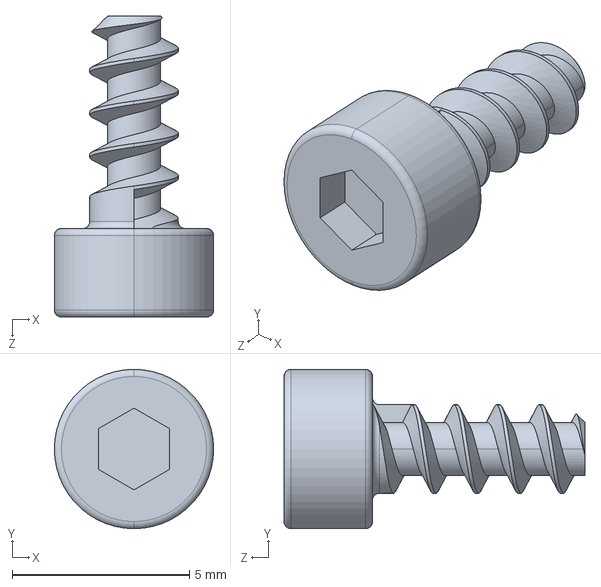
[picture p144: CAD file, 2017-10-18]
2152/2152-A/2152-A.STEP
4.50 x 4.50 x 8.50 mm
