Ultimaker/Ultimaker3Extended/2153/2153-A/2153-A.step

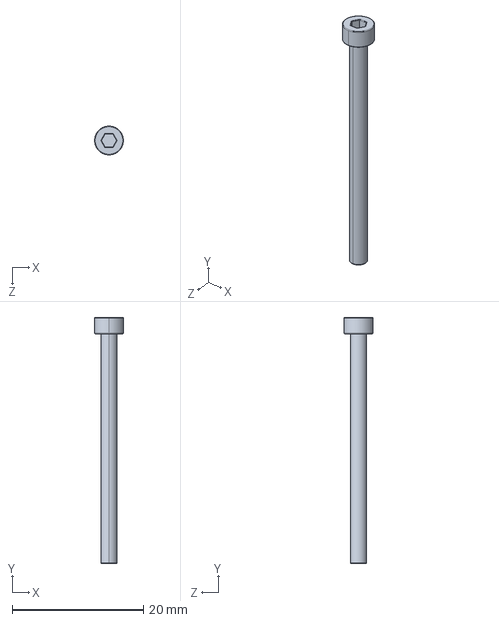
[picture p145: CAD file, 2017-10-18]
2153/2153-A/2153-A.step
4.40 x 37.5 x 4.40 mm
