Ultimaker/Ultimaker3Extended/2154/2154-D/2154-D.STEP

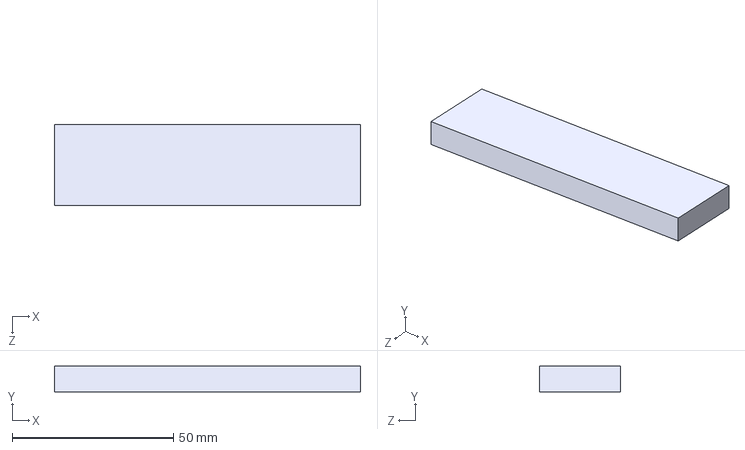
[picture p146: CAD file, 2017-10-18]
2154/2154-D/2154-D.STEP
95.0 x 8.00 x 25.0 mm
