Ultimaker/Ultimaker3Extended/2158/2158-B/2158-B.STEP

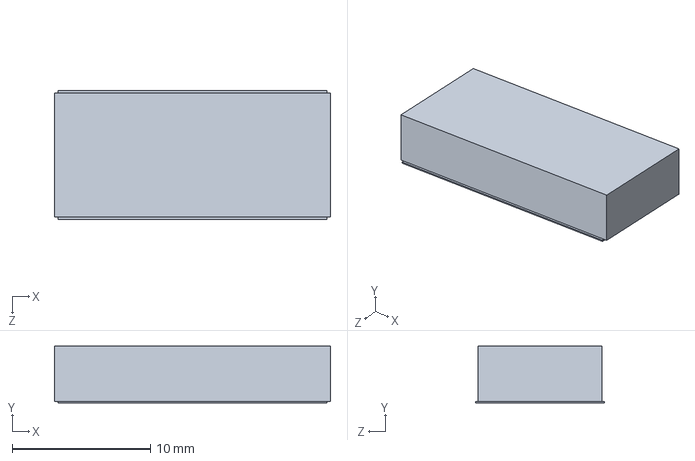
[picture p147: CAD file, 2017-10-18]
2158/2158-B/2158-B.STEP
20.0 x 4.10 x 9.38 mm
