Ultimaker/Ultimaker3Extended/(list of files, cad)

Other CAD files:
1481/1481-B/1481-B.STEP
1964/1964-N/1964-N.STEP
1988/1988-D/1988-D.STEP
2161/2161-C/2161-C.STEP
2163/2163-A/2163-A.STEP
2165/2165-D/2165-D.step
2166/2166-D/2166-D.step
2180/2180-C/2180-C.step
2181/2181-B/2181-B.step
2182/2182-H/2182-H.step
2183/2183-F/2183-F.step
2184/2184-I/2184-I.step
2185/2185-F/2185-F.step
2186/2186-A/2186-A.STEP
2187/2187-B/2187-B.STEP
2188/2188-A/2188-A.STEP
2189/2189-C/2189-C.STEP
2191/2191-B/2191-B.STEP
2192/2192-B/2192-B.STEP
2193/2193-A/2193-A.STEP
2194/2194-A/2194-A.STEP
2195/2195-A/2195-A.STEP
2196/2196-B/2196-B.STEP
2201/2201-G/2201-G.STEP
2242/2242-A/2242-A.step
2243/2243-A/2243-A.step
2867/2867-B/2867-B.step
