Ultimaker/Ultimaker3Extended/BOM/BOM Ultimaker 3 extended.pdf

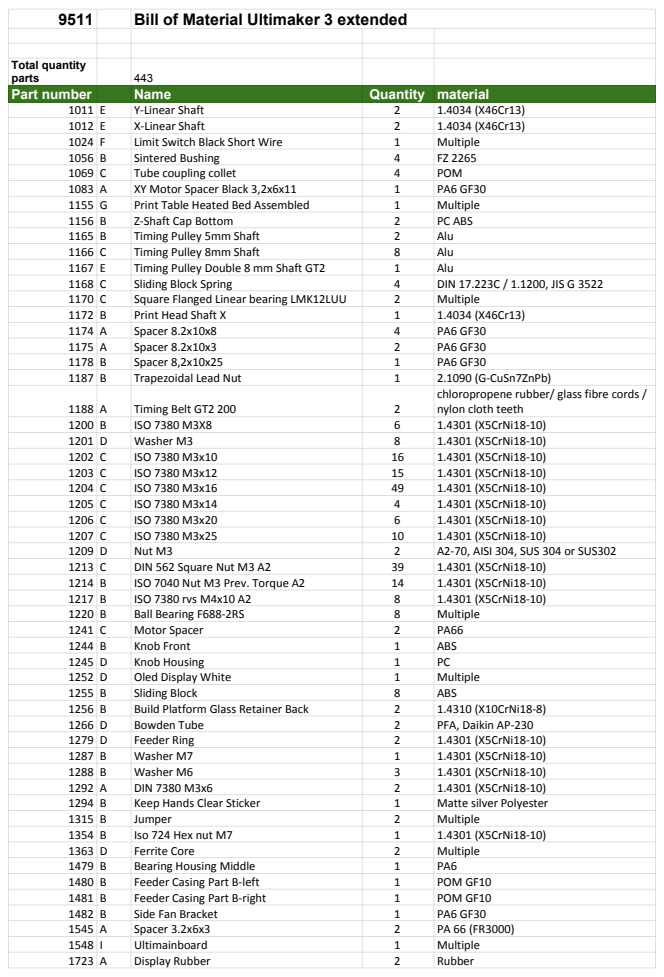
[picture p159: page 1]
Total quantity; parts; Part number; Name; Quantity material; Y-Linear Shaft; X-Linear Shaft; Limit Switch Black Short Wire; Multiple; Sintered Bushing; Tube coupling collet; POM; XY Motor Spacer Black 3,2x6x11; Print Table Heated Bed Assembled; Z-Shaft Cap Bottom; PC ABS; Timing Pulley 5mm Shaft; Alu; Timing Pulley 8mm Shaft; Timing Pulley Double 8 mm Shaft GT2; Sliding Block Spring; DIN 17.223C / 1.1200, JIS G 3522; Square Flanged Linear bearing LMK12LUU; Print Head Shaft X; Spacer 8.2x10x8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

9511 Bill of Material Ultimaker 3 extended

chloropropene rubber/ glass fibre cords /
nylon cloth teeth

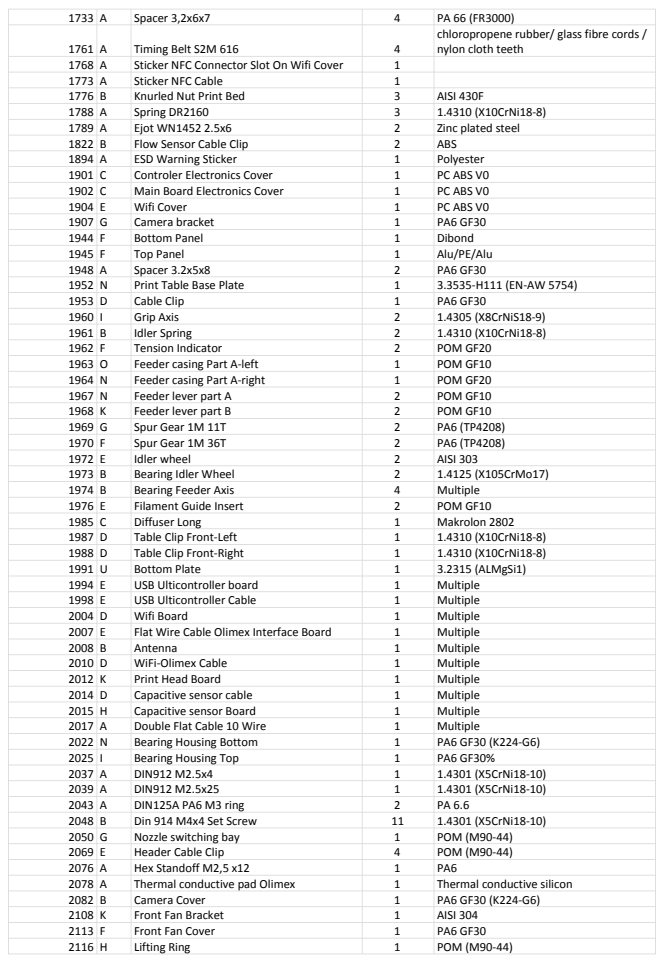
[picture p160: page 2]
Spacer 3,2x6x7; Timing Belt S2M 616; Sticker NFC Connector Slot On Wifi Cover; Sticker NFC Cable; Knurled Nut Print Bed; AISI 430F; Spring DR2160; 1.4310 (X10CrNi18-8); Ejot WN1452 2.5x6; Zinc plated steel; Flow Sensor Cable Clip; ABS; ESD Warning Sticker; Polyester; Controler Electronics Cover; PC ABS V0; Main Board Electronics Cover; Wifi Cover; Camera bracket; Bottom Panel; Dibond; Top Panel; Alu/PE/Alu; Spacer 3.2x5x8; Print Table Base Plate; Cable Clip; Grip Axis; 1.4305 (X8CrNiS18-9)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

chloropropene rubber/ glass fibre cords /
nylon cloth teeth

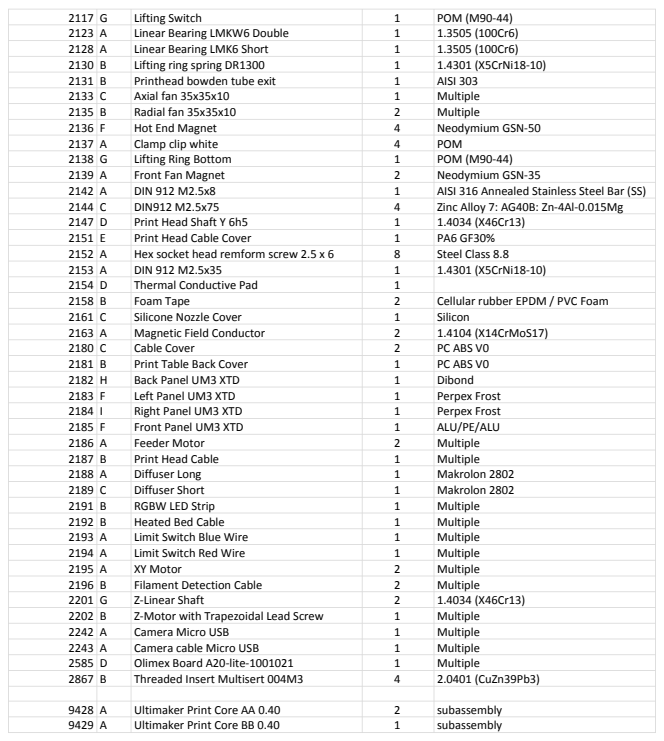
[picture p161: page 3]
Lifting Switch; POM (M90-44); Linear Bearing LMKW6 Double; Linear Bearing LMK6 Short; Lifting ring spring DR1300; 1.4301 (X5CrNi18-10); Printhead bowden tube exit; AISI 303; Axial fan 35x35x10; Multiple; Radial fan 35x35x10; Hot End Magnet; Neodymium GSN-50; Clamp clip white; POM; Lifting Ring Bottom; Front Fan Magnet; Neodymium GSN-35; DIN 912 M2.5x8; AISI 316 Annealed Stainless Steel Bar (SS); DIN912 M2.5x75; Zinc Alloy 7: AG40B: Zn-4Al-0.015Mg; Print Head Shaft Y 6h5; Print Head Cable Cover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
