Ultimaker/Ultimaker3Extended/PCB files/1726-B NFC antenna/Schematics and layout pdf/RFID_PCB_Antenna_Schematic Prints_1726-B.PDF

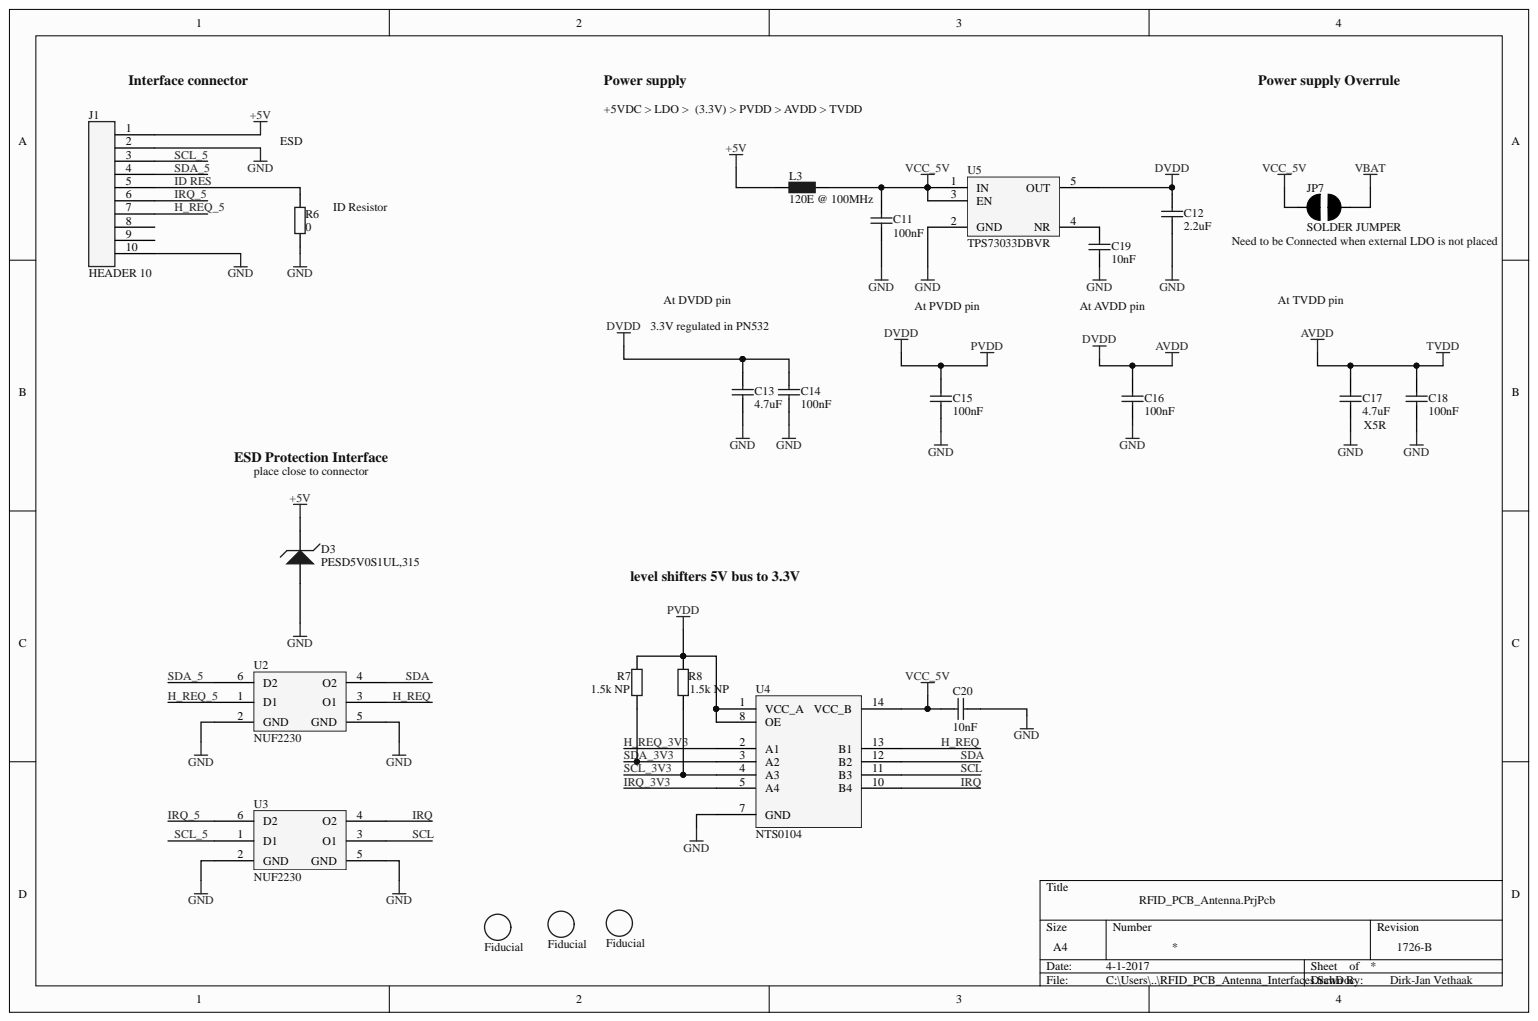
[picture p162: page 1]

+5VDC > LDO > (3.3V) > PVDD > AVDD > TVDD

Need to be Connected when external LDO is not placed

ESD Protection Interface
place close to connector

level shifters 5V bus to 3.3V

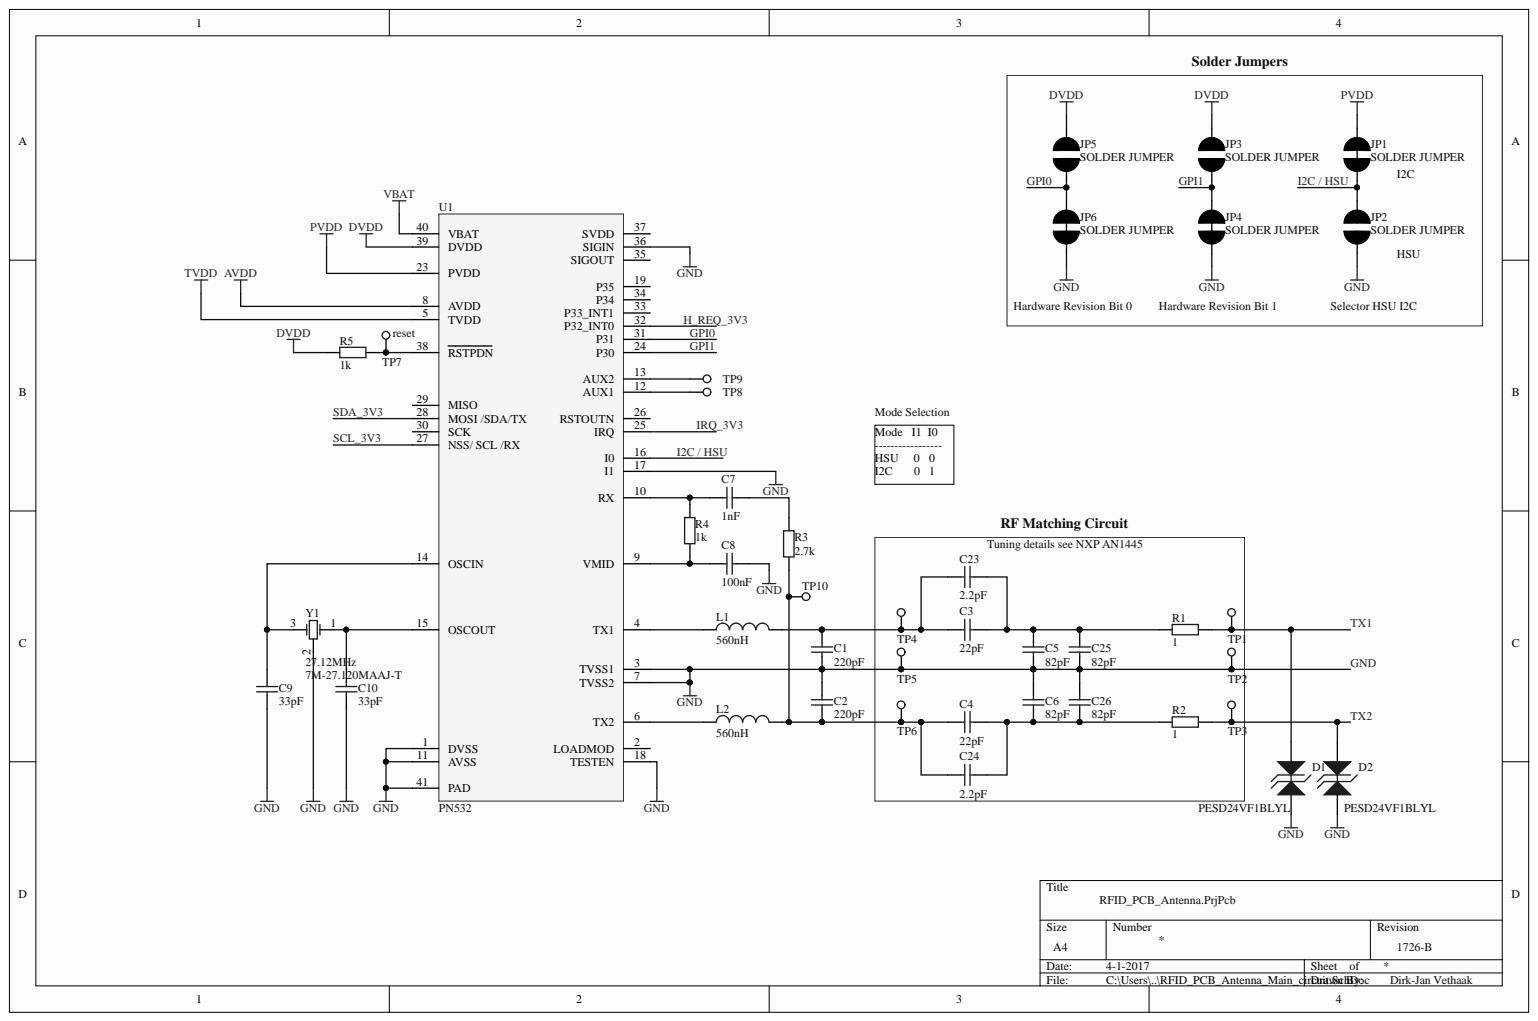
[picture p163: page 2]

C23 | | Tuning details see NXP AN1445

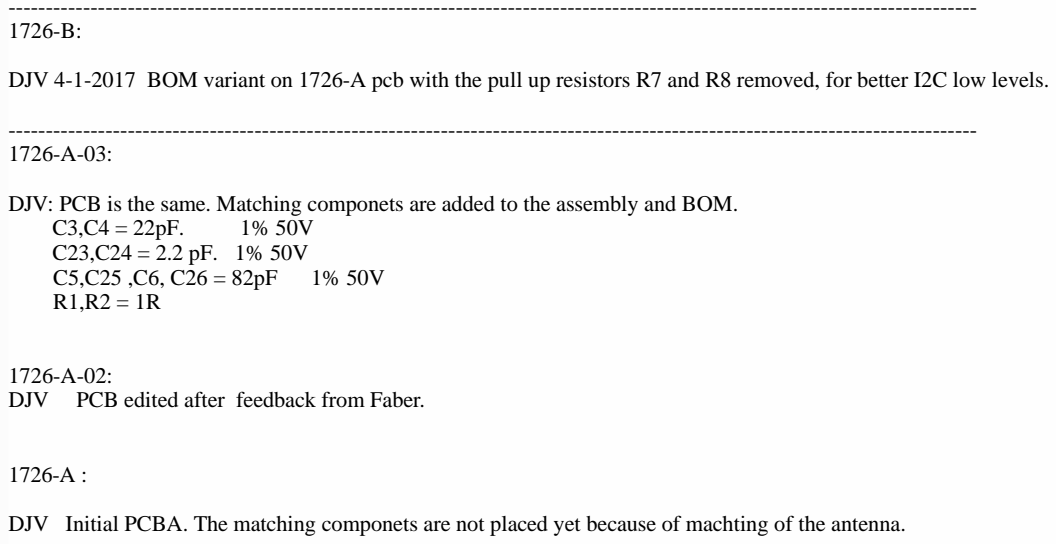
[picture p164: page 3]

DJV 4-1-2017 BOM variant on 1726-A pcb with the pull up resistors R7 and R8 removed, for better I2C low levels.

DJV: PCB is the same. Matching componets are added to the assembly and BOM.

DJV Initial PCBA. The matching componets are not placed yet because of machting of the antenna.
