Ultimaker/Ultimaker3Extended/PCB files/2015-H Capacitive sensor/Schematic and layout pdf/Schematic Prints.PDF

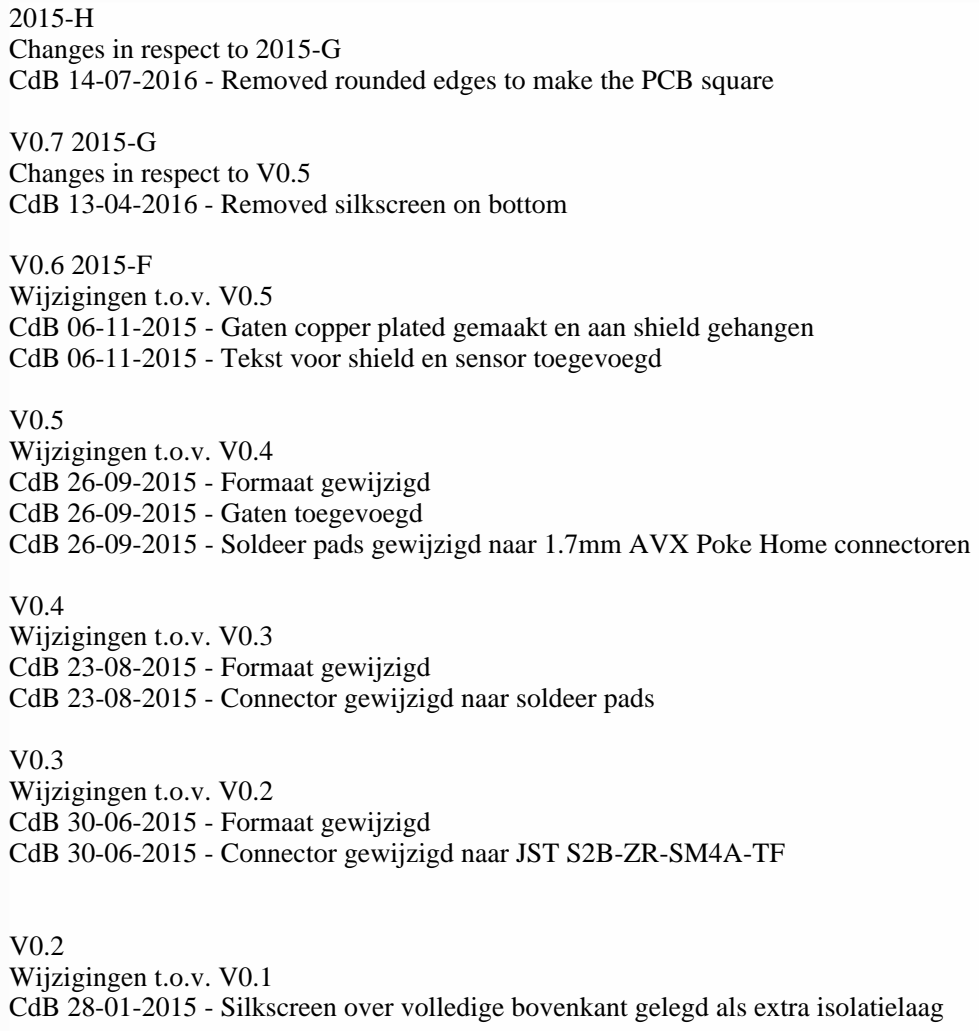
[picture p165: page 1]

Changes in respect to 2015-G
CdB 14-07-2016 - Removed rounded edges to make the PCB square

Changes in respect to V0.5
CdB 13-04-2016 - Removed silkscreen on bottom

Wijzigingen t.o.v. V0.5
CdB 06-11-2015 - Gaten copper plated gemaakt en aan shield gehangen
CdB 06-11-2015 - Tekst voor shield en sensor toegevoegd

Wijzigingen t.o.v. V0.4
CdB 26-09-2015 - Formaat gewijzigd
CdB 26-09-2015 - Gaten toegevoegd
CdB 26-09-2015 - Soldeer pads gewijzigd naar 1.7mm AVX Poke Home connectoren

Wijzigingen t.o.v. V0.3
CdB 23-08-2015 - Formaat gewijzigd
CdB 23-08-2015 - Connector gewijzigd naar soldeer pads

Wijzigingen t.o.v. V0.2
CdB 30-06-2015 - Formaat gewijzigd
CdB 30-06-2015 - Connector gewijzigd naar JST S2B-ZR-SM4A-TF

Wijzigingen t.o.v. V0.1
CdB 28-01-2015 - Silkscreen over volledige bovenkant gelegd als extra isolatielaag

Capacitive Sensor Board Title | * * * * *

Size: A4 | Number: * | Revision: 2015-H
Date: 14-7-2016 Time: 14:54:14 | | Sheet * of *

D:\Google Drive\040 Research & Development\Electronics\Capacitive sensor board\Capacitive sensor board 2015-H\Revisions.SchDoc

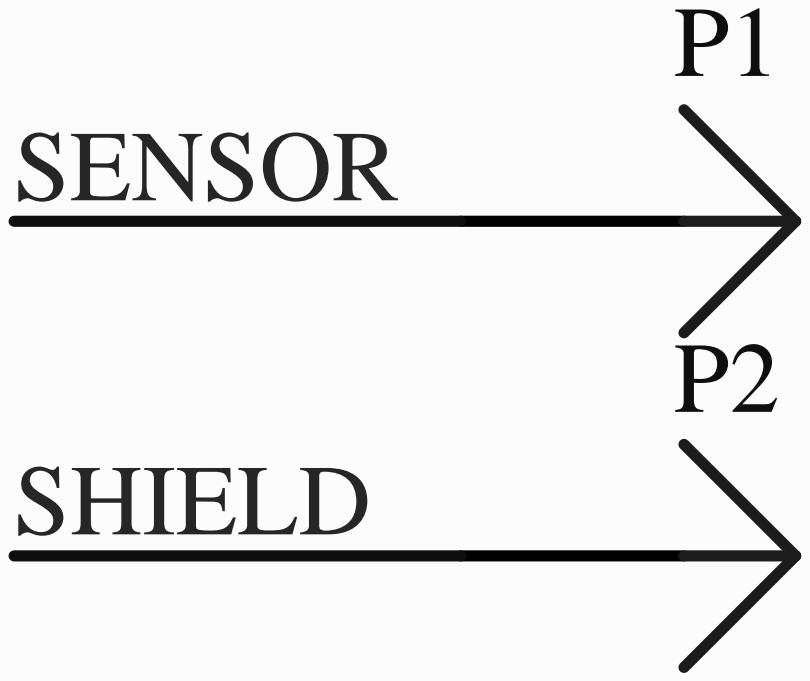
[picture p166: page 2]

Capacitive Sensor Board Title | * * * * *

Size: A4 | Number: * | Revision: 2015-H
Date: 14-7-2016 Time: 14:54:14 | | Sheet * of *

D:\Google Drive\040 Research & Development\Electronics\Capacitive sensor board\Capacitive sensor board 2015-H\Sheet1.SchDoc
