Ultimaker/Ultimaker3Extended/PCB files/2118-G Cartridge PCB/Project Outputs for Cartridge PCB/Schematic Prints.PDF

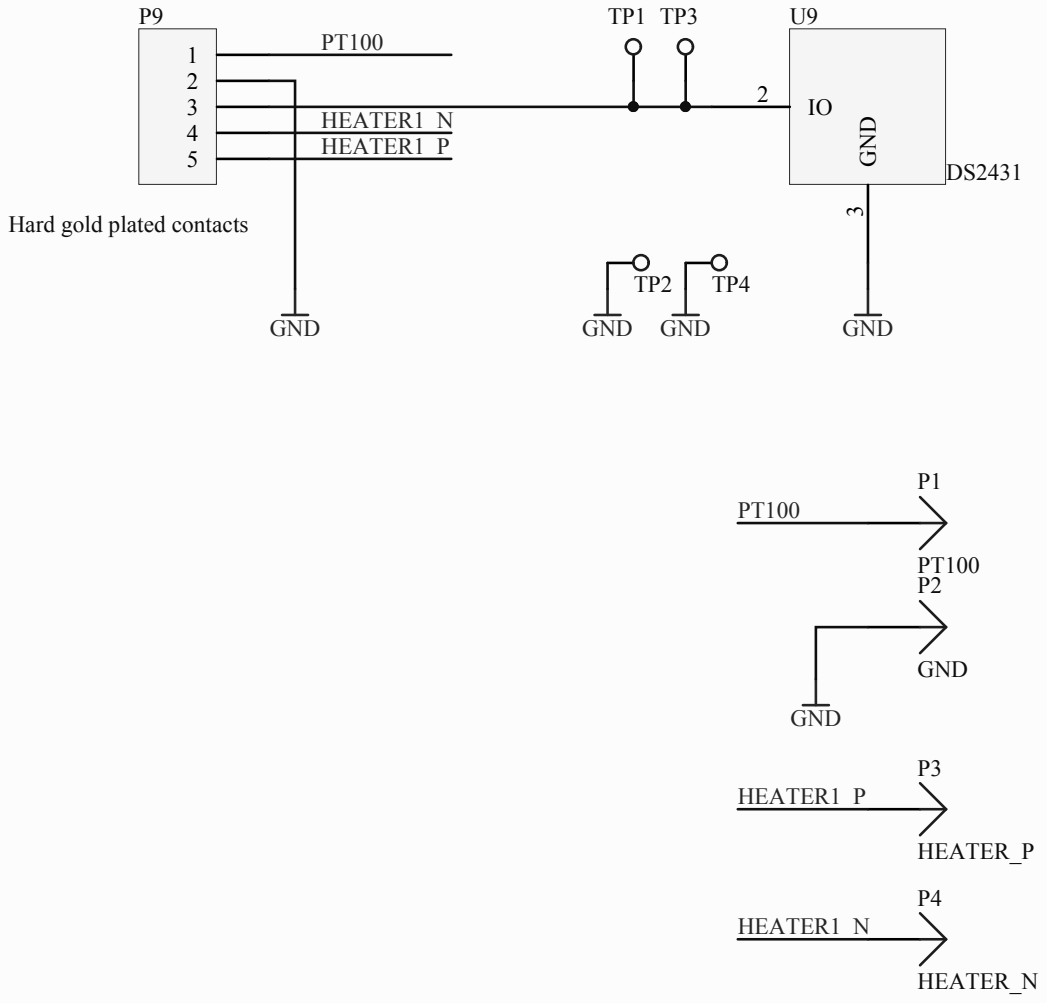
[picture p167: page 1]

Hard gold plated contacts

Cartridge PCB Title | * * * * *

Size: A4 | Number: * | Revision: 0.5 2118-G
Date: 6-11-2015 Time: 17:14:57 | | Sheet * of *

D:\Google Drive\040 Research & Development\Electronics\cartridge pcb\Cartridge PCB 2118-G\Cartridge PCB.SchDoc

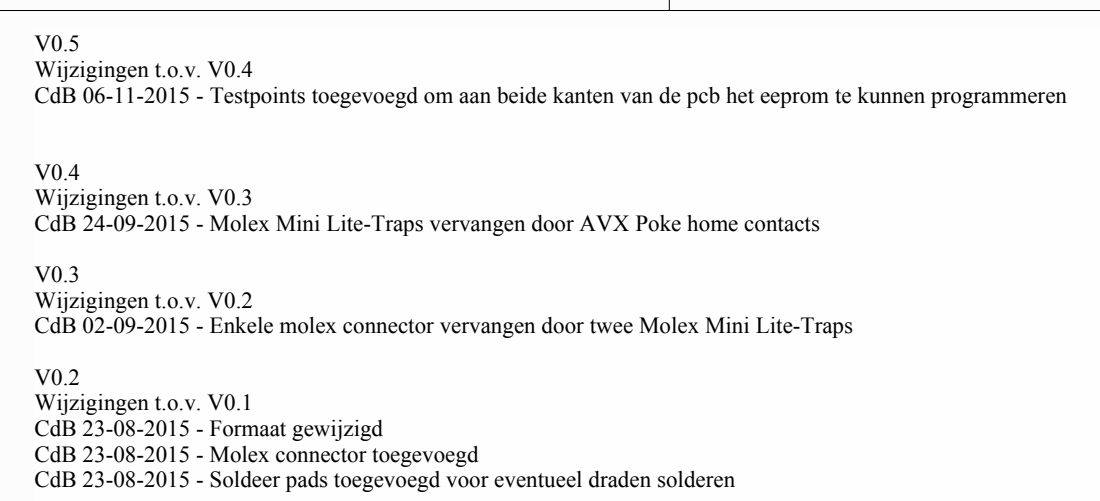
[picture p168: page 2]

Wijzigingen t.o.v. V0.4
CdB 06-11-2015 - Testpoints toegevoegd om aan beide kanten van de pcb het eeprom te kunnen programmeren

Wijzigingen t.o.v. V0.3
CdB 24-09-2015 - Molex Mini Lite-Traps vervangen door AVX Poke home contacts

Wijzigingen t.o.v. V0.2
CdB 02-09-2015 - Enkele molex connector vervangen door twee Molex Mini Lite-Traps

Wijzigingen t.o.v. V0.1
CdB 23-08-2015 - Formaat gewijzigd
CdB 23-08-2015 - Molex connector toegevoegd
CdB 23-08-2015 - Soldeer pads toegevoegd voor eventueel draden solderen

Cartridge PCB Title | * * * * *

Size: A4 | Number: * | Revision: V0.5 2118-G
Date: 6-11-2015 Time: 17:14:57 | | Sheet * of *

D:\Google Drive\040 Research & Development\Electronics\cartridge pcb\Cartridge PCB 2118-G\Revisions.SchDoc
