Ultimaker/Ultimaker3Extended/(list of files, drawings)

Other design files:
PCB files/1155-H Heated bed/Heatedbed.PcbDoc
PCB files/1155-H Heated bed/Heatedbed.PrjPcb
PCB files/1155-H Heated bed/Heatedbed.SchDoc
PCB files/1155-H Heated bed/Revisions.SchDoc
PCB files/1548-I Ultimainboard/revisies.SchDoc
PCB files/1548-I Ultimainboard/schema1.SchDoc
PCB files/1548-I Ultimainboard/schema2.SchDoc
PCB files/1548-I Ultimainboard/schema3.SchDoc
PCB files/1548-I Ultimainboard/schema4.SchDoc
PCB files/1548-I Ultimainboard/schema5.SchDoc
PCB files/1548-I Ultimainboard/Ultimainboard.PrjPcb
PCB files/1726-B NFC antenna/RFID_PCB_Antenna.PcbDoc
PCB files/1726-B NFC antenna/RFID_PCB_Antenna.PrjPcb
PCB files/1726-B NFC antenna/RFID_PCB_Antenna_Interfaces.SchDoc
PCB files/1726-B NFC antenna/RFID_PCB_Antenna_Main_circuit.SchDoc
PCB files/1726-B NFC antenna/RFID_PCB_Antenna_Revisions.SchDoc
PCB files/1994-E USB Ulticontroller/Revisies.SchDoc
PCB files/1994-E USB Ulticontroller/Sheet1.SchDoc
PCB files/1994-E USB Ulticontroller/Sheet2.SchDoc
PCB files/1994-E USB Ulticontroller/UltiController.PcbDoc
PCB files/1994-E USB Ulticontroller/UltiController.PrjPcb
PCB files/2005-H Olimex interface board/Olimex interface board.PcbDoc
PCB files/2005-H Olimex interface board/Olimex interface board.PrjPcb
PCB files/2005-H Olimex interface board/Revisions.SchDoc
PCB files/2005-H Olimex interface board/Schema1.SchDoc
PCB files/2005-H Olimex interface board/Schema2.SchDoc
PCB files/2012-K Print head PCB/Printhead2.SchDoc
PCB files/2012-K Print head PCB/Printhead.PcbDoc
PCB files/2012-K Print head PCB/printhead.PrjPcb
PCB files/2012-K Print head PCB/Printhead.SchDoc
PCB files/2012-K Print head PCB/Revisions.SchDoc
PCB files/2015-H Capacitive sensor/Capacitive sensor board.PcbDoc
PCB files/2015-H Capacitive sensor/Capacitive sensor board.PrjPcb
PCB files/2015-H Capacitive sensor/Revisions.SchDoc
PCB files/2015-H Capacitive sensor/Sheet1.SchDoc
PCB files/2118-G Cartridge PCB/Cartridge PCB.PcbDoc
PCB files/2118-G Cartridge PCB/Cartridge PCB.PrjPcb
PCB files/2118-G Cartridge PCB/Cartridge PCB.SchDoc
PCB files/2118-G Cartridge PCB/Revisions.SchDoc
