Ultimaker/Ultimaker3Extended/(commit log)

2017-10-18 initial commit
    Ultimaker 3 extended files
    [1011-E.STEP, 1012-E.STEP, 1024-F.STEP, 1056-B.STEP, 1069-C.STEP, 1083-Z1P-A.STEP, 1155-G.STEP, 1156-B.STEP]
2017-10-19 Updated the wrong untested development version to the currently shipped version
    We continuously improve our product and by accident a version was
    uploaded with a silicone flap and a front fan bracket that are still in
    experimental phase. The idea of these files is to reflect the state of
    the currently shipped machines.
2017-10-23 added missing reel holder assembly
    added missing reel holder assembly
    [1725-G.STEP, 1726-B.STEP, 1727-C.STEP, 1728-C.STEP, 1729-H.STEP, 1734-F.STEP]
